Board-Folk/Commodore-PC10-III-Reproduction/images/PC10-BOTH.png

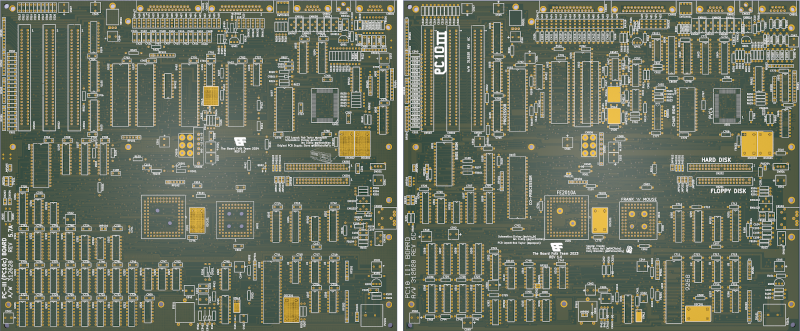
images/PC10-BOTH.png
