Board-Folk/Commodore-PC10-III-Reproduction/images/PC10-REV5-7a-small.png

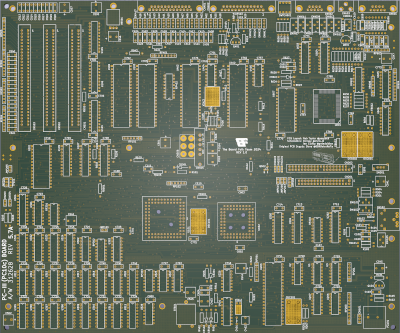
images/PC10-REV5-7a-small.png
