Board-Folk/Commodore-PC10-III-Reproduction/images/PC10-REV6a-small.png

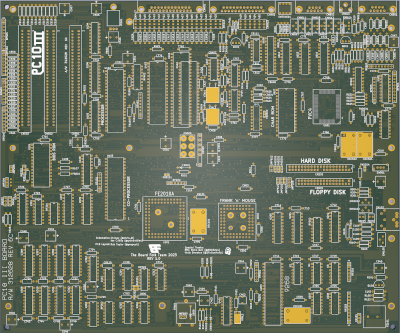
images/PC10-REV6a-small.png
