Board-Folk/Commodore-PC10-III-Reproduction/312628-REV-6C/Schematics/Commodore PC10 III Schematics 312628-Rev6c.pdf

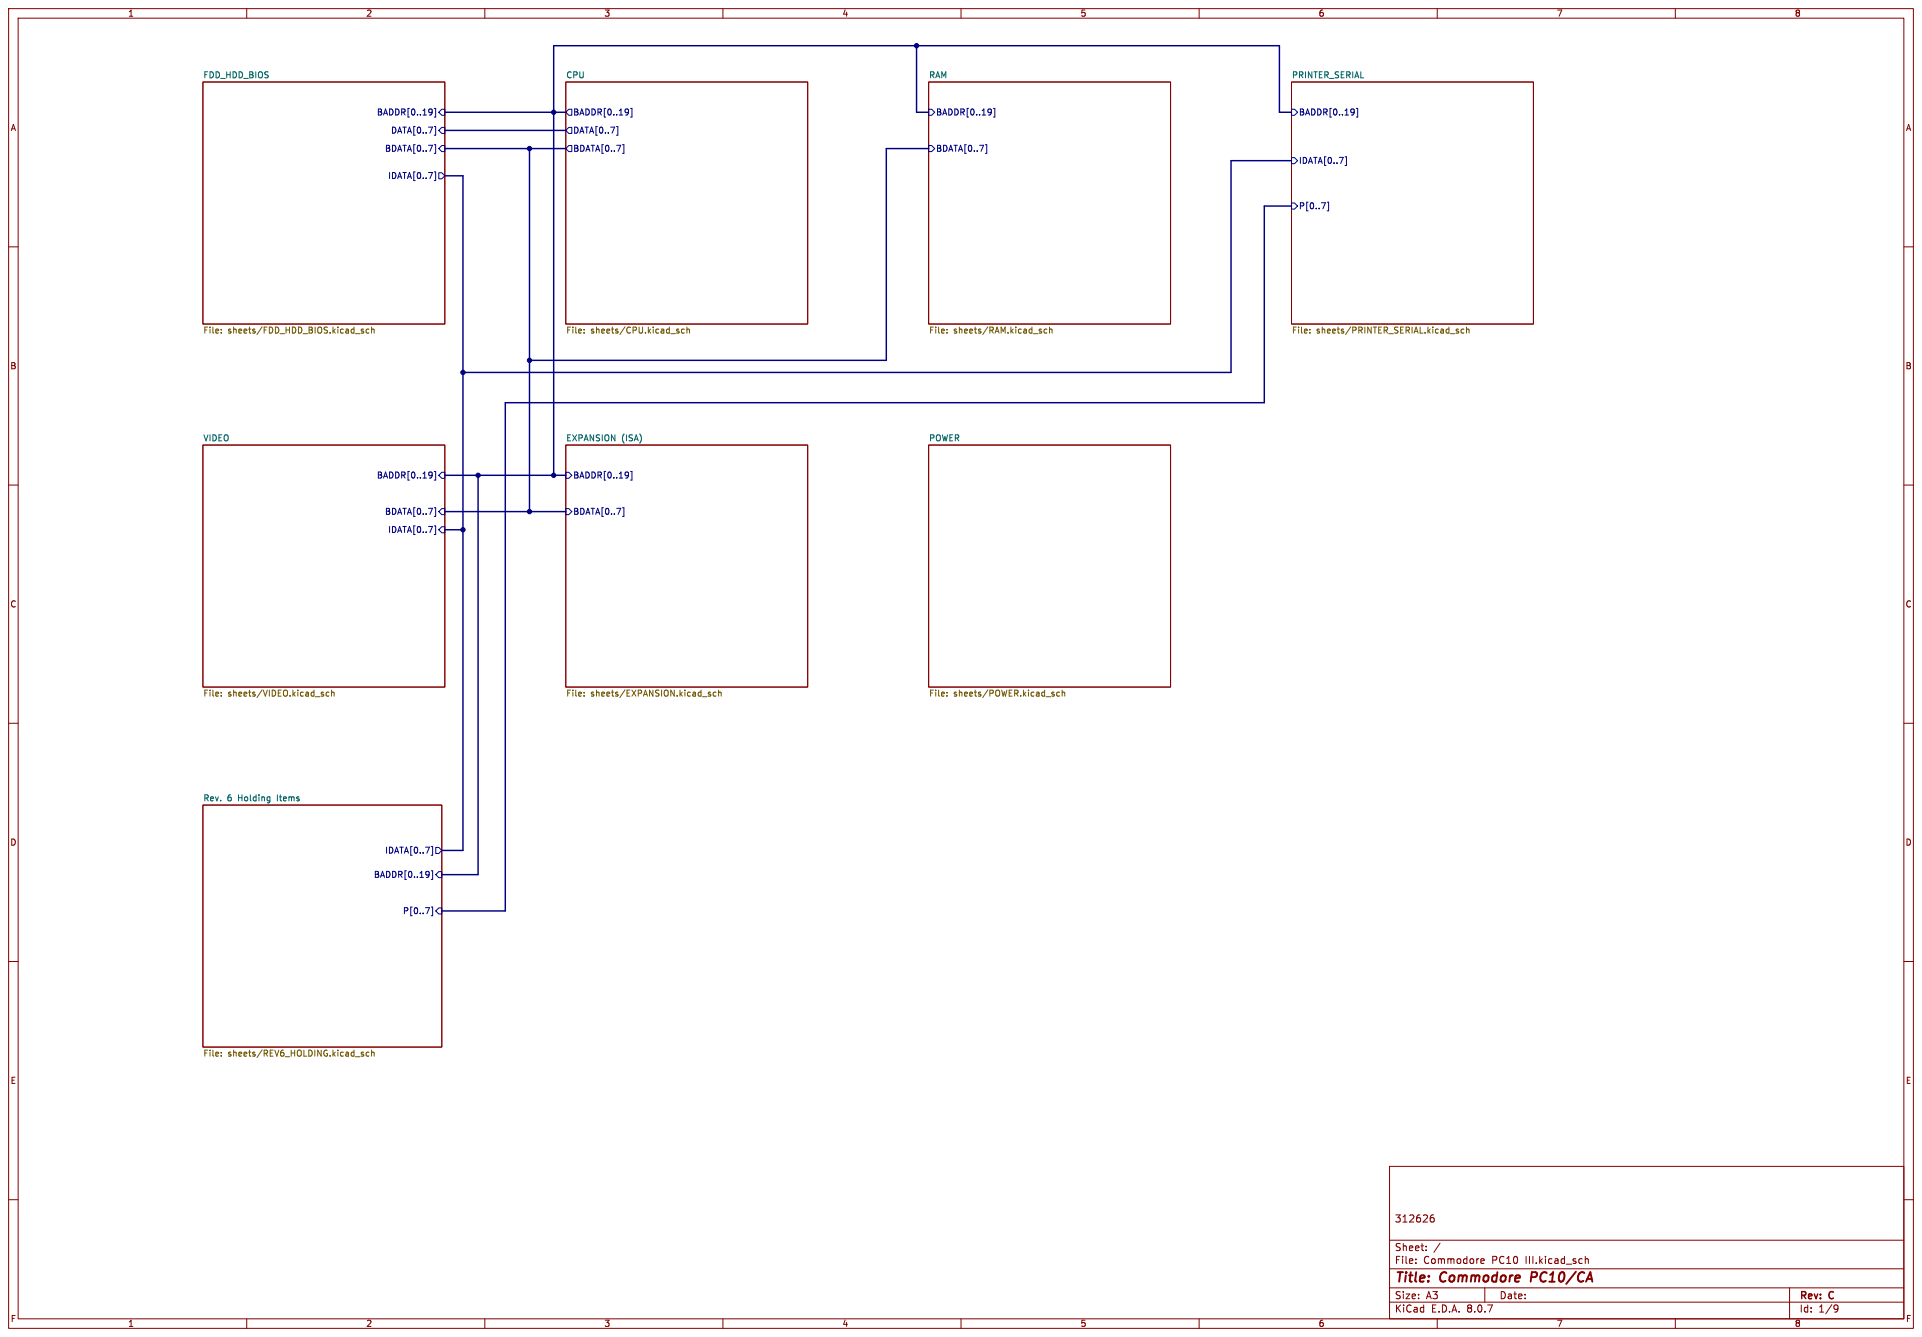
[picture p15: page 1]

File: sheets/RAM.kicad_sch DATA[0..7]
BDATA[0..7]

BADDR[0..19] EXPANSION (ISA) File: sheets/EXPANSION.kicad_sch BADDR[0..19]

P[0..7] Rev. 6 Holding Items File: sheets/REV6_HOLDING.kicad_sch

Id: 1/9 Title: Commodore PC10/CA

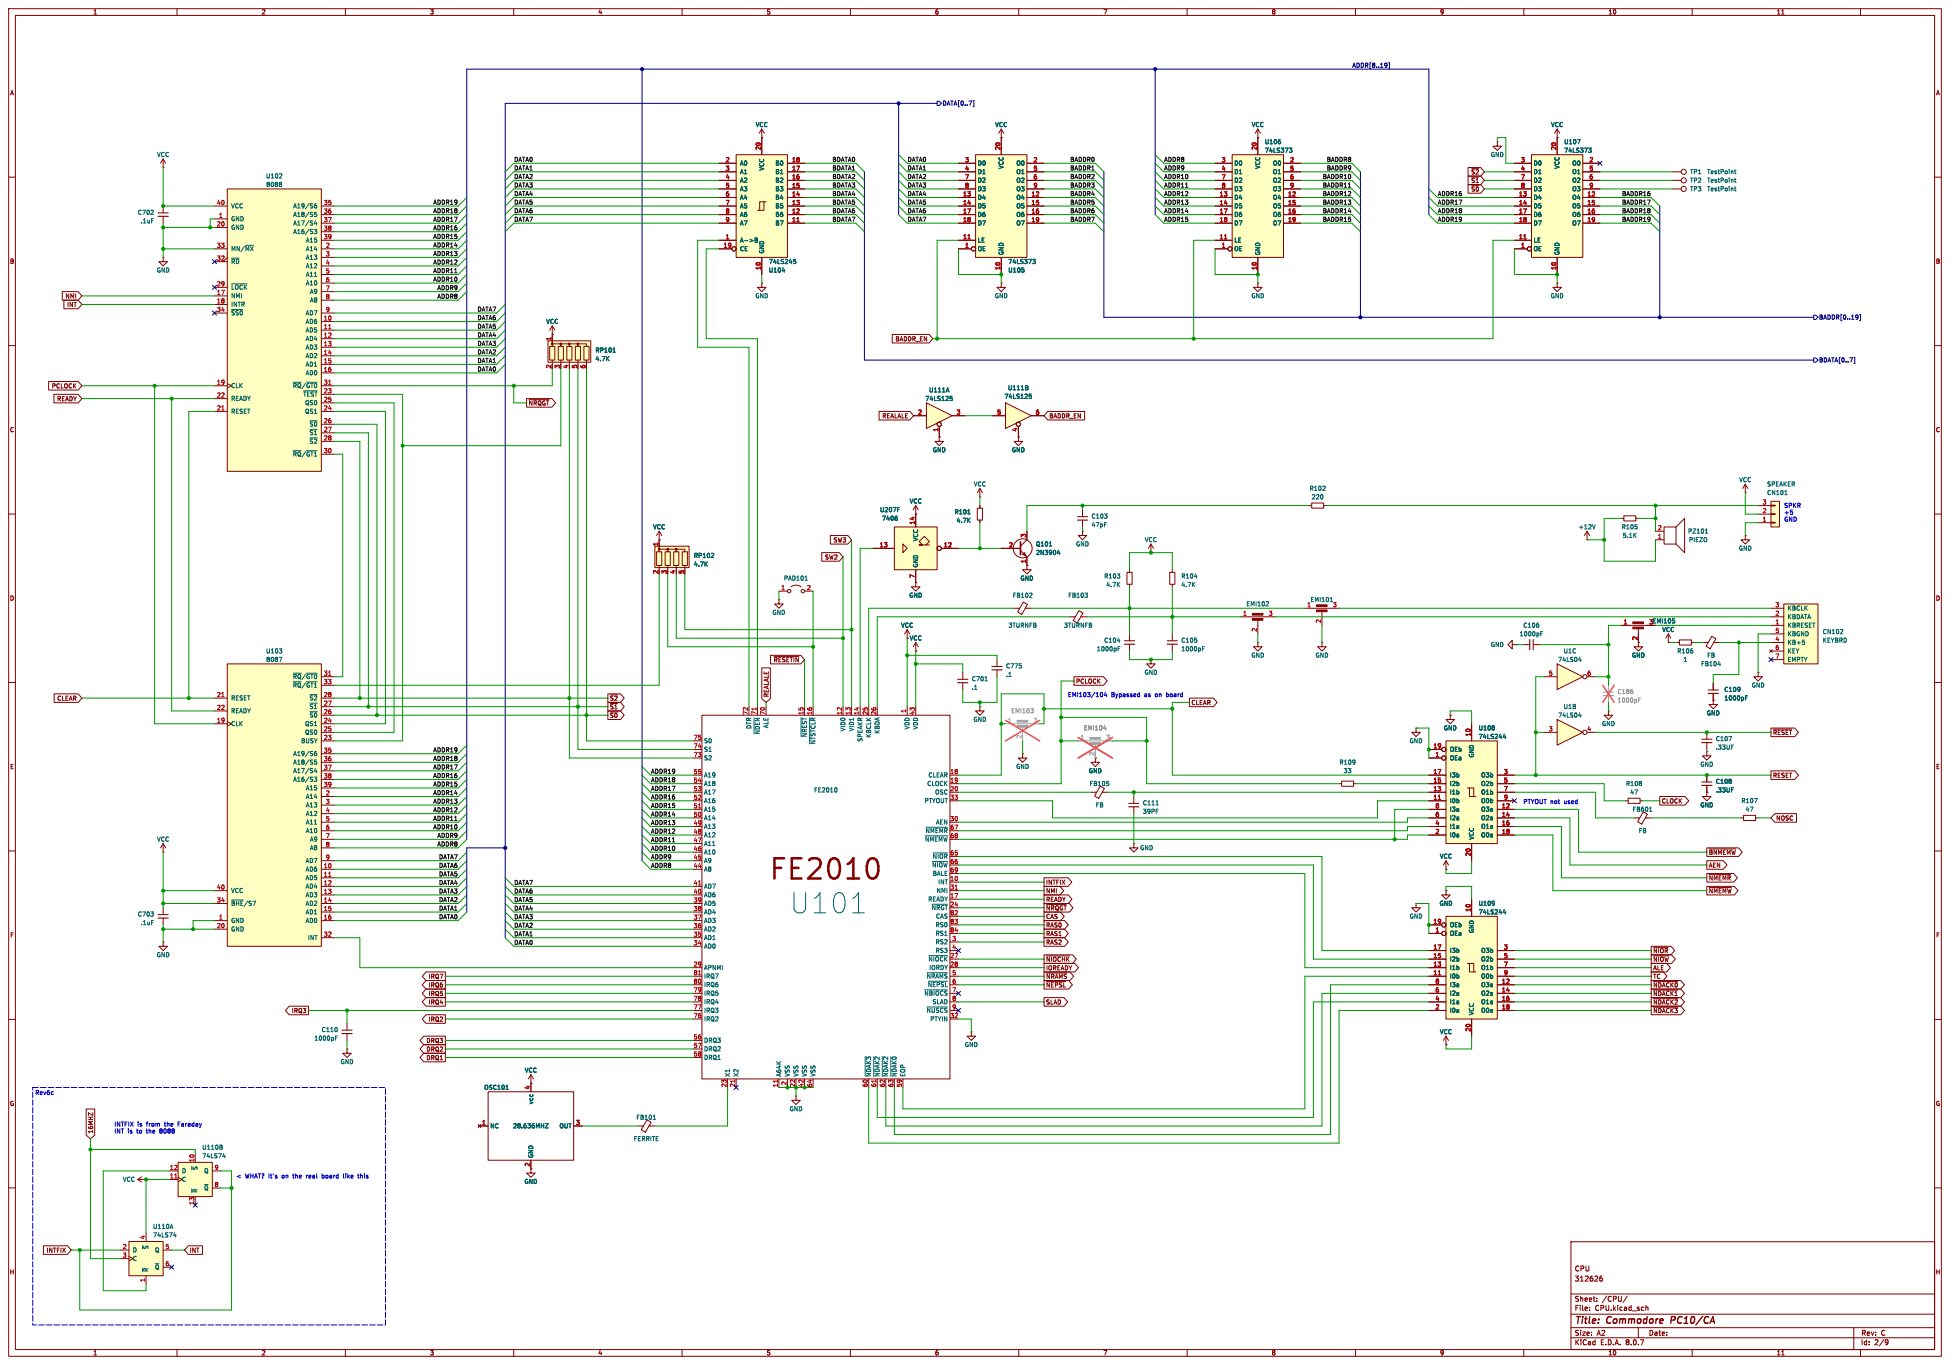
[picture p16: page 2]

~{NIOR} 65 ~{NIOW} 66 ~{NMEMR} 67 ~{NMEMW} 68 BALE 69 ~{NBIOCS}7 ALE 70 ~{NDEN} 71 DTR 72 S2 73 S1 74 S0 75

2 OUT 3 vcc 4 VCC GND

< WHAT? It's on the real board like this Rev6c

INTFIX is from the Faraday
INT is to the 8088
VCC ~{R} 1 D

File: CPU.kicad_sch Sheet: /CPU/ 312626 CPU

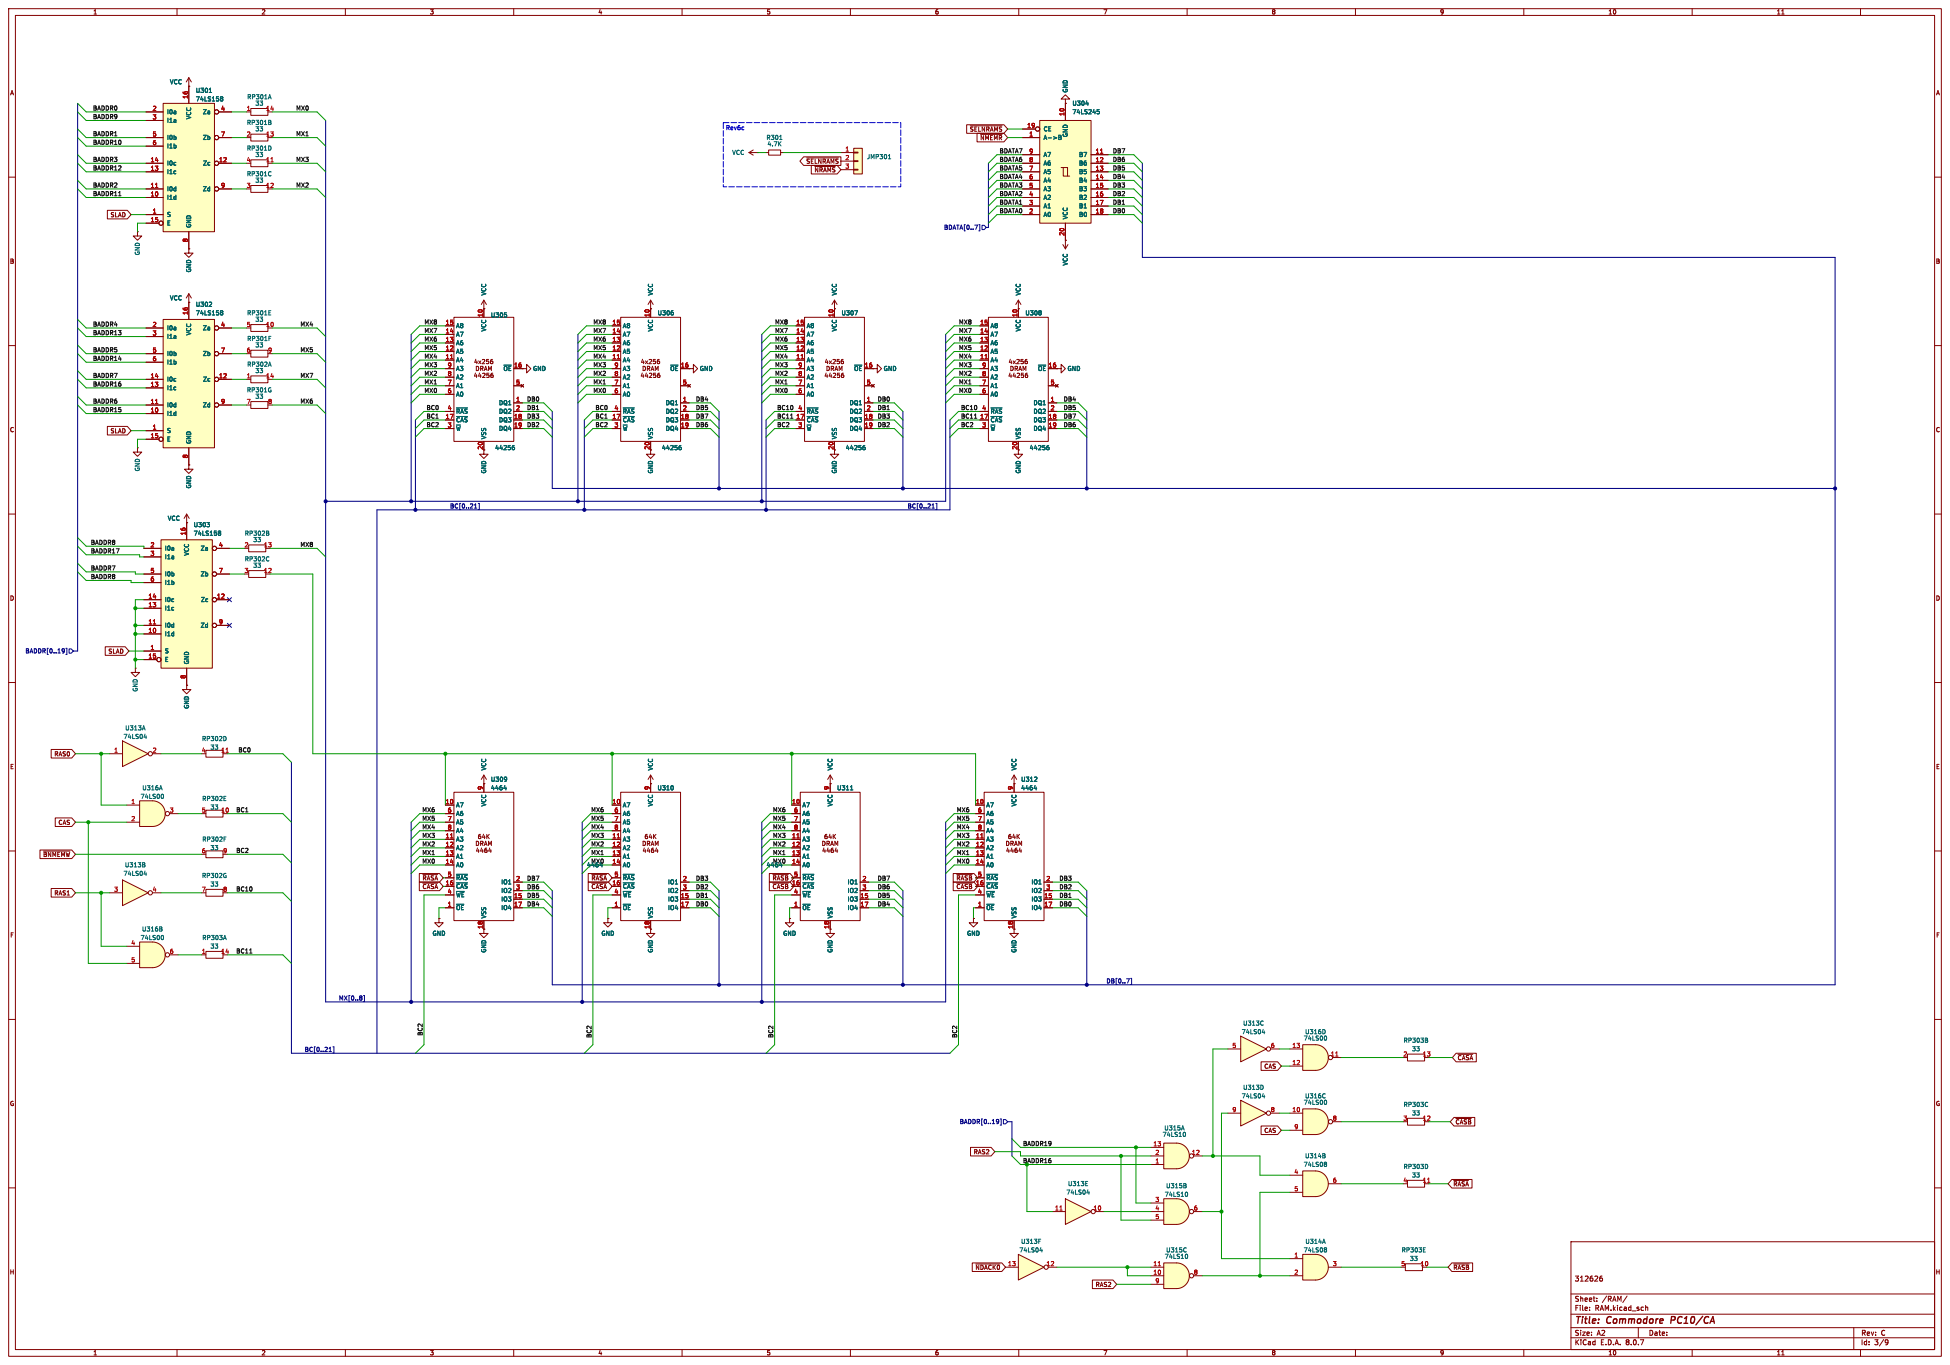
[picture p17: page 3]

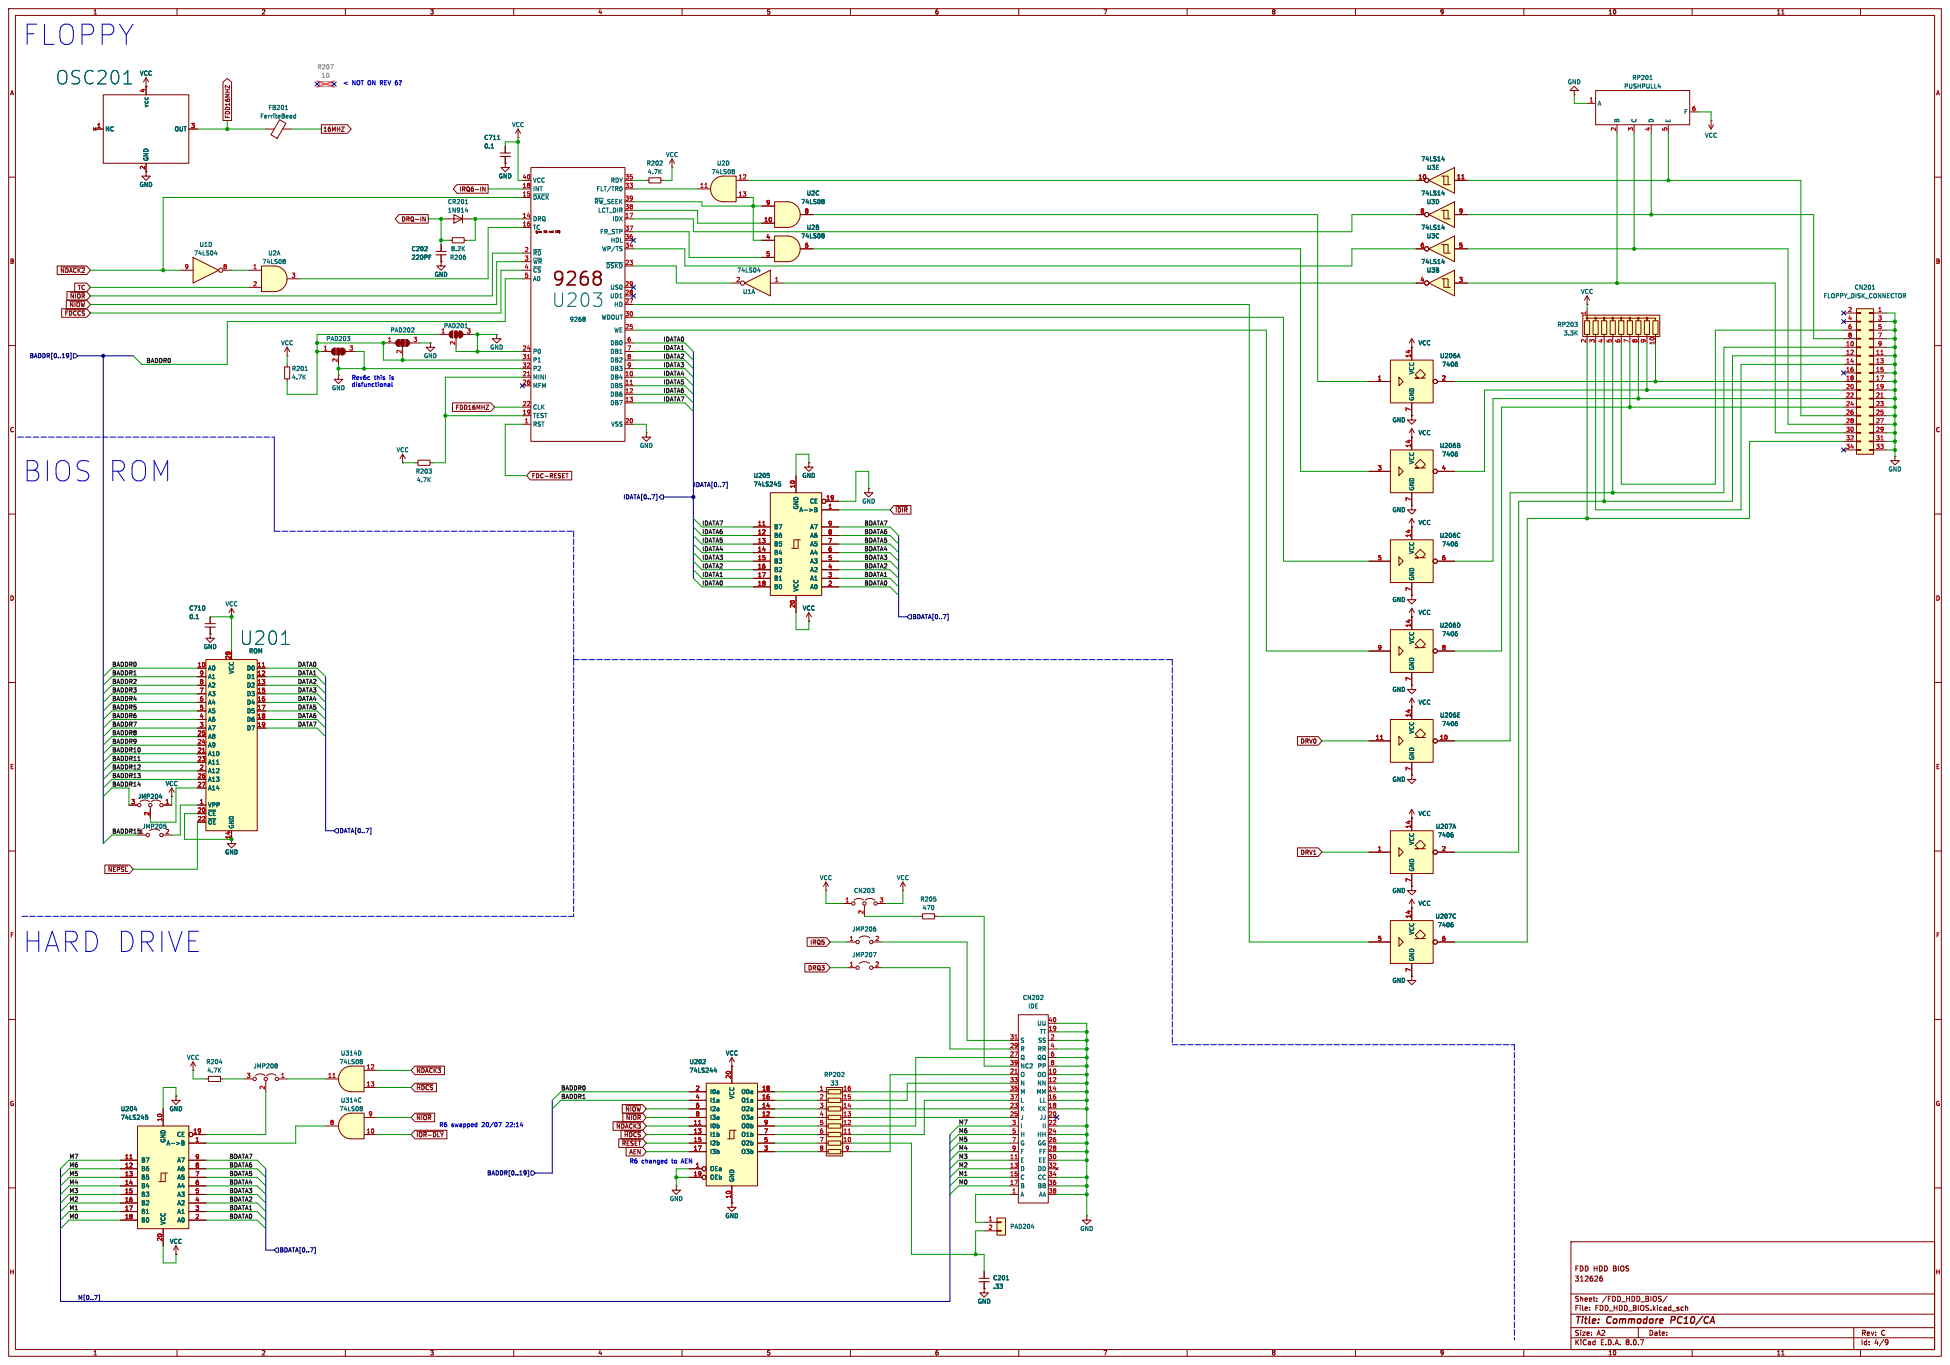
[picture p18: page 4]

R6 changed to AEN < NOT ON REV 6? HARD DRIVE

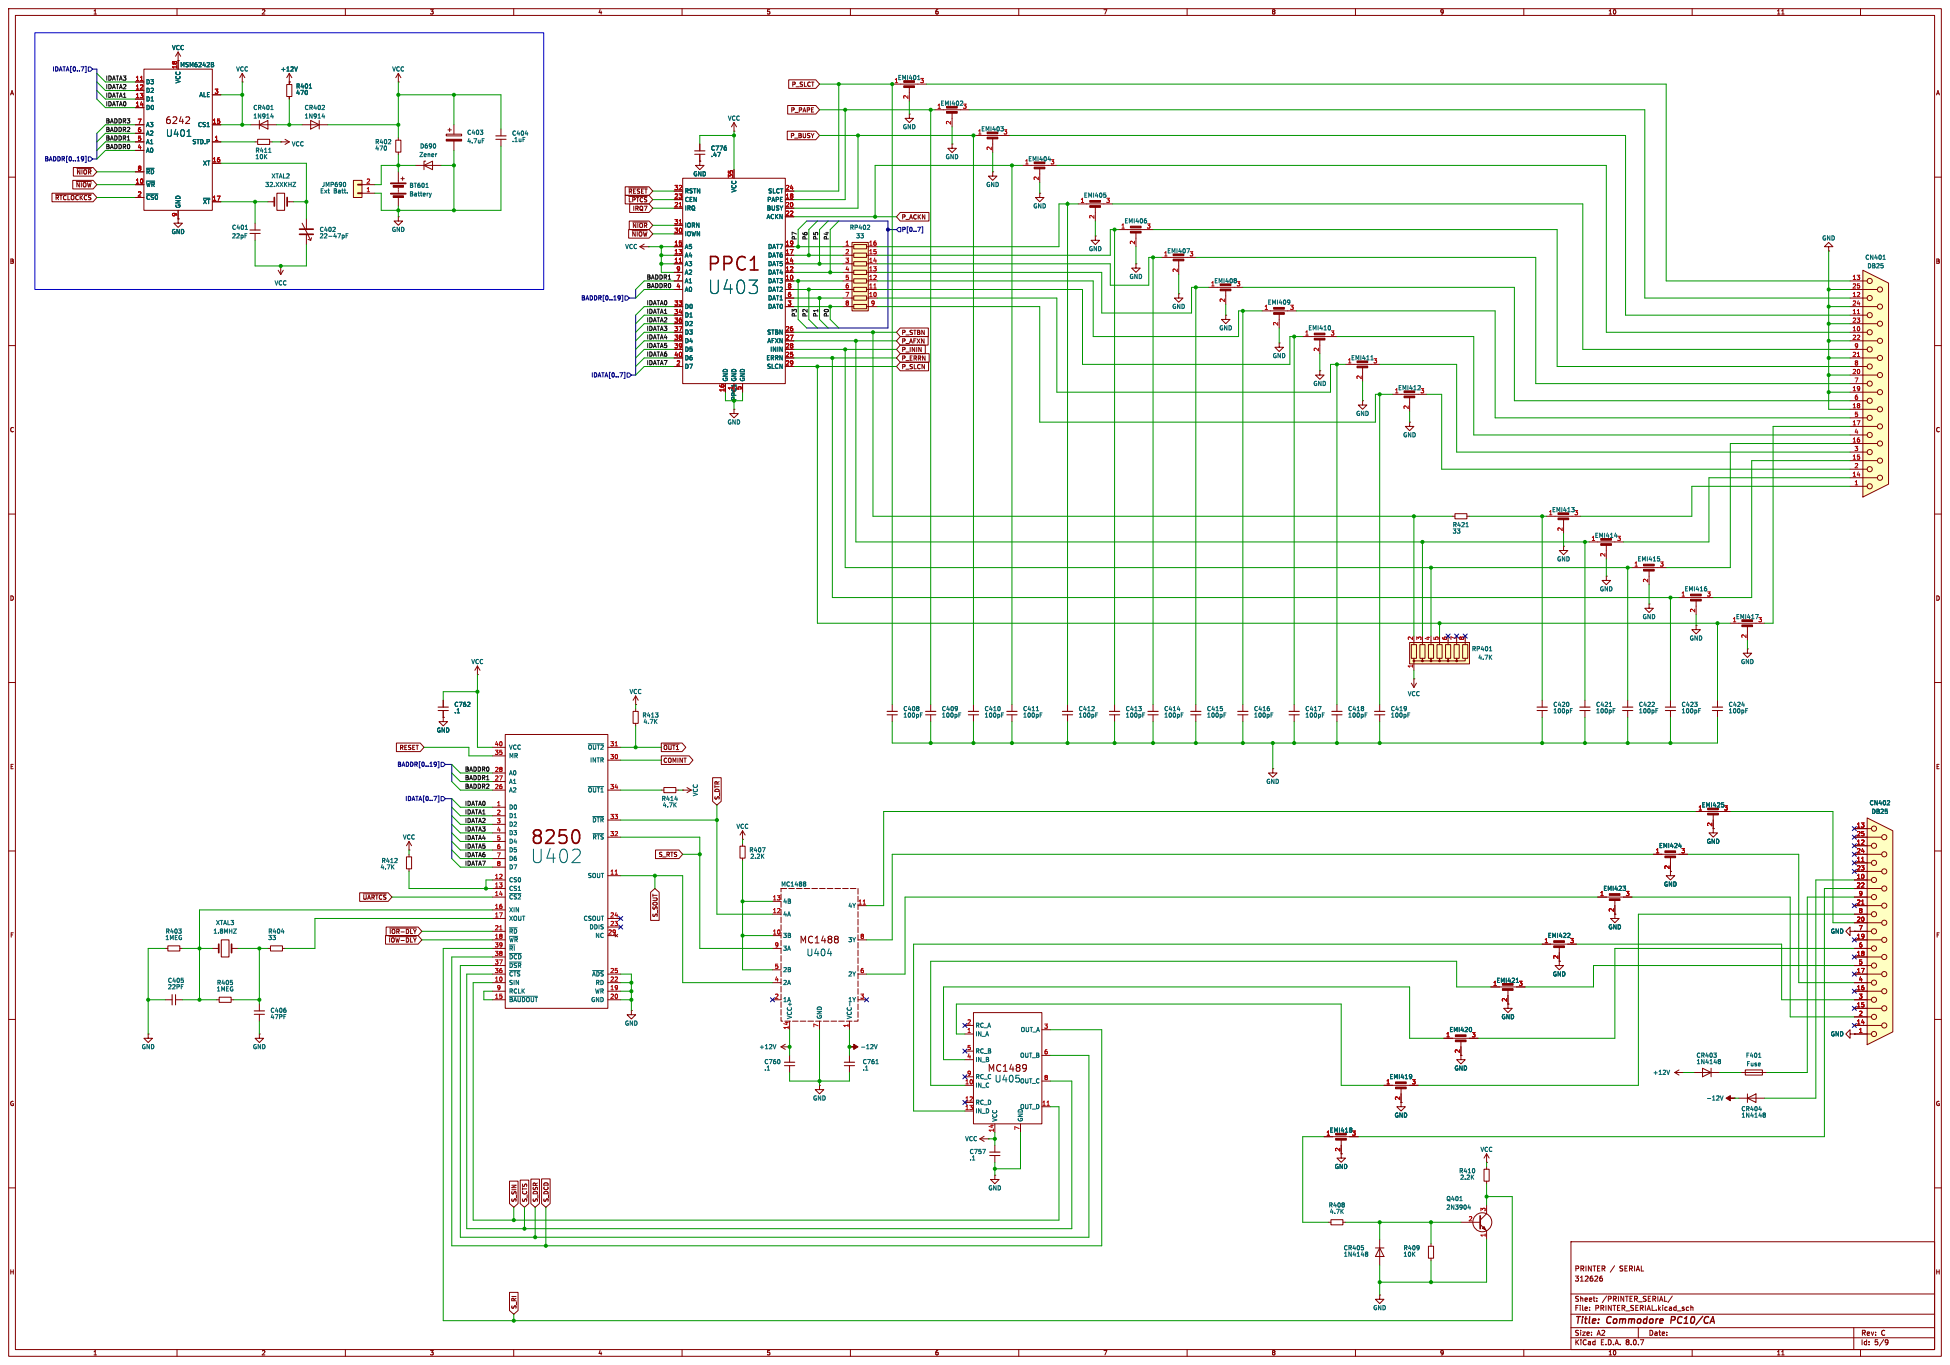
[picture p19: page 5]

1 DAT3 10 A3 11 DAT4 12 A4 13 DAT5 14 A5 15 GND 16 DAT6 17 PAPE 18 DAT7 19 D7 2 BUSY 20 IRQ 21 ACKN 22 CEN 23 SLCT 24 ERRN 25 STBN 26 AFXN 27

File: PRINTER_SERIAL.kicad_sch Sheet: /PRINTER_SERIAL/ 312626 PRINTER / SERIAL

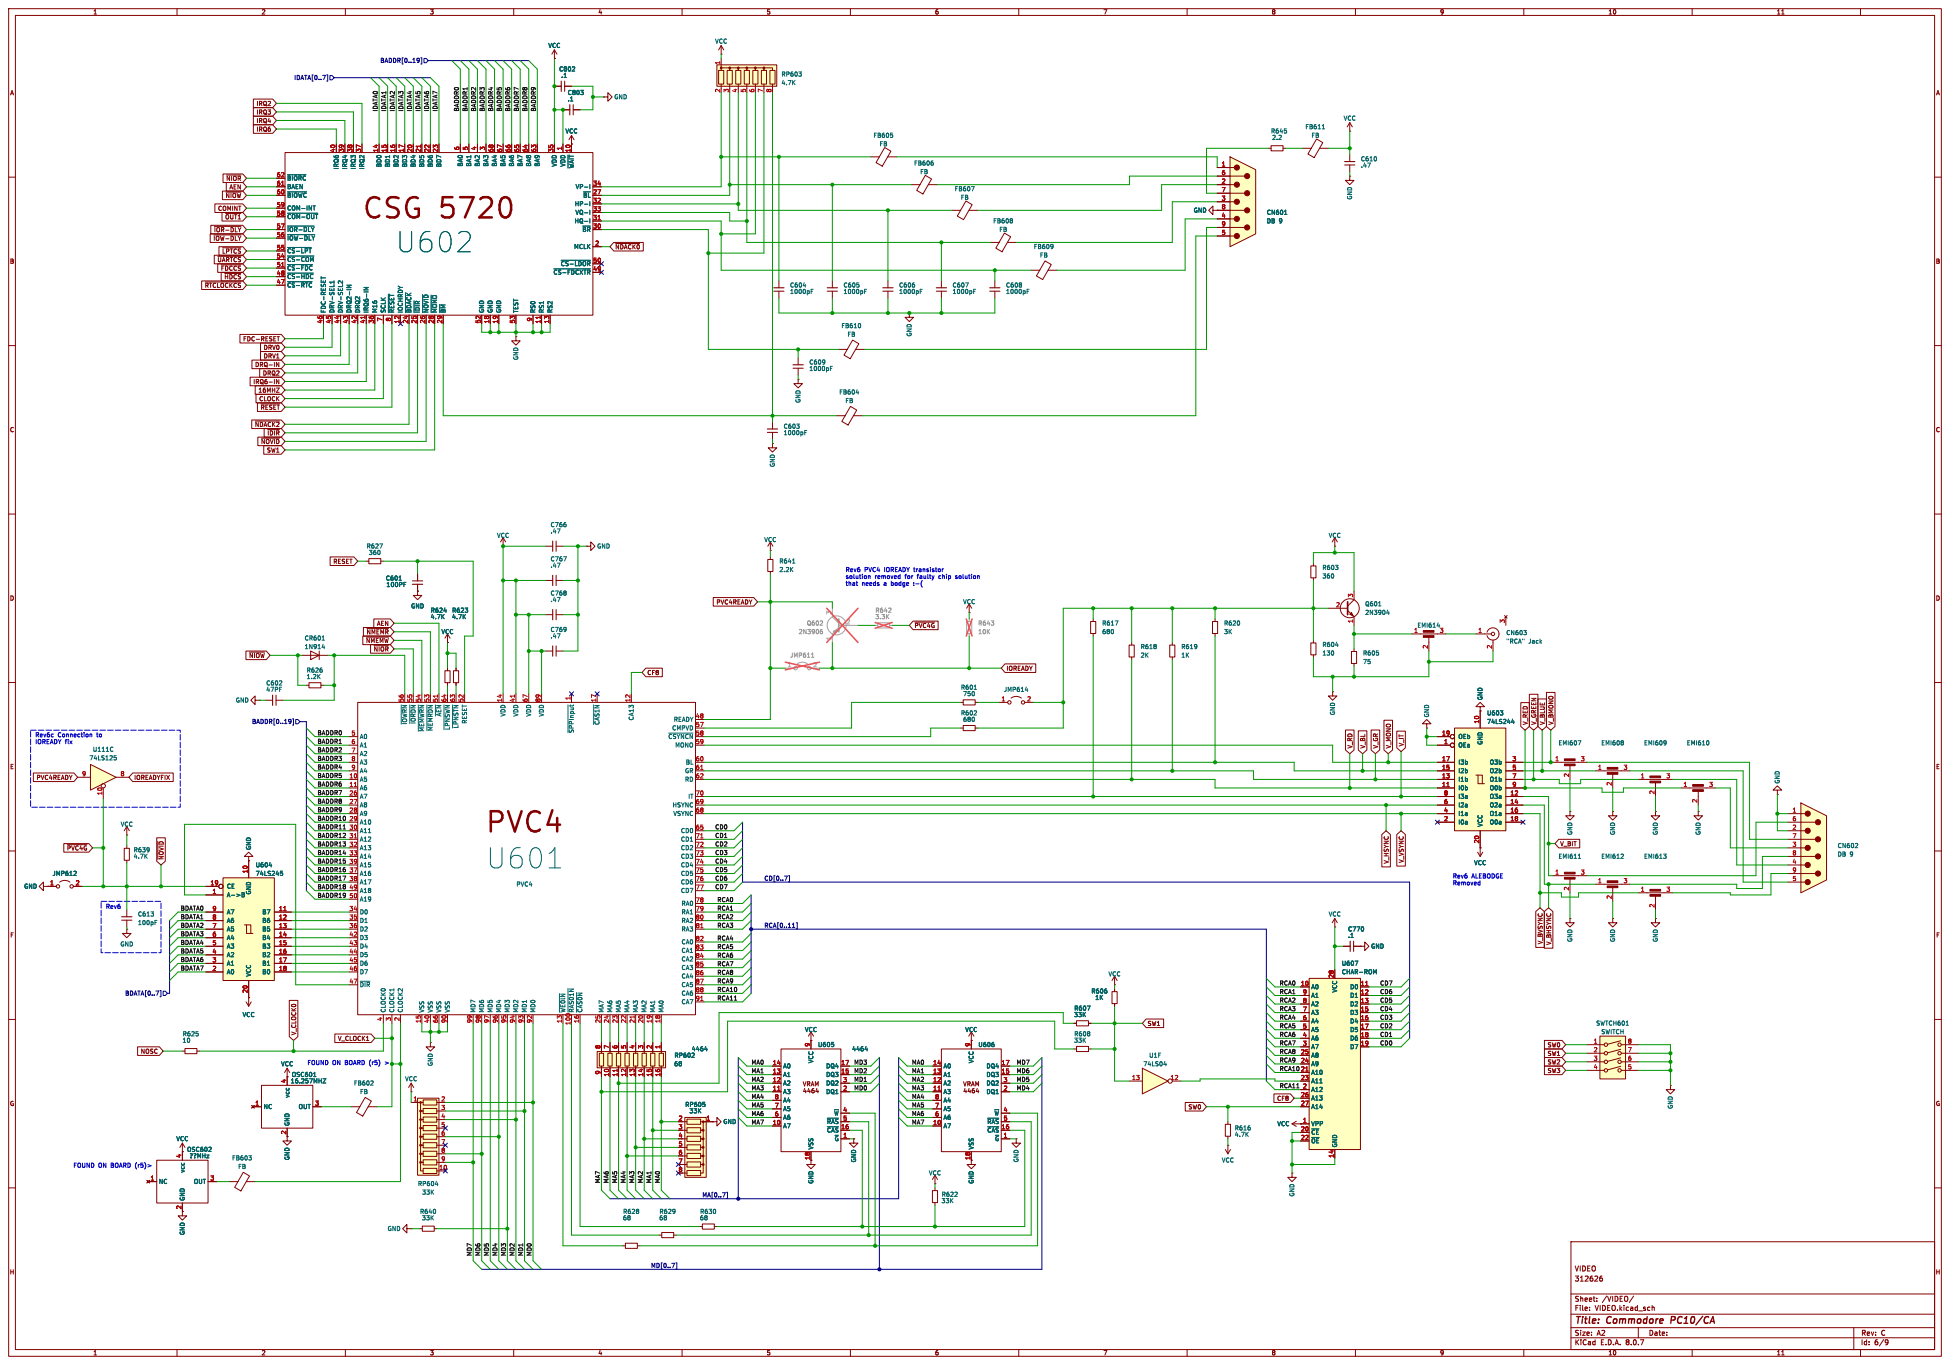
[picture p20: page 6]

6 ~{BIOWC} 60 BAEN 61 ~{BIORC} 62 BA9 63 BA8 64 BA7 65 BA6 66 BA5 67 BA4 68 SCLK

5 ~{CS-LDOR}50 ~{CS-FDC} 51 GND 52 TEST 53

4 IRQ6 40 IRQ6-IN 41 DRQ2 42 DRQ2-IN 43 DRV-SEL2 44 DRV-SEL1 45 FDC-RESET 46

3 ~{BR} 30 HQ-I 31 HP-I 32 VQ-I 33 VP-I 34 VDD 35 M16 36 IRQ2 37 IRQ3 38 IRQ4 39 BA2

1 ~{WAIT} 10 RS1 11 IOCHRDY 12 RS2 13 BD0 14 BD1 15 BD2 16 BD3 17 GND 18 GND 19 BD4 20 BD5 21 BD6 22 BD7 23 ~{BDACK} 24 ~{IDIR} 25 ~{NOVID} 26

4 VSS 40 VDD 41 D3 42 D4 43 D5 44 D6 45 D7 46 ~{DIR} 47 READY 48 A18 49 A0 5 A19 50 ~{AEN} 51 RESET 52 ~{MEMRDN} 53 ~{MEMWRN} 54 ~{IORDN} 55 ~{IOWRN} 56 CMPVD 57 ~{CSYNCN} 58 MONO 59 A1 6 BL 60 GR 61 RD 62 ~{LPNSTN}63 ~{LPNSWN} 64 CD0 65 VSS 66 VDD 67 VSYNC 68 HSYNC 69 A2 7

File: VIDEO.kicad_sch Sheet: /VIDEO/ 312626 VIDEO

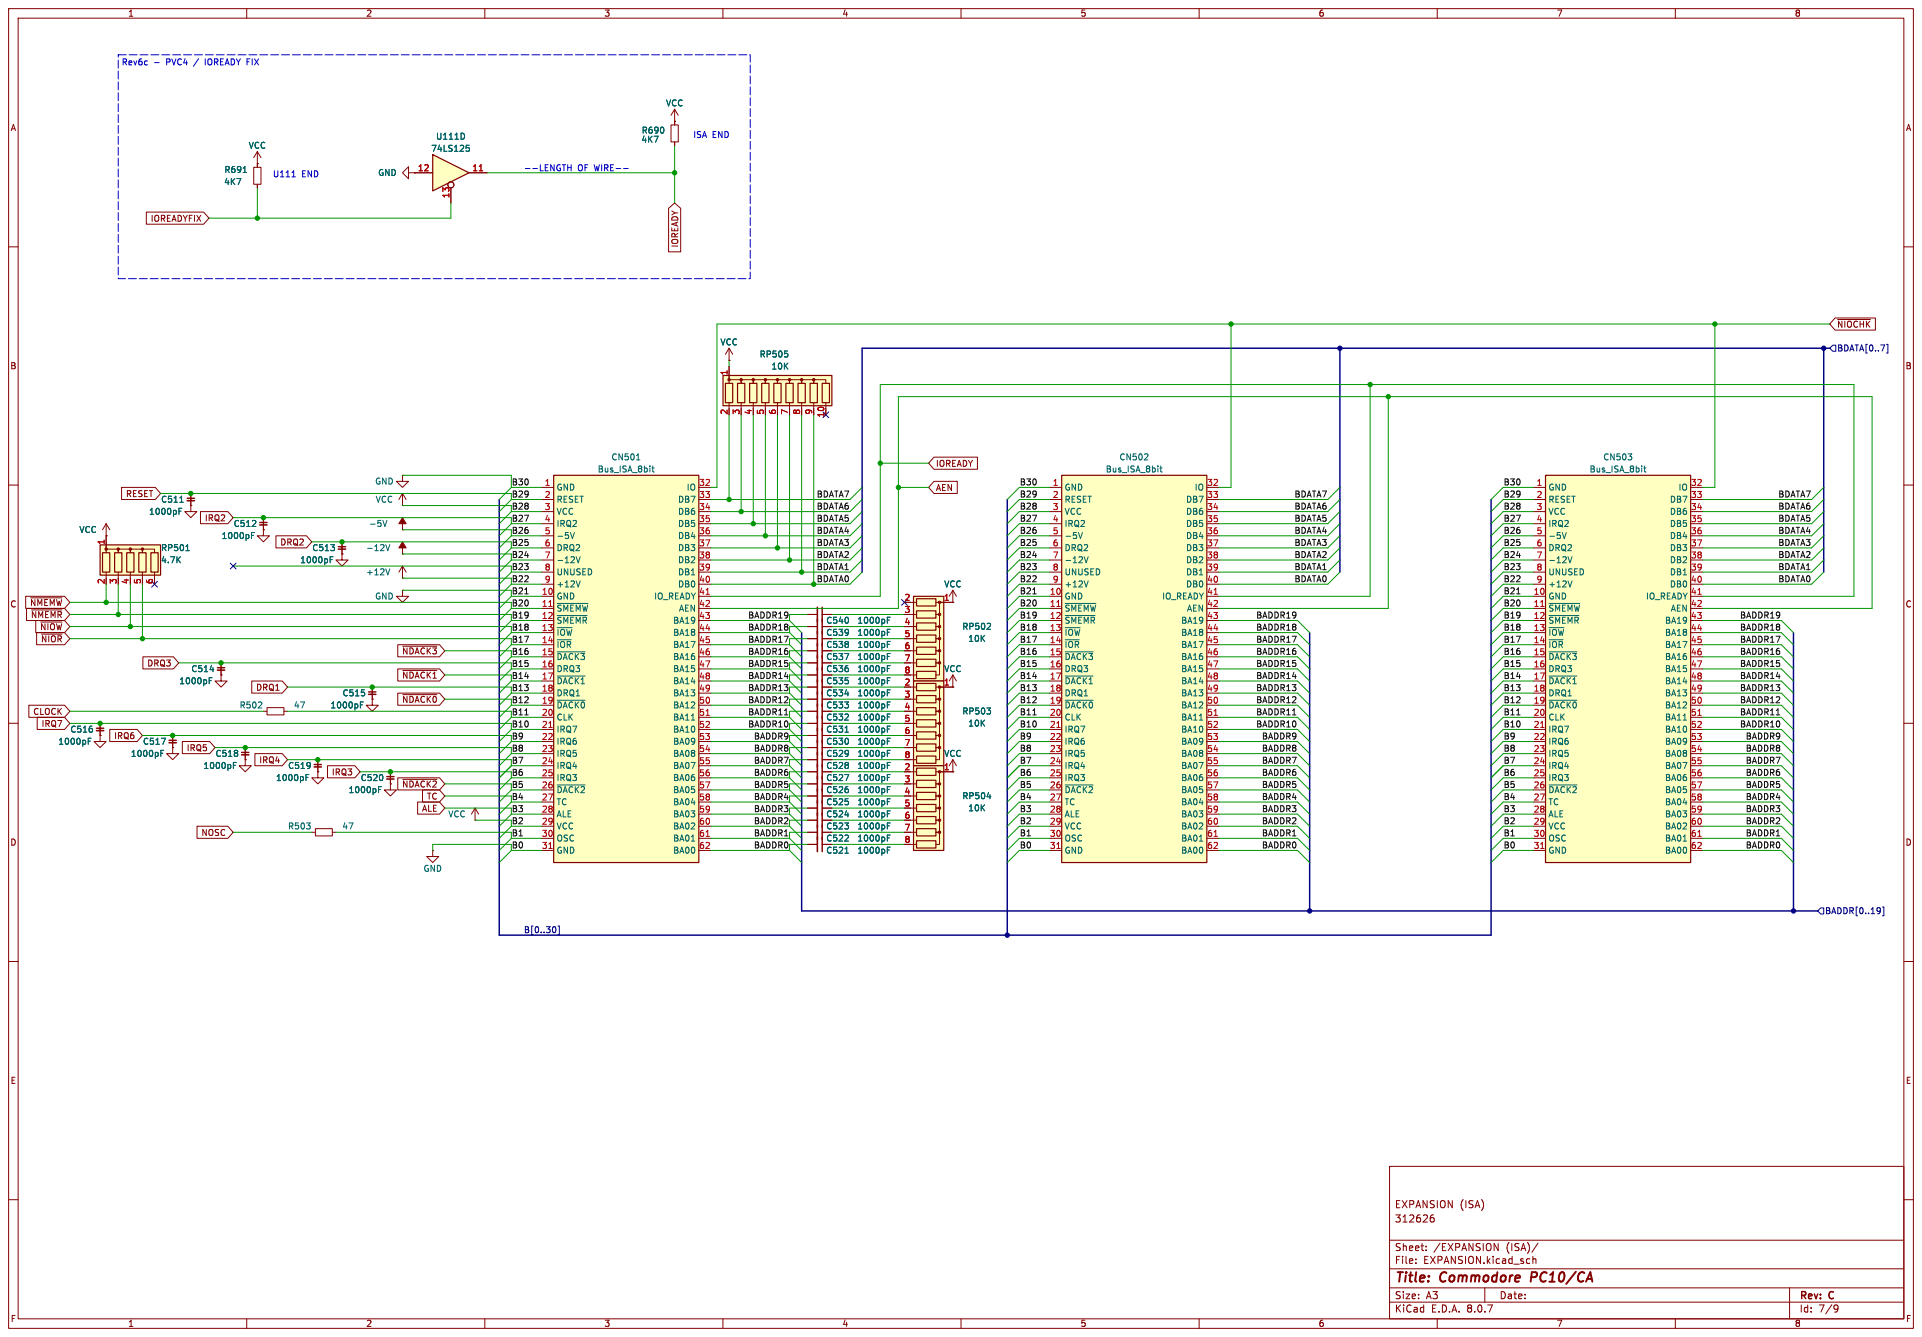
[picture p21: page 7]

10K C522 1000pF GND 1 GND 10 ~{SMEMW} 11 ~{SMEMR} 12 ~{IOW} 13 ~{IOR} 14 ~{DACK3} 15 DRQ3 16 ~{DACK1} 17 DRQ1 18 ~{DACK0} 19 RESET 2 CLK 20
IRQ3 25 ~{DACK2} 26 TC 27 ALE 28 VCC 29 VCC 3 OSC 30 GND 31
IO_READY 41 AEN 42 BA19 43 BA18 44 BA17 45 BA16 46 BA15 47 BA14 48 BA13 49

Id: 7/9 Title: Commodore PC10/CA

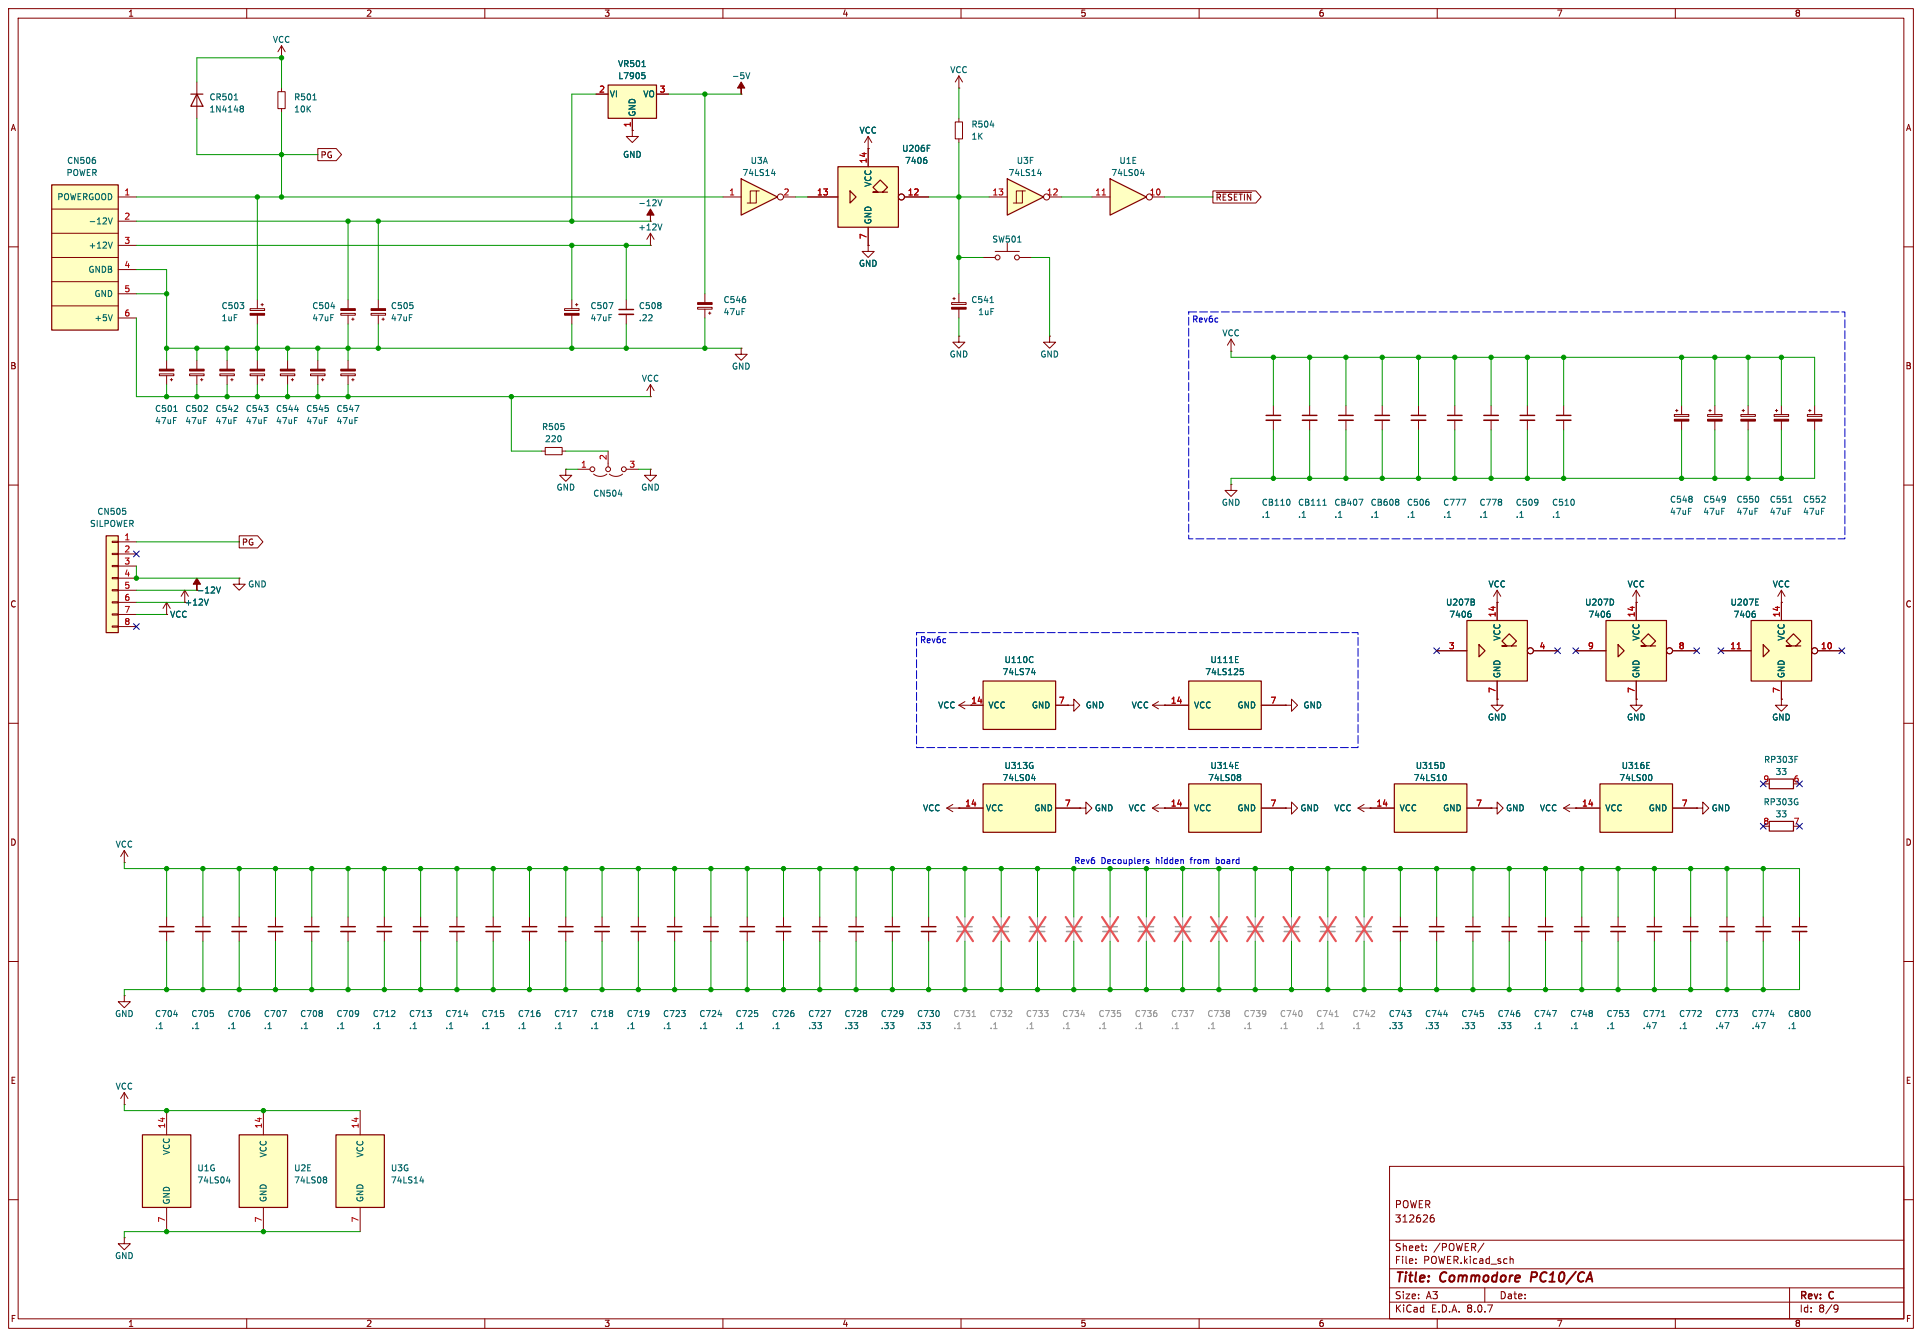
[picture p22: page 8]

Id: 8/9 Title: Commodore PC10/CA

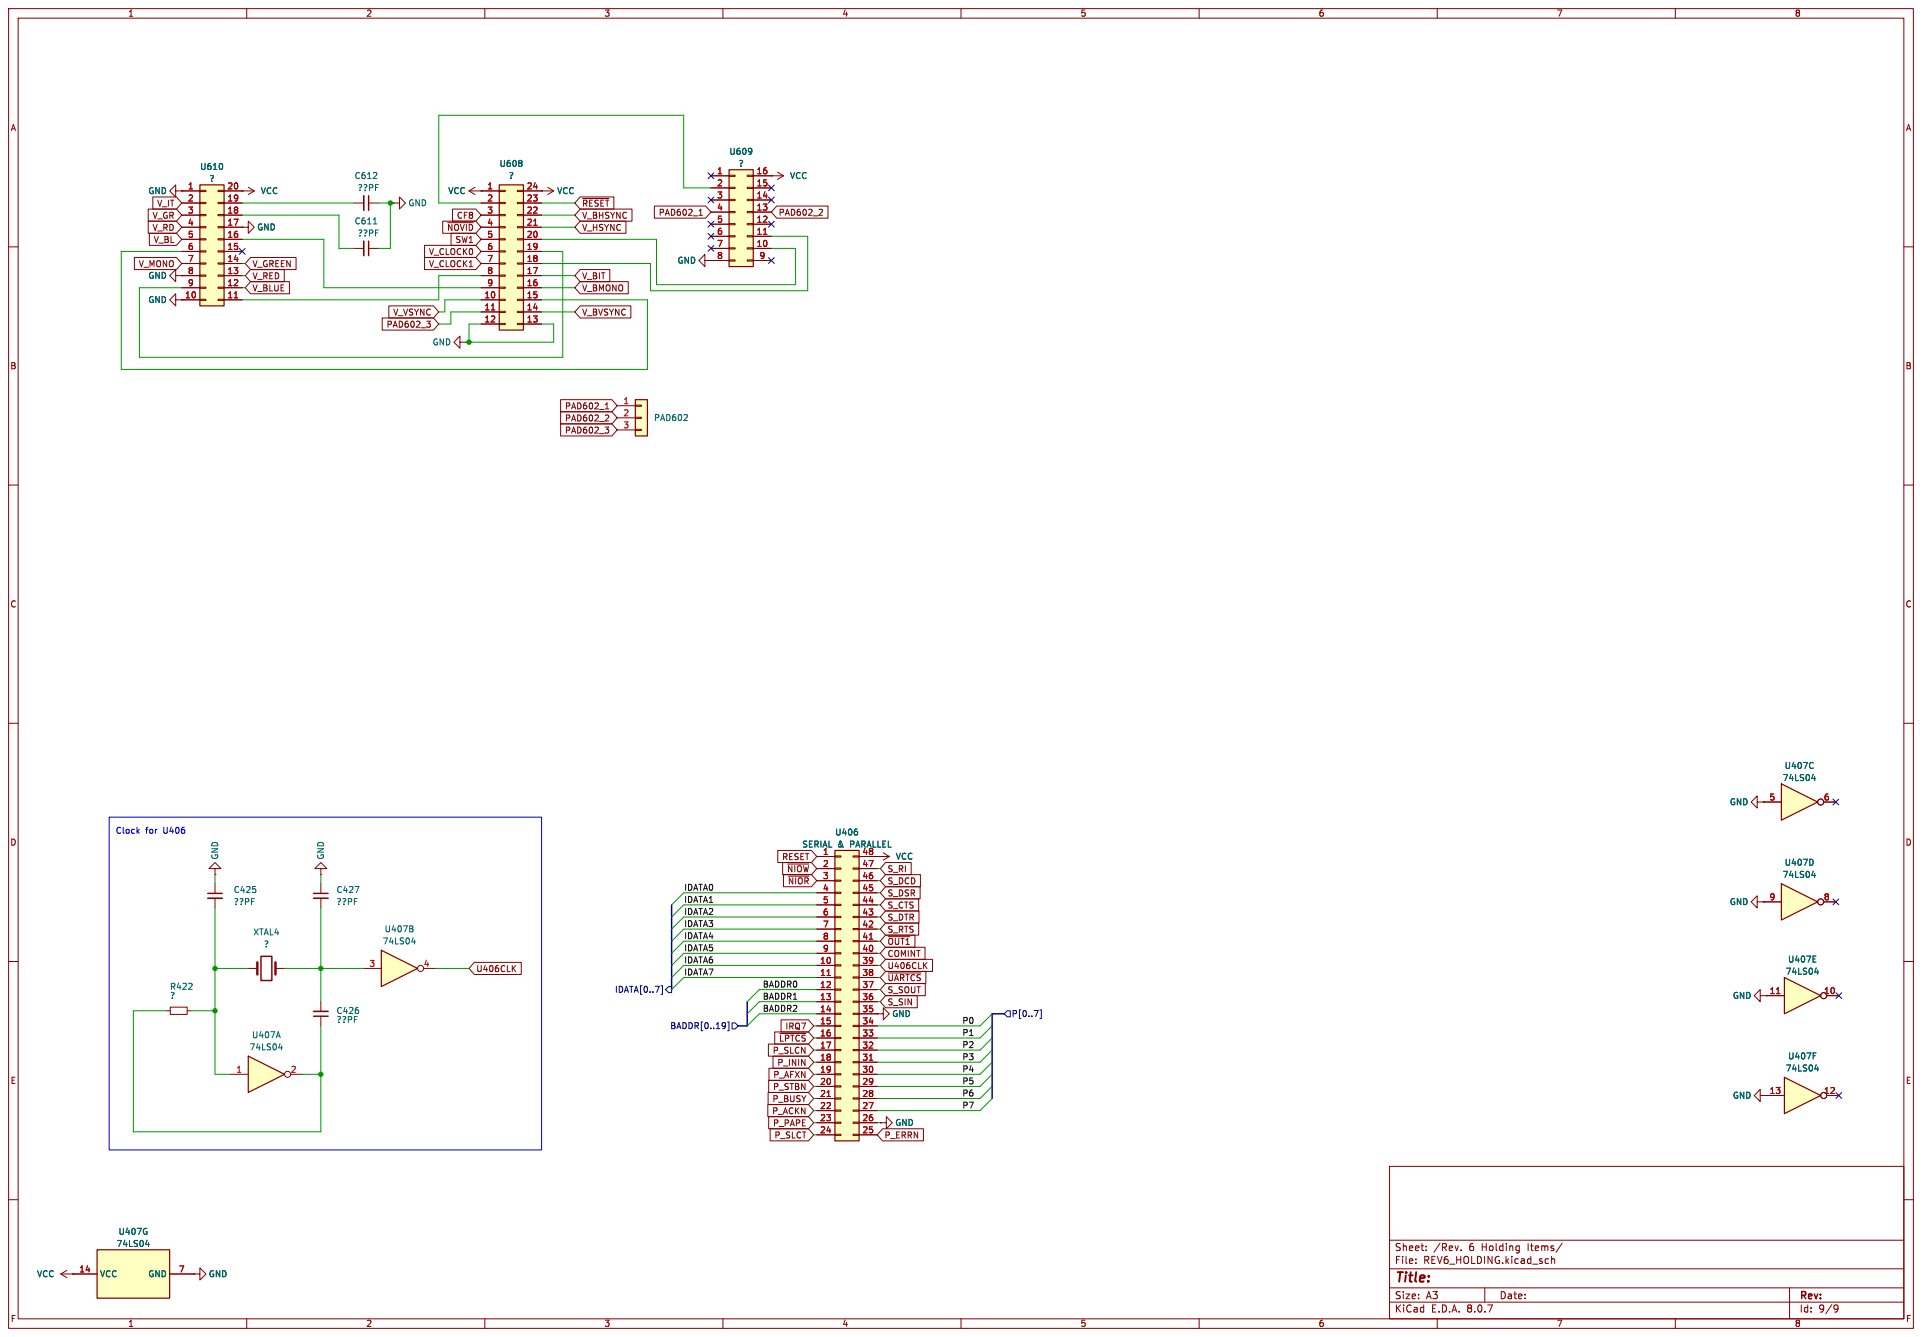
[picture p23: page 9]
