Board-Folk/Commodore-PC10-III-Reproduction/312628-REV-5.7A/bom/Layout.pdf

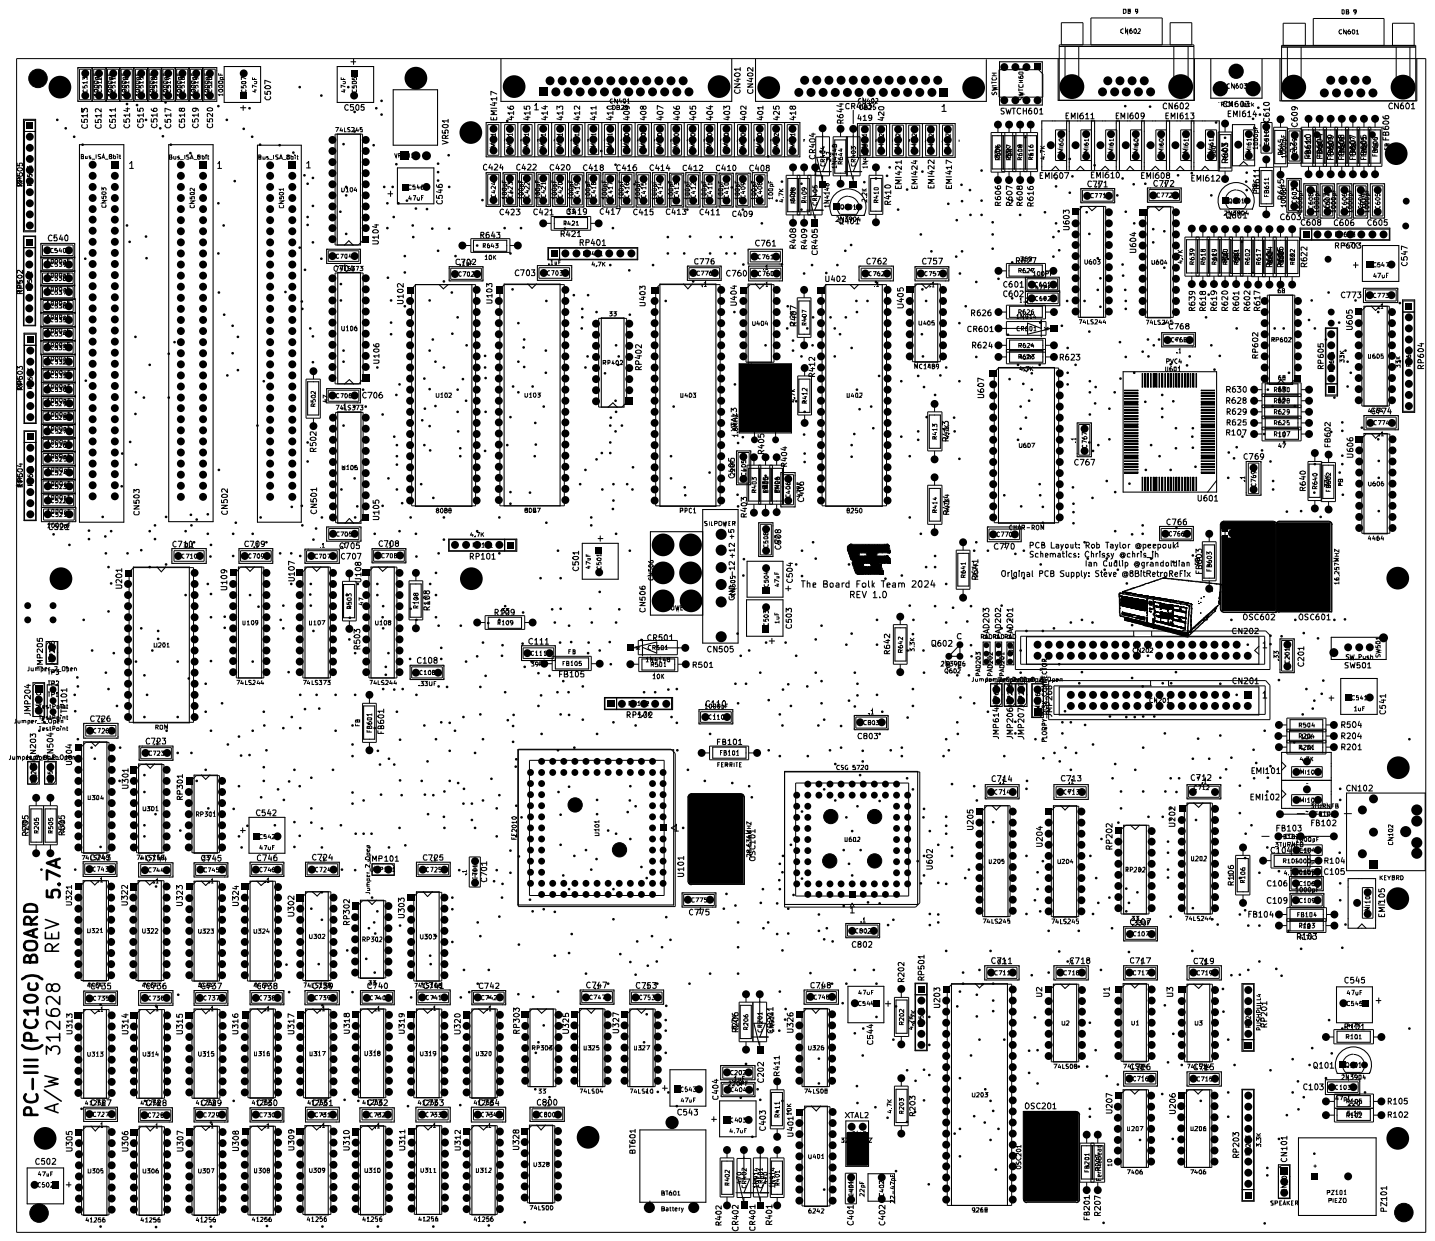
[picture p24: page 1]
