Board-Folk/Commodore-PC10-III-Reproduction/312628-REV-5.7A/sheets/CPU.kicad_sch

## KiCad design 312628-REV-5.7A/sheets/CPU.kicad_sch (2024-12-30)

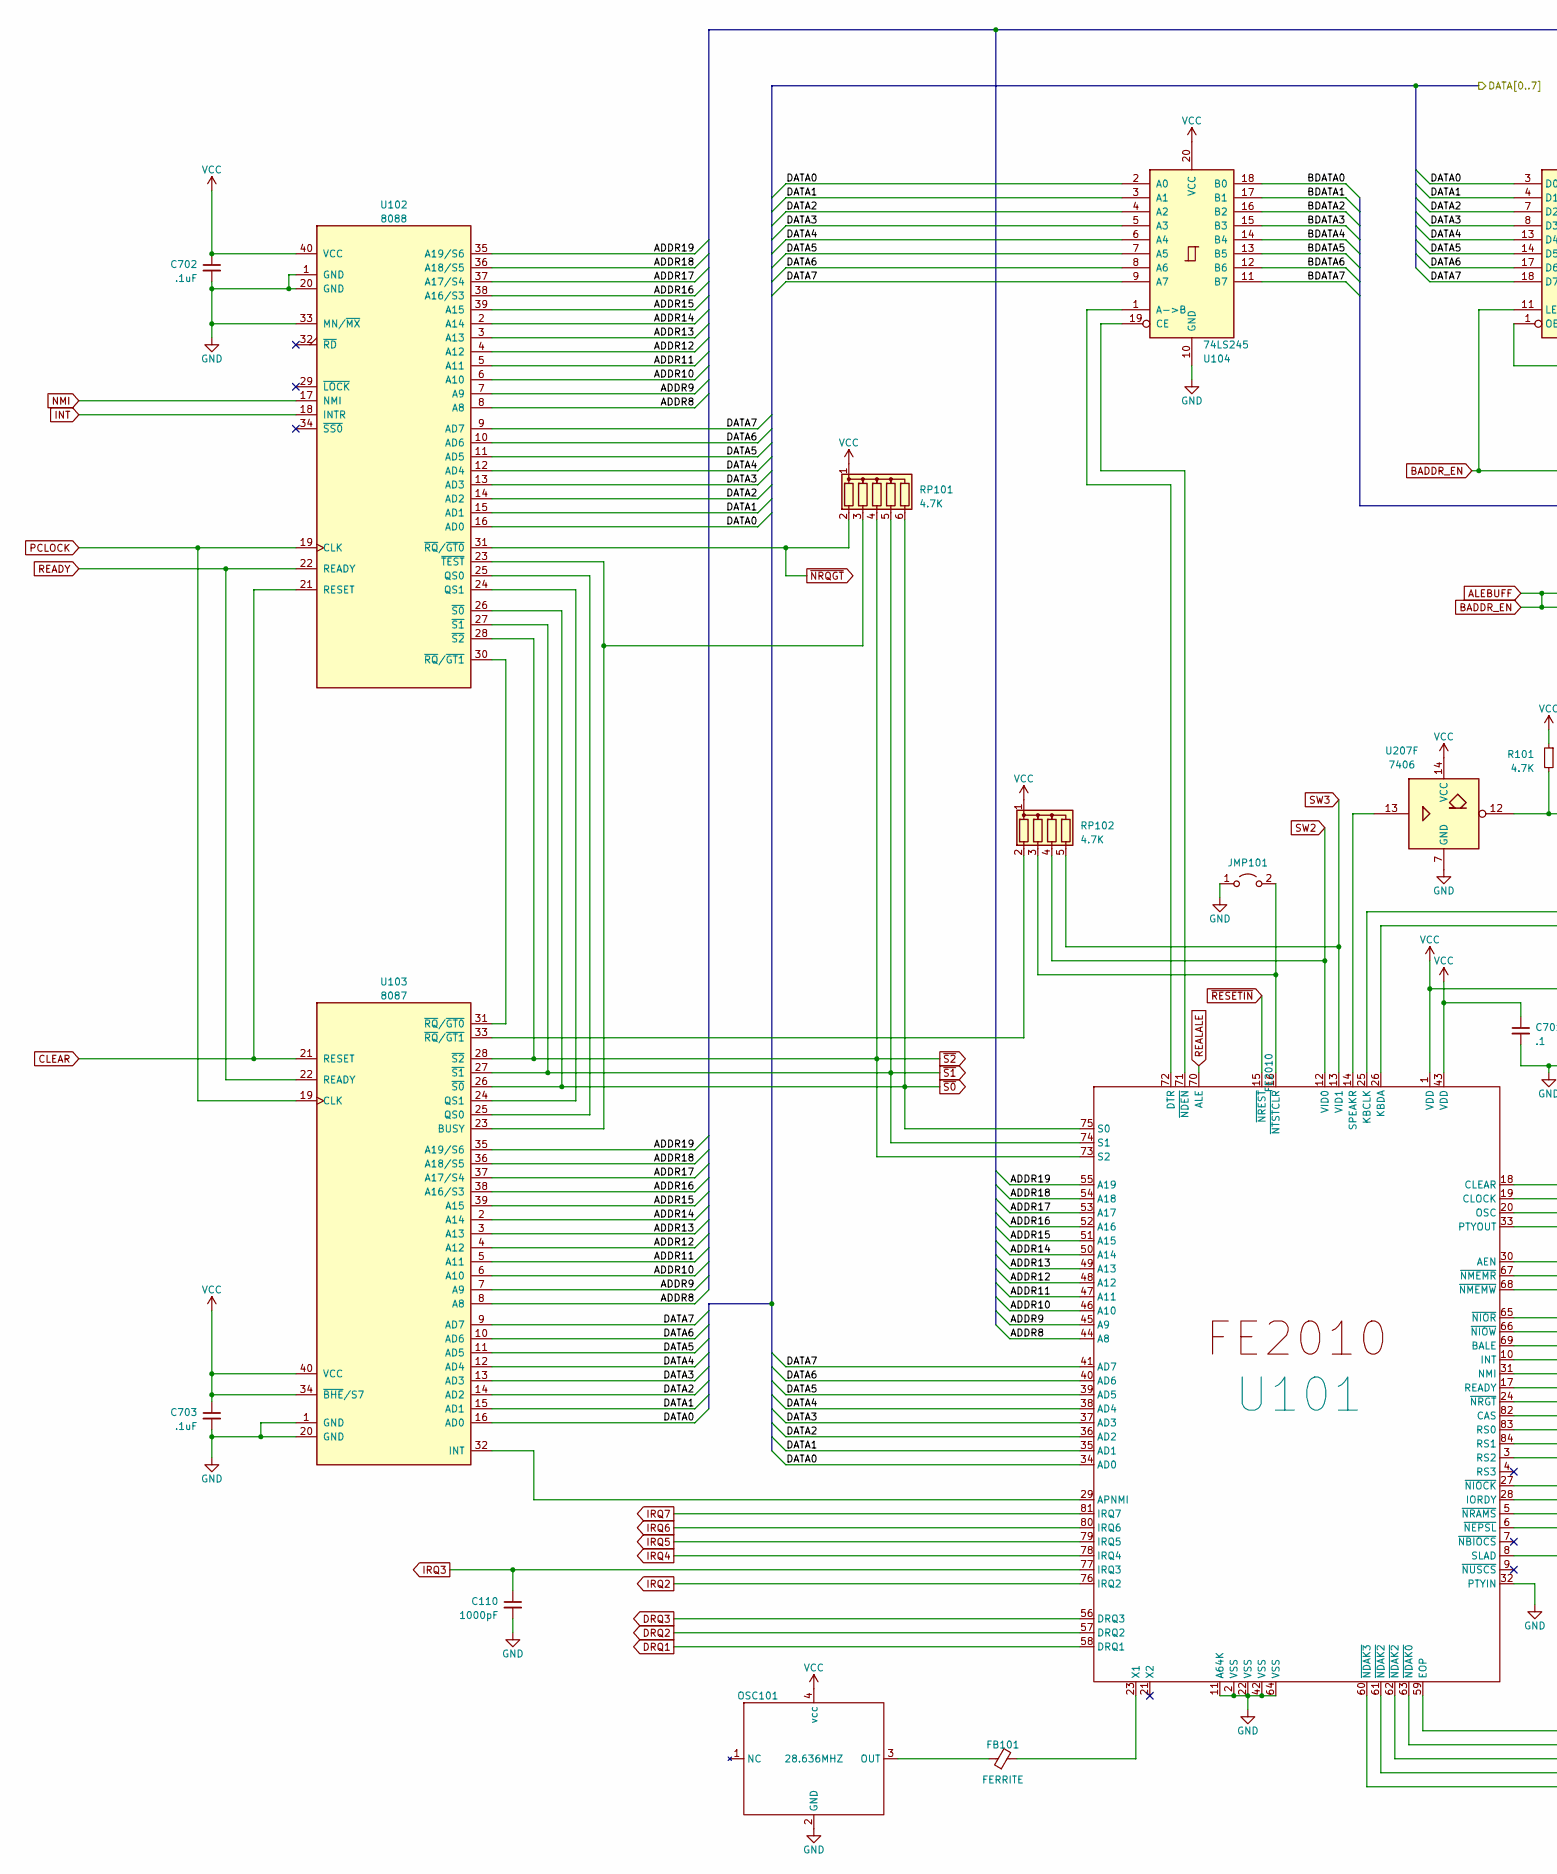
[picture p25: schematic CPU.kicad_sch, part in row 1, column 1]

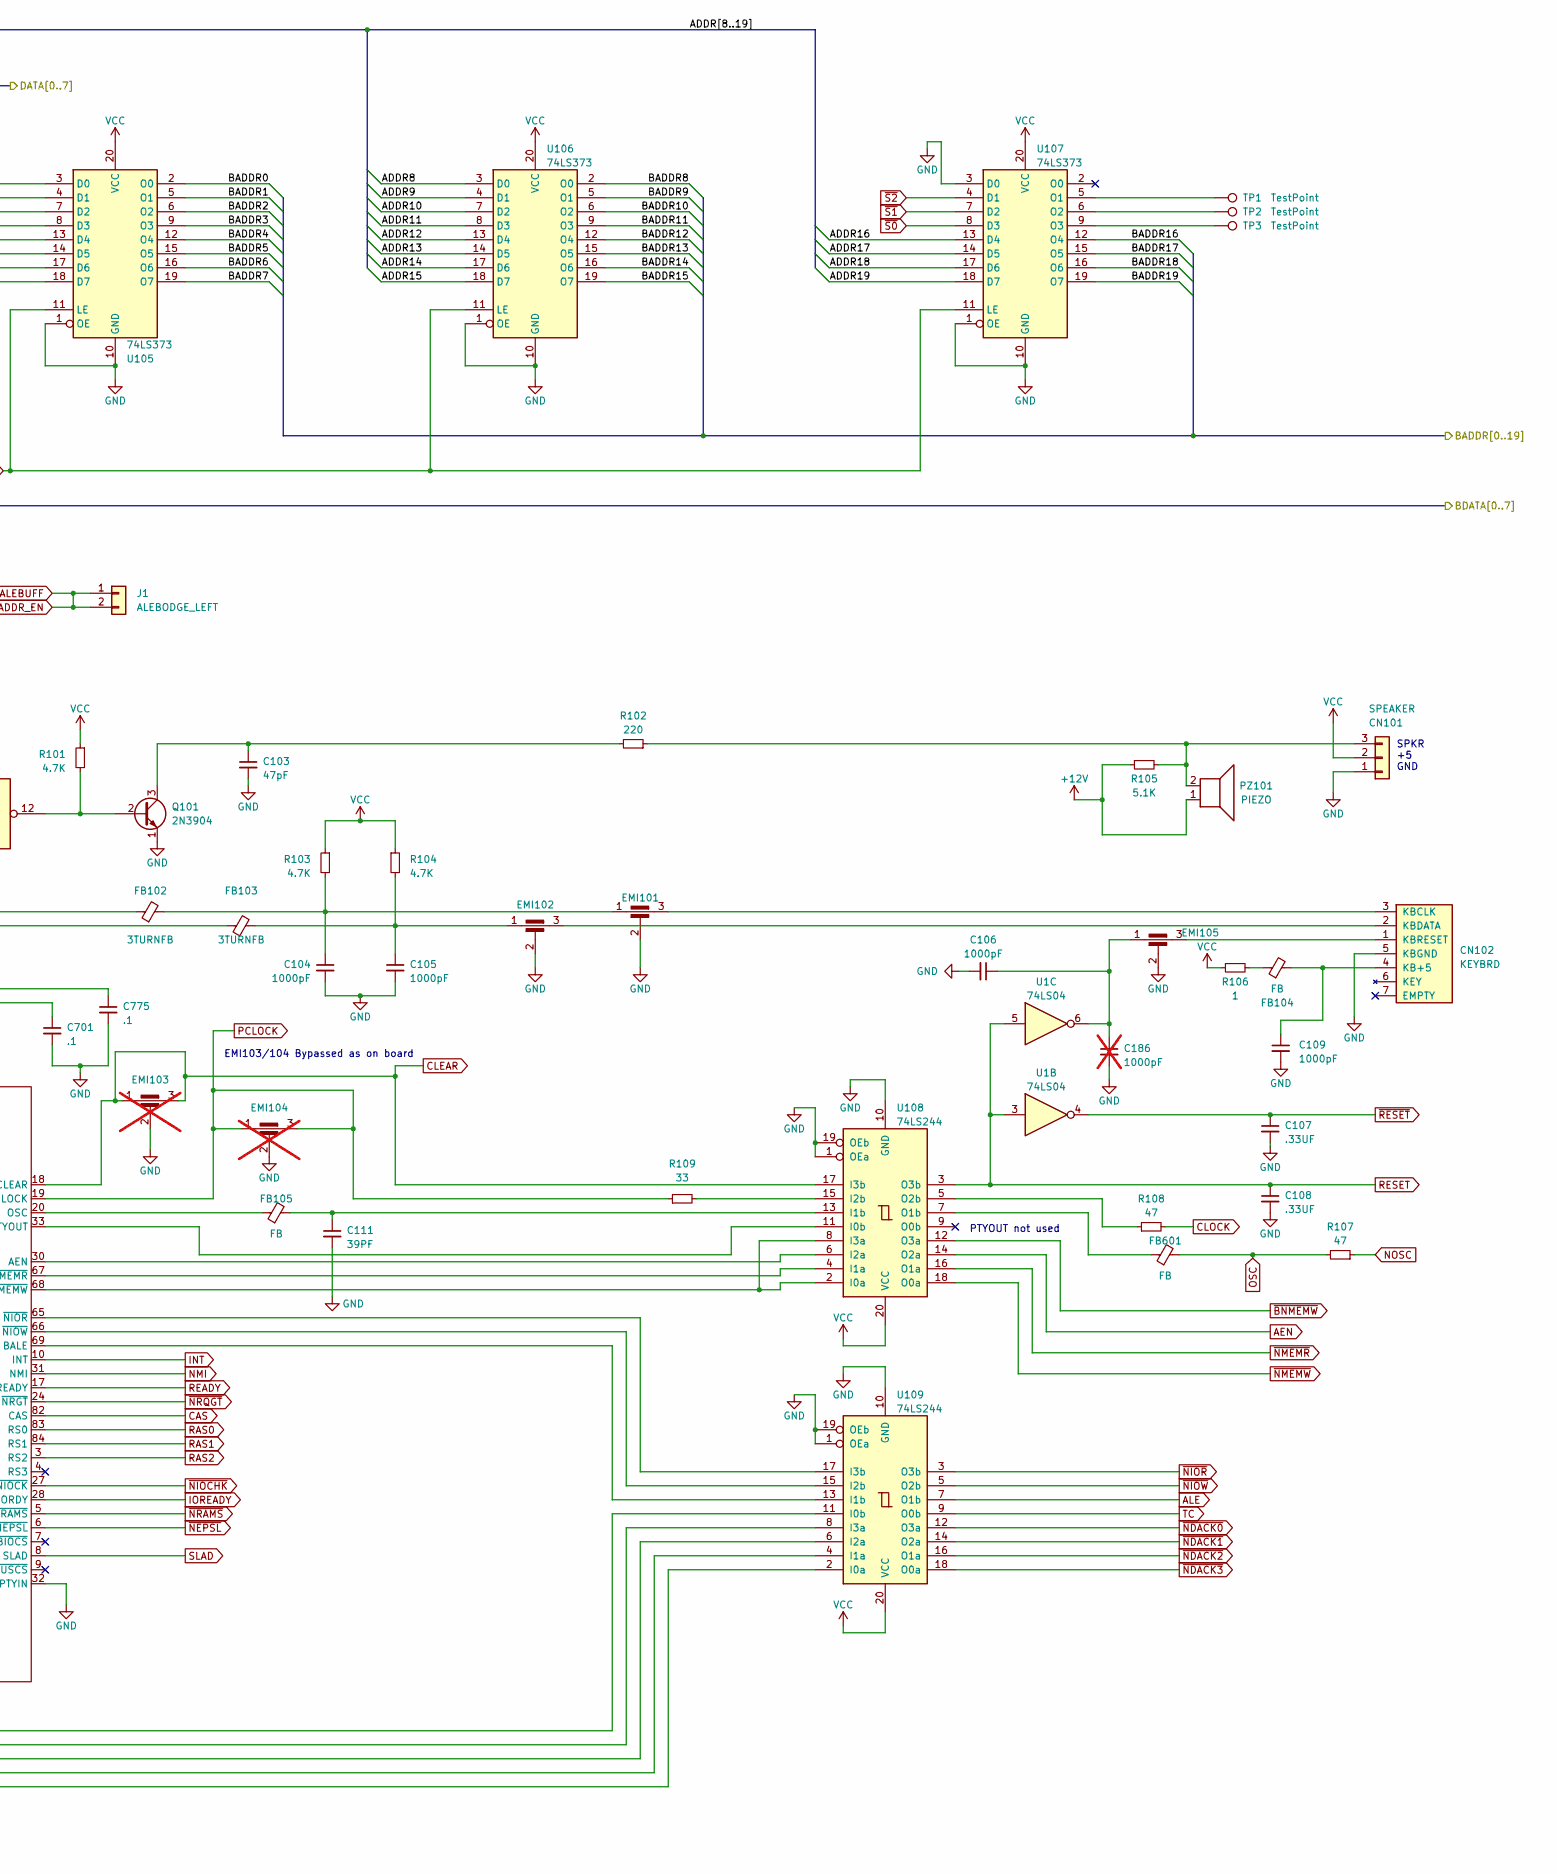
[picture p26: schematic CPU.kicad_sch, part in row 1, column 2]

Parts:
C103: 47pF; C_Disc_P5.00mm
C104, C105: 1000pF; C_Disc 2_P5.00mm
C106, C109, C110: 1000pF; C_Disc_P5.00mm
C107, C108: .33UF; C_Disc_P5.00mm
C111: 39PF; C_Disc_P5.00mm
C186: 1000pF; C_Disc_P5.00mm; not fitted
C701: .1; C_Disc 2_P5.00mm
C702, C703: .1uF; C_Disc_P5.00mm
C775: .1; C_Disc_P5.00mm
CN101: SPEAKER; PinHeader_1x03_P2.54mm - AltPads
CN102: KEYBRD; CN102
EMI101, EMI102, EMI105: EMI2
EMI103, EMI104: EMI; not fitted
FB101: FERRITE; R_Axial_P12.70mm
FB102, FB103: 3TURNFB; Ferrite 2
FB104, FB105, FB601: FB; R_Axial_P12.70mm
J1: ALEBODGE_LEFT; ALEBODGE
JMP101: Jumper_2_Open; PinHeader_1x02_P2.54mm
OSC101: 28.636MHZ; Oscillator_DIP-14 - OSC101
PZ101: PIEZO; Buzzer_PZ101
Q101: 2N3904; TO-92_Transistor
R101, R103, R104: 4.7K; R_Axial_P12.70mm
R102: 220; R_Axial_P12.70mm
R105: 5.1K; R_Axial_P12.70mm
R106: 1; R_Axial_P12.70mm
R107, R108: 47; R_Axial_P12.70mm
R109: 33; R_Axial_P12.70mm
RP101, RP102: 4.7K; R_Array_SIP6
TP1, TP2, TP3: TestPoint; Test Point
U1: 74LS04; DIP-14_W7.62mm
U101: FE2010; PLCC-84_U101
U102: 8088; DIP-40_W15.24mm
U103: 8087; DIP-40_W15.24mm
U104: 74LS245; DIP-20_W7.62mm
U105, U106, U107: 74LS373; DIP-20_W7.62mm
U108, U109: 74LS244; DIP-20_W7.62mm
U207: 7406; DIP-14_W7.62mm

Connections:
+12V: PZ101.1, R105.1
ADDR8: U101.44 (A8), U102.8 (A8), U103.8 (A8), U106.3 (D0)
ADDR9: U101.45 (A9), U102.7 (A9), U103.7 (A9), U106.4 (D1)
ADDR10: U101.46 (A10), U102.6 (A10), U103.6 (A10), U106.7 (D2)
ADDR11: U101.47 (A11), U102.5 (A11), U103.5 (A11), U106.8 (D3)
ADDR12: U101.48 (A12), U102.4 (A12), U103.4 (A12), U106.13 (D4)
ADDR13: U101.49 (A13), U102.3 (A13), U103.3 (A13), U106.14 (D5)
ADDR14: U101.50 (A14), U102.2 (A14), U103.2 (A14), U106.17 (D6)
ADDR15: U101.51 (A15), U102.39 (A15), U103.39 (A15), U106.18 (D7)
ADDR16: U101.52 (A16), U102.38 (A16/S3), U103.38 (A16/S3), U107.13 (D4)
ADDR17: U101.53 (A17), U102.37 (A17/S4), U103.37 (A17/S4), U107.14 (D5)
ADDR18: U101.54 (A18), U102.36 (A18/S5), U103.36 (A18/S5), U107.17 (D6)
ADDR19: U101.55 (A19), U102.35 (A19/S6), U103.35 (A19/S6), U107.18 (D7)
AEN: U108.14 (O2a)
ALE: U109.7 (O1b)
ALEBUFF: J1.1, J1.2, U105.11 (LE), U106.11 (LE), U107.11 (LE)
BADDR0: U105.2 (O0)
BADDR1: U105.5 (O1)
BADDR2: U105.6 (O2)
BADDR3: U105.9 (O3)
BADDR4: U105.12 (O4)
BADDR5: U105.15 (O5)
BADDR6: U105.16 (O6)
BADDR7: U105.19 (O7)
BADDR8: U106.2 (O0)
BADDR9: U106.5 (O1)
BADDR10: U106.6 (O2)
BADDR11: U106.9 (O3)
BADDR12: U106.12 (O4)
BADDR13: U106.15 (O5)
BADDR14: U106.16 (O6)
BADDR15: U106.19 (O7)
BADDR16: U107.12 (O4)
BADDR17: U107.15 (O5)
BADDR18: U107.16 (O6)
BADDR19: U107.19 (O7)
BDATA0: U104.18 (B0)
BDATA1: U104.17 (B1)
BDATA2: U104.16 (B2)
BDATA3: U104.15 (B3)
BDATA4: U104.14 (B4)
BDATA5: U104.13 (B5)
BDATA6: U104.12 (B6)
BDATA7: U104.11 (B7)
CAS: U101.82 (CAS)
CLEAR: EMI103.1, EMI103.3, U101.18 (CLEAR), U102.21 (RESET), U103.21 (RESET), U108.17 (I3b)
CLOCK: R108.2
DATA0: U101.34 (AD0), U102.16 (AD0), U103.16 (AD0), U104.2 (A0), U105.3 (D0)
DATA1: U101.35 (AD1), U102.15 (AD1), U103.15 (AD1), U104.3 (A1), U105.4 (D1)
DATA2: U101.36 (AD2), U102.14 (AD2), U103.14 (AD2), U104.4 (A2), U105.7 (D2)
DATA3: U101.37 (AD3), U102.13 (AD3), U103.13 (AD3), U104.5 (A3), U105.8 (D3)
DATA4: U101.38 (AD4), U102.12 (AD4), U103.12 (AD4), U104.6 (A4), U105.13 (D4)
DATA5: U101.39 (AD5), U102.11 (AD5), U103.11 (AD5), U104.7 (A5), U105.14 (D5)
DATA6: U101.40 (AD6), U102.10 (AD6), U103.10 (AD6), U104.8 (A6), U105.17 (D6)
DATA7: U101.41 (AD7), U102.9 (AD7), U103.9 (AD7), U104.9 (A7), U105.18 (D7)
DRQ1: U101.58 (DRQ1)
DRQ2: U101.57 (DRQ2)
DRQ3: U101.56 (DRQ3)
GND: C103.2, C104.2, C105.2, C106.2, C107.2, C108.2, C109.2, C110.2, C111.2, C186.2, C701.2, C702.2, C703.2, C775.2, CN101.1, CN102.5 (KBGND), EMI101.2, EMI102.2, EMI103.2, EMI104.2, EMI105.2, JMP101.1 (A), OSC101.2 (GND), Q101.1 (E), U101.2 (VSS), U101.11 (A64K), U101.22 (VSS), U101.32 (PTYIN), U101.42 (VSS), U101.64 (VSS), U102.1 (GND), U102.20 (GND), U102.33 (MN/~MX), U103.1 (GND), U103.20 (GND), U104.10 (GND), U105.1 (OE), U105.10 (GND), U106.1 (OE), U106.10 (GND), U107.1 (OE), U107.3 (D0), U107.10 (GND), U108.1 (OEa), U108.10 (GND), U108.19 (OEb), U109.1 (OEa), U109.10 (GND), U109.19 (OEb), U207.7 (GND)
INT: U101.10 (INT), U102.18 (INTR)
IOREADY: U101.28 (IORDY)
IRQ2: U101.76 (IRQ2)
IRQ3: C110.1, U101.77 (IRQ3)
IRQ4: U101.78 (IRQ4)
IRQ5: U101.79 (IRQ5)
IRQ6: U101.80 (IRQ6)
IRQ7: U101.81 (IRQ7)
NMI: U101.31 (NMI), U102.17 (NMI)
NOSC: R107.1
unnamed: C103.1, Q101.3 (C), R102.2
unnamed: C104.1, EMI101.1, FB102.2, R103.2
unnamed: C105.1, EMI102.1, FB103.2, R104.2
unnamed: C106.1, C186.1, EMI105.1, U1.6
unnamed: C109.1, CN102.4 (KB+5), FB104.2
unnamed: C111.1, FB105.2, U108.13 (I1b)
unnamed: CN101.3, PZ101.2, R102.1, R105.2
unnamed: CN102.1 (KBRESET), EMI105.3
unnamed: CN102.2 (KBDATA), EMI102.3
unnamed: CN102.3 (KBCLK), EMI101.3
unnamed: FB101.1, OSC101.3 (OUT)
unnamed: FB101.2, U101.23 (X1)
unnamed: FB102.1, U101.25 (KBCLK)
unnamed: FB103.1, U101.26 (KBDA)
unnamed: FB104.1, R106.2
unnamed: FB105.1, U101.20 (OSC)
unnamed: FB601.1, U108.7 (O1b)
unnamed: JMP101.2 (B), RP102.3 (R2), U101.16 (~NTSTCLR)
unnamed: Q101.2 (B), R101.2, U207.12
unnamed: R108.1, U108.5 (O2b)
unnamed: R109.2, U108.15 (I2b)
unnamed: RP101.3 (R2), U102.23 (~TEST), U103.23 (BUSY)
unnamed: RP102.2 (R1), U103.33 (~RQ/~GT1)
unnamed: TP1.1, U107.5 (O1)
unnamed: TP2.1, U107.6 (O2)
unnamed: TP3.1, U107.9 (O3)
unnamed: U101.14 (SPEAKR), U207.13
unnamed: U101.29 (APNMI), U103.32 (INT)
unnamed: U101.30 (AEN), U108.6 (I2a)
unnamed: U101.33 (PTYOUT), U108.11 (I0b)
unnamed: U101.59 (EOP), U109.11 (I0b)
unnamed: U101.60 (~NDAK3), U109.2 (I0a)
unnamed: U101.61 (~NDAK2), U109.4 (I1a)
unnamed: U101.62 (~NDAK2), U109.6 (I2a)
unnamed: U101.63 (~NDAK0), U109.8 (I3a)
unnamed: U101.65 (~NIOR), U109.17 (I3b)
unnamed: U101.66 (~NIOW), U109.15 (I2b)
unnamed: U101.67 (~NMEMR), U108.4 (I1a)
unnamed: U101.68 (~NMEMW), U108.2 (I0a), U108.8 (I3a)
unnamed: U101.69 (BALE), U109.13 (I1b)
unnamed: U101.71 (~NDEN), U104.19 (CE)
unnamed: U101.72 (DTR), U104.1 (A->B)
unnamed: U102.24 (QS1), U103.24 (QS1)
unnamed: U102.25 (QS0), U103.25 (QS0)
unnamed: U102.30 (~RQ/~GT1), U103.31 (~RQ/~GT0)
OSC: FB601.2, R107.2
PCLOCK: EMI104.1, EMI104.3, R109.1, U101.19 (CLOCK), U102.19 (CLK), U103.19 (CLK)
RAS0: U101.83 (RS0)
RAS1: U101.84 (RS1)
RAS2: U101.3 (RS2)
READY: U101.17 (READY), U102.22 (READY), U103.22 (READY)
REALALE: U101.70 (ALE)
RESET: C108.1, U1.3, U1.5, U108.3 (O3b)
SLAD: U101.8 (SLAD)
SW2: RP102.4 (R3), U101.12 (VID0)
SW3: RP102.5 (R4), U101.13 (VID1)
TC: U109.9 (O0b)
VCC: C701.1, C702.1, C703.1, C775.1, CN101.2, OSC101.4 (vcc), R101.1, R103.1, R104.1, R106.1, RP101.1 (common), RP102.1 (common), U101.1 (VDD), U101.43 (VDD), U102.40 (VCC), U103.34 (~BHE/S7), U103.40 (VCC), U104.20 (VCC), U105.20 (VCC), U106.20 (VCC), U107.20 (VCC), U108.20 (VCC), U109.20 (VCC), U207.14 (VCC)
~BNMEMW: U108.12 (O3a)
~NDACK0: U109.12 (O3a)
~NDACK1: U109.14 (O2a)
~NDACK2: U109.16 (O1a)
~NDACK3: U109.18 (O0a)
~NEPSL: U101.6 (~NEPSL)
~NIOCHK: U101.27 (~NIOCK)
~NIOR: U109.3 (O3b)
~NIOW: U109.5 (O2b)
~NMEMR: U108.16 (O1a)
~NMEMW: U108.18 (O0a)
~NRAMS: U101.5 (~NRAMS)
~NRQGT: RP101.2 (R1), U101.24 (~NRGT), U102.31 (~RQ/~GT0)
~RESETIN: U101.15 (~NREST)
~RESET: C107.1, U1.4
~S0: RP101.6 (R5), U101.75 (S0), U102.26 (~S0), U103.26 (~S0), U107.8 (D3)
~S1: RP101.5 (R4), U101.74 (S1), U102.27 (~S1), U103.27 (~S1), U107.7 (D2)
~S2: RP101.4 (R3), U101.73 (S2), U102.28 (~S2), U103.28 (~S2), U107.4 (D1)

Notes on the sheet:
EMI103/104 Bypassed as on board
SPKR +5 GND
PTYOUT not used
