Board-Folk/Commodore-PC10-III-Reproduction/312628-REV-5.7A/sheets/EXPANSION.kicad_sch

## KiCad design 312628-REV-5.7A/sheets/EXPANSION.kicad_sch (2024-12-30)

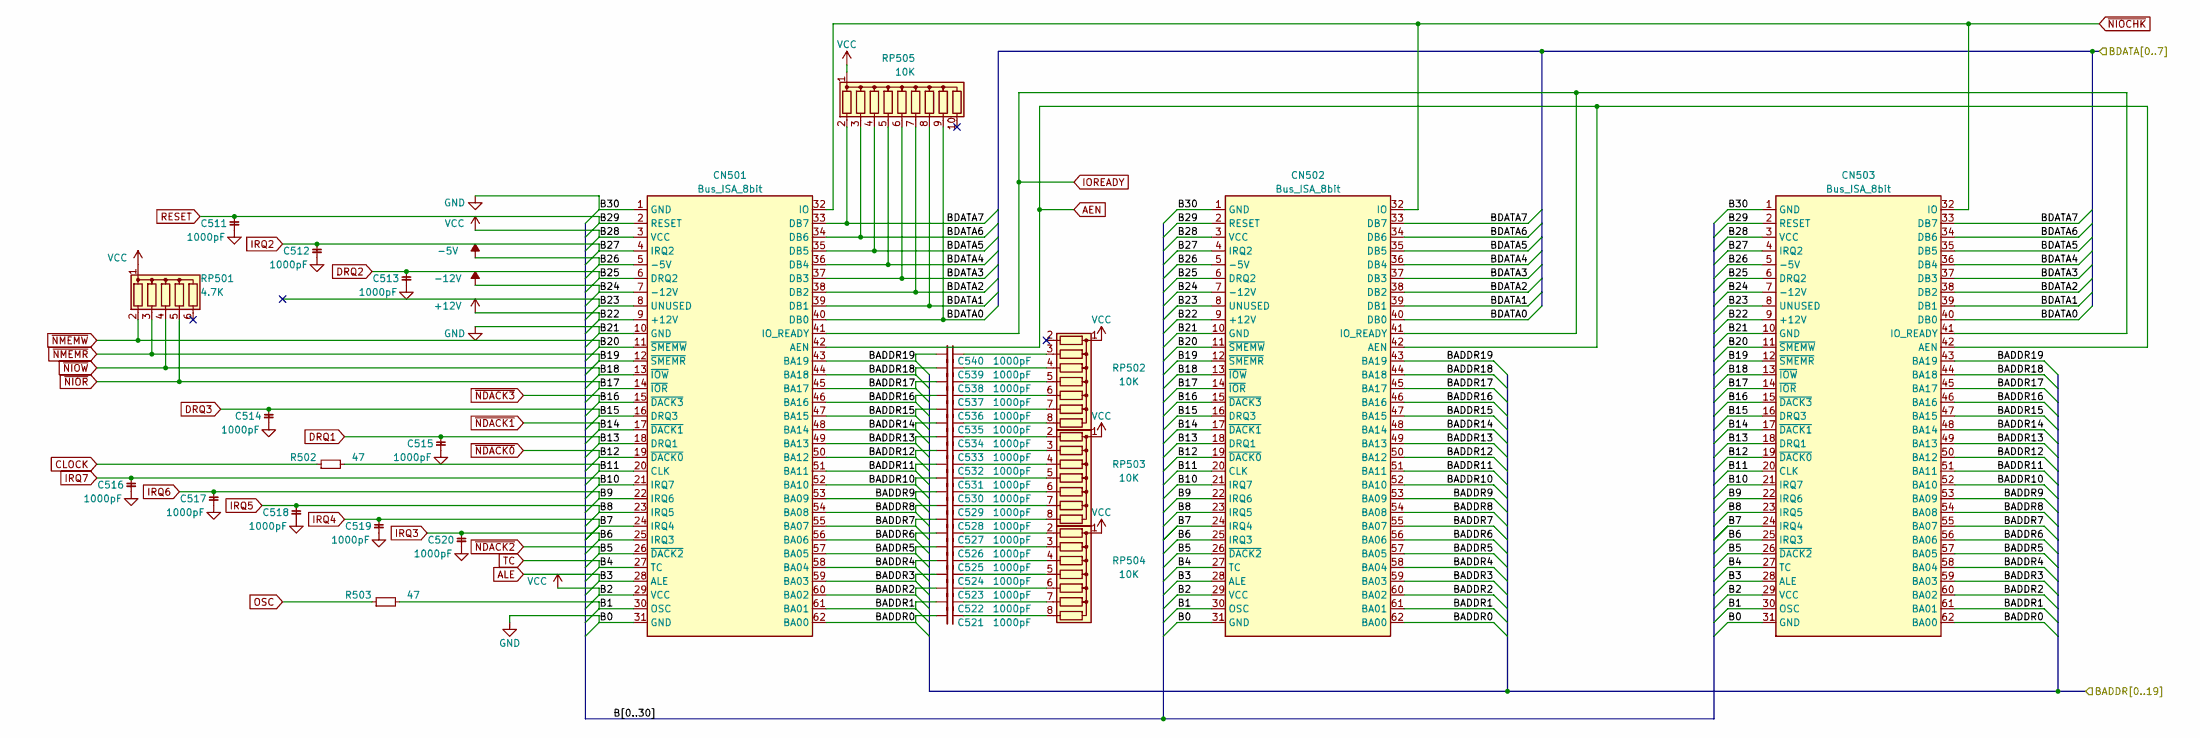
[picture p27: schematic EXPANSION.kicad_sch]

Parts:
C511, C512, C513, C514, C515, C516, C517, C518, C519, C520, C521, C522, C523, C524, C525, C526, C527, C528, C529, C530, C531, C532, C533, C534, C535, C536, C537, C538, C539, C540: 1000pF; C_Disc_P5.00mm
CN501, CN502, CN503: Bus_ISA_8bit; ISA Slot
R502, R503: 47; R_Axial_P12.70mm
RP501: 4.7K; R_Array_SIP6
RP502, RP503, RP504: 10K; R_Array_SIP8
RP505: 10K; R_Array_SIP10

Connections:
+12V: CN501.9 (+12V), CN502.9 (+12V), CN503.9 (+12V)
-5V: CN501.5 (-5V), CN502.5 (-5V), CN503.5 (-5V)
-12V: CN501.7 (-12V), CN502.7 (-12V), CN503.7 (-12V)
AEN: CN501.42 (AEN), CN502.42 (AEN), CN503.42 (AEN)
ALE: CN501.28 (ALE), CN502.28 (ALE), CN503.28 (ALE)
B1: CN501.30 (OSC), CN502.30 (OSC), CN503.30 (OSC), R503.2
B11: CN501.20 (CLK), CN502.20 (CLK), CN503.20 (CLK), R502.2
B23: CN501.8 (UNUSED), CN502.8 (UNUSED), CN503.8 (UNUSED)
BADDR0: C521.2, CN501.62 (BA00), CN502.62 (BA00), CN503.62 (BA00)
BADDR1: C522.2, CN501.61 (BA01), CN502.61 (BA01), CN503.61 (BA01)
BADDR2: C523.2, CN501.60 (BA02), CN502.60 (BA02), CN503.60 (BA02)
BADDR3: C524.2, CN501.59 (BA03), CN502.59 (BA03), CN503.59 (BA03)
BADDR4: C525.2, CN501.58 (BA04), CN502.58 (BA04), CN503.58 (BA04)
BADDR5: C526.2, CN501.57 (BA05), CN502.57 (BA05), CN503.57 (BA05)
BADDR6: C527.2, CN501.56 (BA06), CN502.56 (BA06), CN503.56 (BA06)
BADDR7: C528.2, CN501.55 (BA07), CN502.55 (BA07), CN503.55 (BA07)
BADDR8: C529.2, CN501.54 (BA08), CN502.54 (BA08), CN503.54 (BA08)
BADDR9: C530.2, CN501.53 (BA09), CN502.53 (BA09), CN503.53 (BA09)
BADDR10: C531.2, CN501.52 (BA10), CN502.52 (BA10), CN503.52 (BA10)
BADDR11: C532.2, CN501.51 (BA11), CN502.51 (BA11), CN503.51 (BA11)
BADDR12: C533.2, CN501.50 (BA12), CN502.50 (BA12), CN503.50 (BA12)
BADDR13: C534.2, CN501.49 (BA13), CN502.49 (BA13), CN503.49 (BA13)
BADDR14: C535.2, CN501.48 (BA14), CN502.48 (BA14), CN503.48 (BA14)
BADDR15: C536.2, CN501.47 (BA15), CN502.47 (BA15), CN503.47 (BA15)
BADDR16: C537.2, CN501.46 (BA16), CN502.46 (BA16), CN503.46 (BA16)
BADDR17: C538.2, CN501.45 (BA17), CN502.45 (BA17), CN503.45 (BA17)
BADDR18: C539.2, CN501.44 (BA18), CN502.44 (BA18), CN503.44 (BA18)
BADDR19: C540.2, CN501.43 (BA19), CN502.43 (BA19), CN503.43 (BA19)
BDATA0: CN501.40 (DB0), CN502.40 (DB0), CN503.40 (DB0), RP505.9 (R8)
BDATA1: CN501.39 (DB1), CN502.39 (DB1), CN503.39 (DB1), RP505.8 (R7)
BDATA2: CN501.38 (DB2), CN502.38 (DB2), CN503.38 (DB2), RP505.7 (R6)
BDATA3: CN501.37 (DB3), CN502.37 (DB3), CN503.37 (DB3), RP505.6 (R5)
BDATA4: CN501.36 (DB4), CN502.36 (DB4), CN503.36 (DB4), RP505.5 (R4)
BDATA5: CN501.35 (DB5), CN502.35 (DB5), CN503.35 (DB5), RP505.4 (R3)
BDATA6: CN501.34 (DB6), CN502.34 (DB6), CN503.34 (DB6), RP505.3 (R2)
BDATA7: CN501.33 (DB7), CN502.33 (DB7), CN503.33 (DB7), RP505.2 (R1)
CLOCK: R502.1
DRQ1: C515.1, CN501.18 (DRQ1), CN502.18 (DRQ1), CN503.18 (DRQ1)
DRQ2: C513.1, CN501.6 (DRQ2), CN502.6 (DRQ2), CN503.6 (DRQ2)
DRQ3: C514.1, CN501.16 (DRQ3), CN502.16 (DRQ3), CN503.16 (DRQ3)
GND: C511.2, C512.2, C513.2, C514.2, C515.2, C516.2, C517.2, C518.2, C519.2, C520.2, CN501.1 (GND), CN501.10 (GND), CN501.31 (GND), CN502.1 (GND), CN502.10 (GND), CN502.31 (GND), CN503.1 (GND), CN503.10 (GND), CN503.31 (GND)
IOREADY: CN501.41 (IO_READY), CN502.41 (IO_READY), CN503.41 (IO_READY)
IRQ2: C512.1, CN501.4 (IRQ2), CN502.4 (IRQ2), CN503.4 (IRQ2)
IRQ3: C520.1, CN501.25 (IRQ3), CN502.25 (IRQ3), CN503.25 (IRQ3)
IRQ4: C519.1, CN501.24 (IRQ4), CN502.24 (IRQ4), CN503.24 (IRQ4)
IRQ5: C518.1, CN501.23 (IRQ5), CN502.23 (IRQ5), CN503.23 (IRQ5)
IRQ6: C517.1, CN501.22 (IRQ6), CN502.22 (IRQ6), CN503.22 (IRQ6)
IRQ7: C516.1, CN501.21 (IRQ7), CN502.21 (IRQ7), CN503.21 (IRQ7)
unnamed: C521.1, RP504.8 (R7)
unnamed: C522.1, RP504.7 (R6)
unnamed: C523.1, RP504.6 (R5)
unnamed: C524.1, RP504.5 (R4)
unnamed: C525.1, RP504.4 (R3)
unnamed: C526.1, RP504.3 (R2)
unnamed: C527.1, RP504.2 (R1)
unnamed: C528.1, RP503.8 (R7)
unnamed: C529.1, RP503.7 (R6)
unnamed: C530.1, RP503.6 (R5)
unnamed: C531.1, RP503.5 (R4)
unnamed: C532.1, RP503.4 (R3)
unnamed: C533.1, RP503.3 (R2)
unnamed: C534.1, RP503.2 (R1)
unnamed: C535.1, RP502.8 (R7)
unnamed: C536.1, RP502.7 (R6)
unnamed: C537.1, RP502.6 (R5)
unnamed: C538.1, RP502.5 (R4)
unnamed: C539.1, RP502.4 (R3)
unnamed: C540.1, RP502.3 (R2)
OSC: R503.1
RESET: C511.1, CN501.2 (RESET), CN502.2 (RESET), CN503.2 (RESET)
TC: CN501.27 (TC), CN502.27 (TC), CN503.27 (TC)
VCC: CN501.3 (VCC), CN501.29 (VCC), CN502.3 (VCC), CN502.29 (VCC), CN503.3 (VCC), CN503.29 (VCC), RP501.1 (common), RP502.1 (common), RP503.1 (common), RP504.1 (common), RP505.1 (common)
~NDACK0: CN501.19 (~DACK0), CN502.19 (~DACK0), CN503.19 (~DACK0)
~NDACK1: CN501.17 (~DACK1), CN502.17 (~DACK1), CN503.17 (~DACK1)
~NDACK2: CN501.26 (~DACK2), CN502.26 (~DACK2), CN503.26 (~DACK2)
~NDACK3: CN501.15 (~DACK3), CN502.15 (~DACK3), CN503.15 (~DACK3)
~NIOCHK: CN501.32 (IO), CN502.32 (IO), CN503.32 (IO)
~NIOR: CN501.14 (~IOR), CN502.14 (~IOR), CN503.14 (~IOR), RP501.5 (R4)
~NIOW: CN501.13 (~IOW), CN502.13 (~IOW), CN503.13 (~IOW), RP501.4 (R3)
~NMEMR: CN501.12 (~SMEMR), CN502.12 (~SMEMR), CN503.12 (~SMEMR), RP501.3 (R2)
~NMEMW: CN501.11 (~SMEMW), CN502.11 (~SMEMW), CN503.11 (~SMEMW), RP501.2 (R1)
