Board-Folk/Commodore-PC10-III-Reproduction/312628-REV-5.7A/sheets/FDD_HDD_BIOS.kicad_sch

## KiCad design 312628-REV-5.7A/sheets/FDD_HDD_BIOS.kicad_sch (2024-12-30)

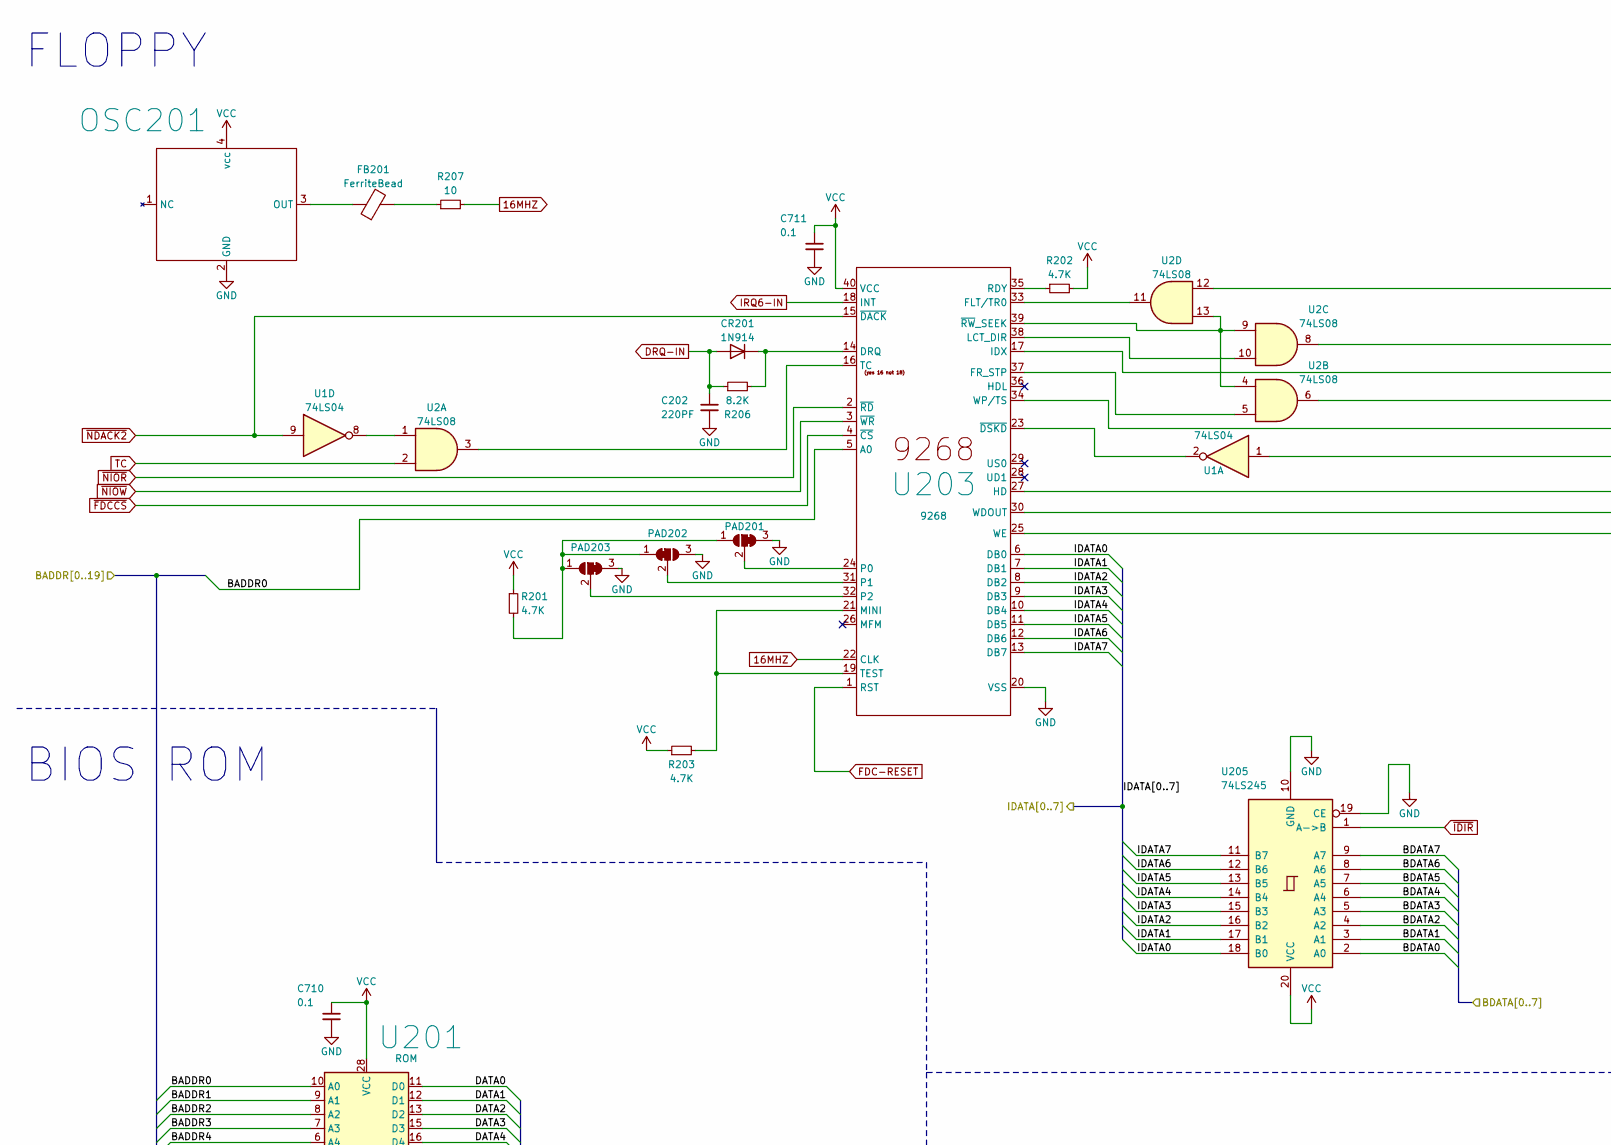
[picture p28: schematic FDD_HDD_BIOS.kicad_sch, part in row 1, column 1]

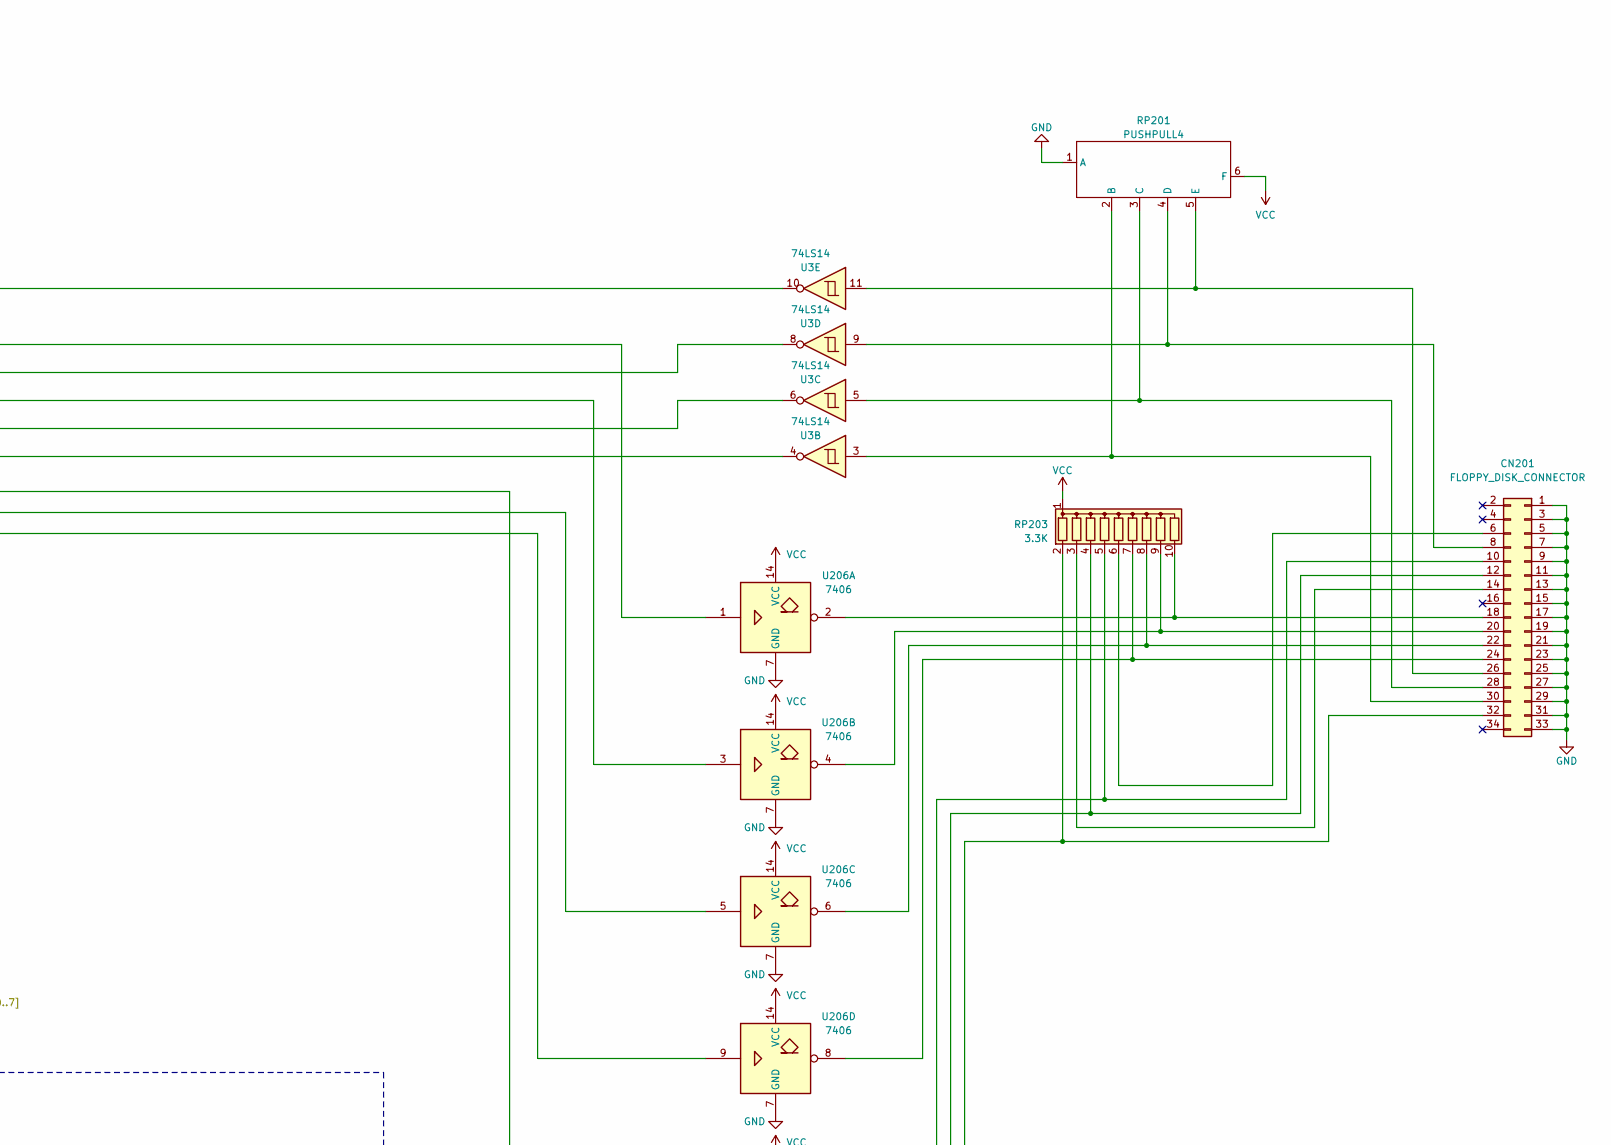
[picture p29: schematic FDD_HDD_BIOS.kicad_sch, part in row 1, column 2]

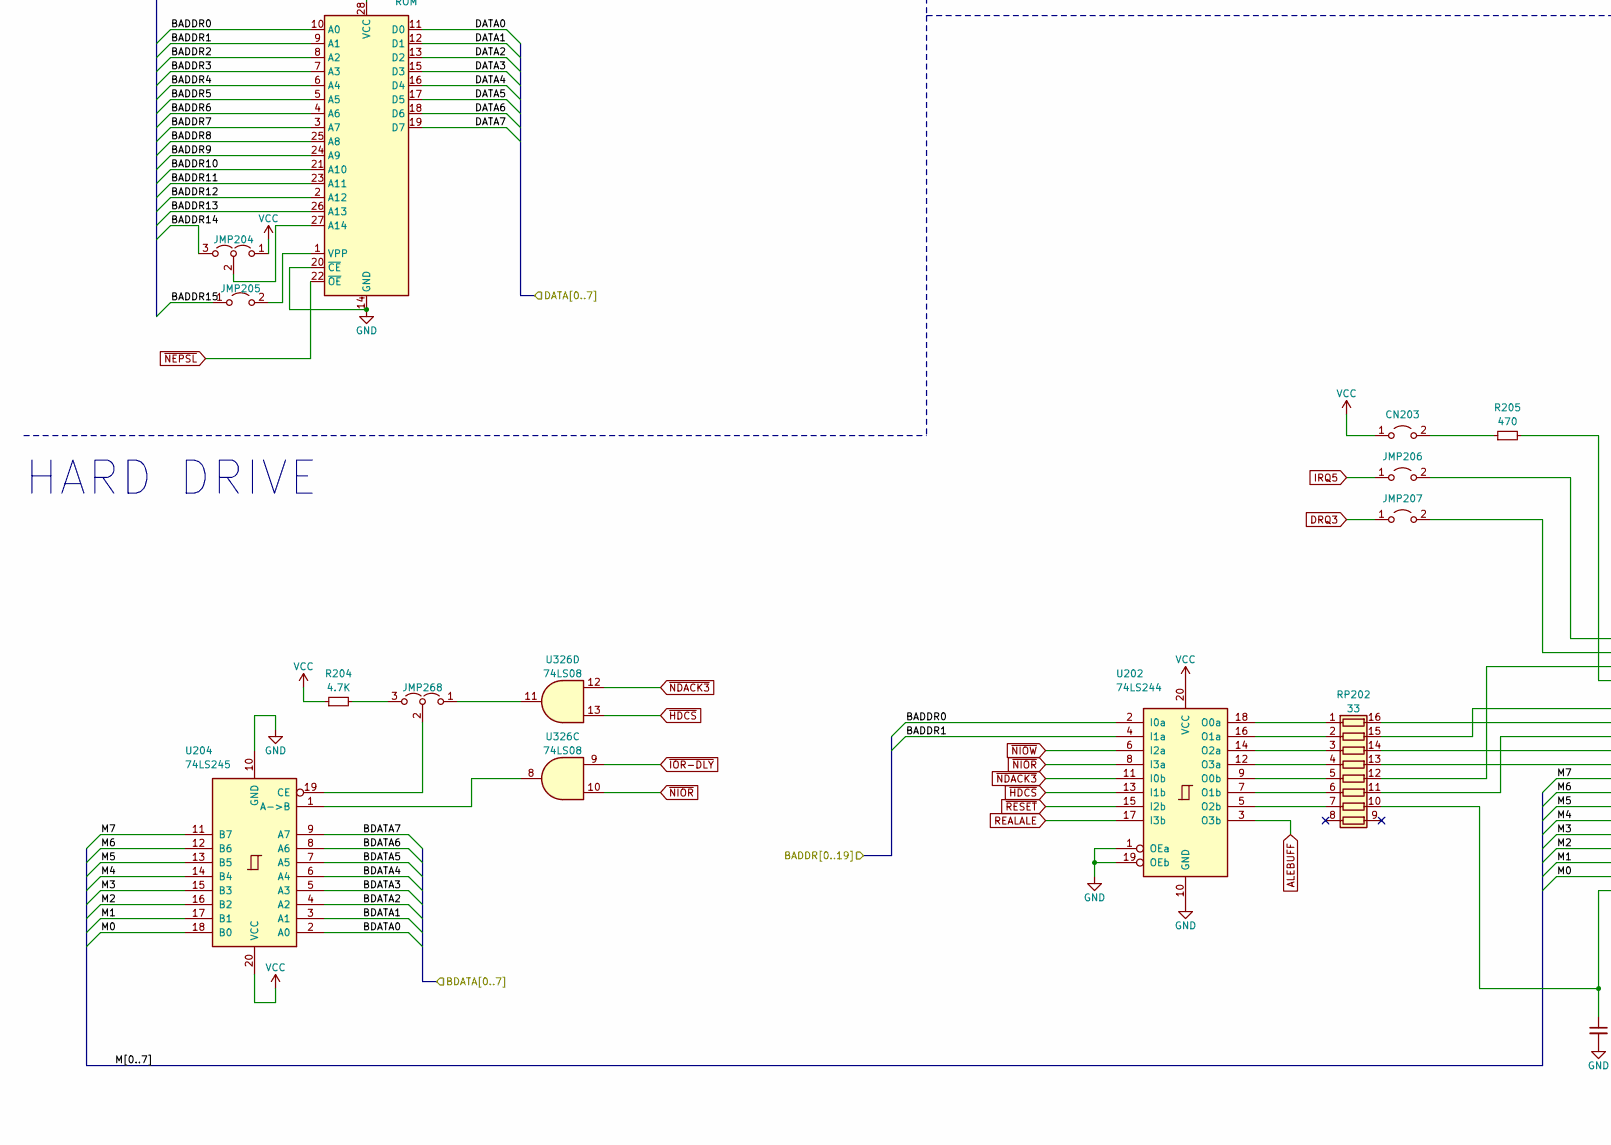
[picture p30: schematic FDD_HDD_BIOS.kicad_sch, part in row 2, column 1]

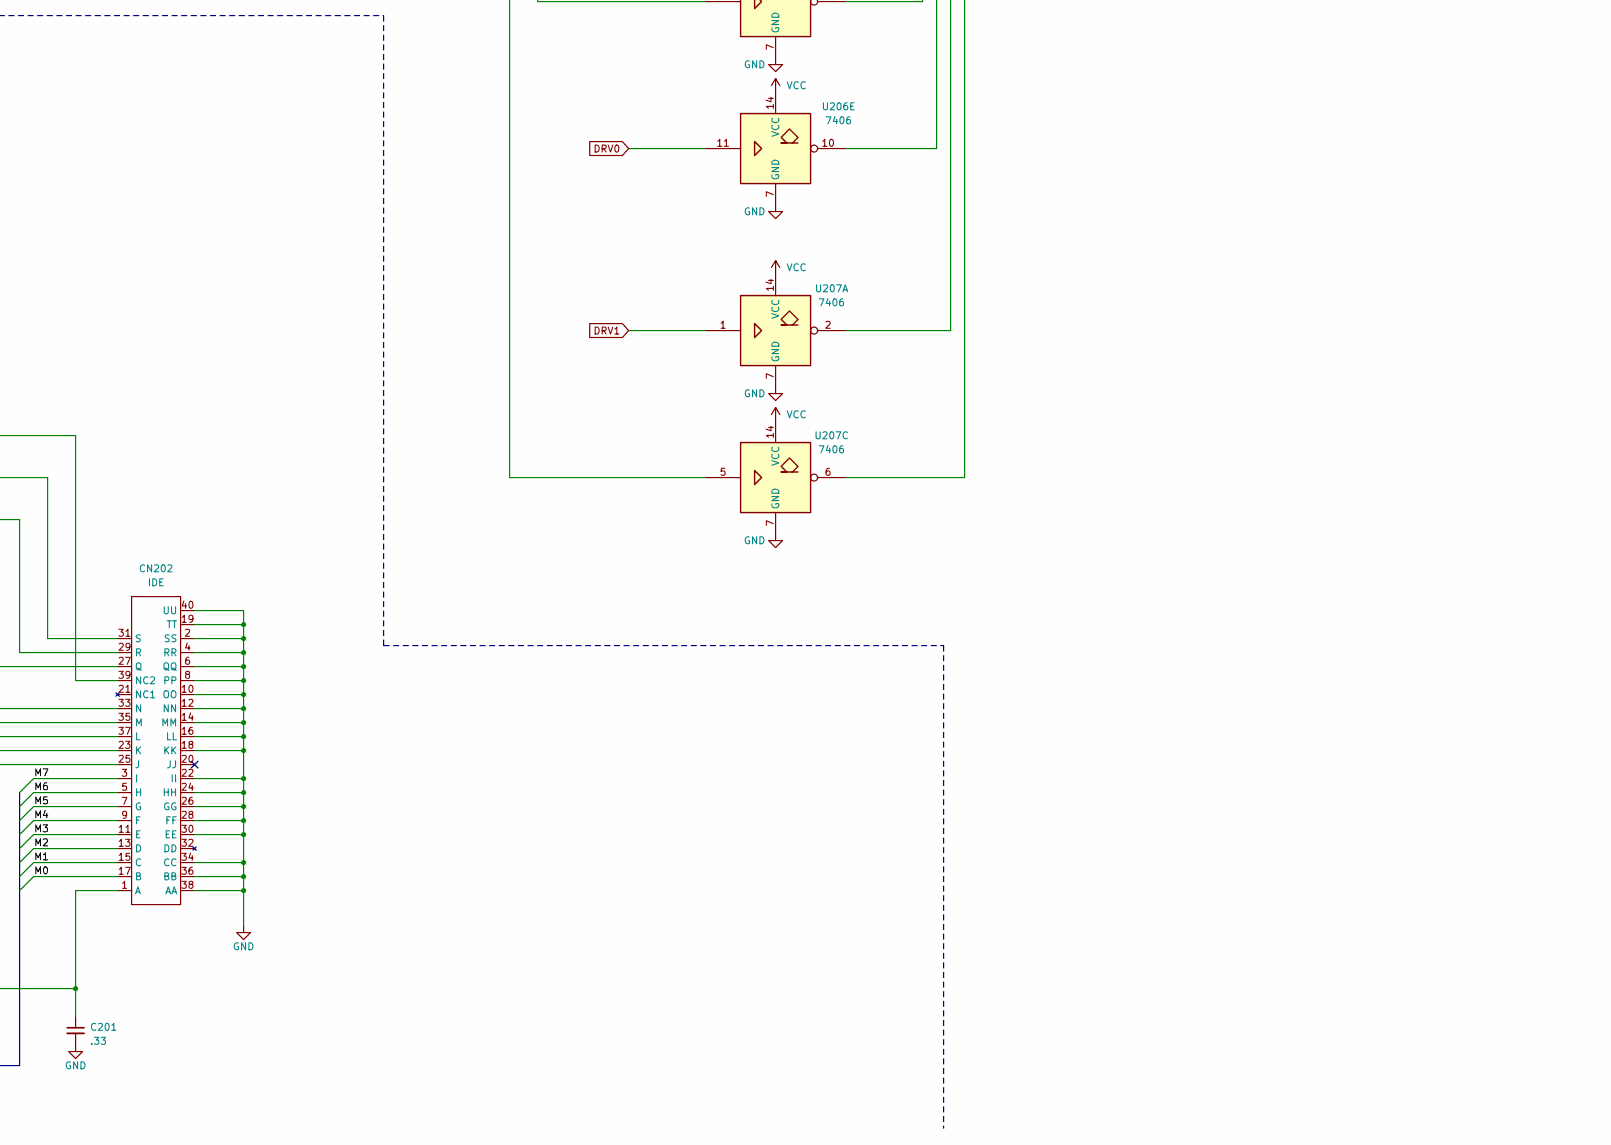
[picture p31: schematic FDD_HDD_BIOS.kicad_sch, part in row 2, column 2]

Parts:
C201: .33; C_Disc_P5.00mm
C202: 220PF; C_Disc_P5.00mm
C710, C711: 0.1; C_Disc_P5.00mm
CN201: FLOPPY_DISK_CONNECTOR; CN201 - Floppy
CN202: IDE; CN202 - IDE
CN203: Jumper_2_Open; PinHeader_1x02_P2.54mm
CR201: 1N914; Diode_Axial_P12.70mm
FB201: FerriteBead; R_Axial_P12.70mm
JMP204: Jumper_3_Open; PinHeader_1x03_P2.54mm - AltPads
JMP205, JMP206, JMP207: Jumper_2_Open; PinHeader_1x02_P2.54mm
JMP268: Jumper_3_Open; PinHeader_1x03_P2.54mm
OSC201: OSC201; Oscillator_OSC601
PAD201, PAD203: PAD; PAD (2-3 Connected)
PAD202: PAD; PAD (1-2 Connected)
R201, R202, R203, R204: 4.7K; R_Axial_P12.70mm
R205: 470; R_Axial_P12.70mm
R206: 8.2K; R_Axial_P12.70mm
R207: 10; R_Axial_P12.70mm
RP201: PUSHPULL4; R_Array_SIP6
RP202: 33; DIP-16_W7.62mm
RP203: 3.3K; R_Array_SIP10
U1: 74LS04; DIP-14_W7.62mm
U2, U326: 74LS08; DIP-14_W7.62mm
U3: 74LS14; DIP-14_W7.62mm
U201: ROM; DIP-28_W15.24mm
U202: 74LS244; DIP-20_W7.62mm
U203: 9268; DIP-40_W15.24mm
U204, U205: 74LS245; DIP-20_W7.62mm
U206, U207: 7406; DIP-14_W7.62mm

Connections:
16MHZ: R207.2, U203.22 (CLK)
ALEBUFF: U202.3 (O3b)
BADDR0: U201.10 (A0), U202.2 (I0a), U203.5 (A0)
BADDR1: U201.9 (A1), U202.4 (I1a)
BADDR2: U201.8 (A2)
BADDR3: U201.7 (A3)
BADDR4: U201.6 (A4)
BADDR5: U201.5 (A5)
BADDR6: U201.4 (A6)
BADDR7: U201.3 (A7)
BADDR8: U201.25 (A8)
BADDR9: U201.24 (A9)
BADDR10: U201.21 (A10)
BADDR11: U201.23 (A11)
BADDR12: U201.2 (A12)
BADDR13: U201.26 (A13)
BADDR14: JMP204.3 (B)
BADDR15: JMP205.1 (A)
BDATA0: U204.2 (A0), U205.2 (A0)
BDATA1: U204.3 (A1), U205.3 (A1)
BDATA2: U204.4 (A2), U205.4 (A2)
BDATA3: U204.5 (A3), U205.5 (A3)
BDATA4: U204.6 (A4), U205.6 (A4)
BDATA5: U204.7 (A5), U205.7 (A5)
BDATA6: U204.8 (A6), U205.8 (A6)
BDATA7: U204.9 (A7), U205.9 (A7)
DATA0: U201.11 (D0)
DATA1: U201.12 (D1)
DATA2: U201.13 (D2)
DATA3: U201.15 (D3)
DATA4: U201.16 (D4)
DATA5: U201.17 (D5)
DATA6: U201.18 (D6)
DATA7: U201.19 (D7)
DRQ3: JMP207.1 (A)
DRQ-IN: C202.1, CR201.2 (A), R206.1
DRV0: U206.11
DRV1: U207.1
FDC-RESET: U203.1 (RST)
GND: C201.2, C202.2, C710.2, C711.2, CN201.1, CN201.3, CN201.5, CN201.7, CN201.9, CN201.11, CN201.13, CN201.15, CN201.17, CN201.19, CN201.21, CN201.23, CN201.25, CN201.27, CN201.29, CN201.31, CN201.33, CN202.2 (SS), CN202.4 (RR), CN202.6 (QQ), CN202.8 (PP), CN202.10 (OO), CN202.12 (NN), CN202.14 (MM), CN202.16 (LL), CN202.18 (KK), CN202.19 (TT), CN202.22 (II), CN202.24 (HH), CN202.26 (GG), CN202.28 (FF), CN202.30 (EE), CN202.34 (CC), CN202.36 (BB), CN202.38 (AA), CN202.40 (UU), OSC201.2 (GND), PAD201.3 (B), PAD202.3 (B), PAD203.3 (B), RP201.1 (A), U201.14 (GND), U201.20 (~CE), U202.1 (OEa), U202.10 (GND), U202.19 (OEb), U203.20 (VSS), U204.10 (GND), U205.10 (GND), U205.19 (CE), U206.7 (GND), U207.7 (GND)
IDATA0: U203.6 (DB0), U205.18 (B0)
IDATA1: U203.7 (DB1), U205.17 (B1)
IDATA2: U203.8 (DB2), U205.16 (B2)
IDATA3: U203.9 (DB3), U205.15 (B3)
IDATA4: U203.10 (DB4), U205.14 (B4)
IDATA5: U203.11 (DB5), U205.13 (B5)
IDATA6: U203.12 (DB6), U205.12 (B6)
IDATA7: U203.13 (DB7), U205.11 (B7)
IRQ5: JMP206.1 (A)
IRQ6-IN: U203.18 (INT)
M0: CN202.17 (B), U204.18 (B0)
M1: CN202.15 (C), U204.17 (B1)
M2: CN202.13 (D), U204.16 (B2)
M3: CN202.11 (E), U204.15 (B3)
M4: CN202.9 (F), U204.14 (B4)
M5: CN202.7 (G), U204.13 (B5)
M6: CN202.5 (H), U204.12 (B6)
M7: CN202.3 (I), U204.11 (B7)
unnamed: C201.1, CN202.1 (A), RP202.10 (R7.2)
unnamed: CN201.6, RP203.6 (R5)
unnamed: CN201.8, RP201.4 (D), U3.9
unnamed: CN201.10, RP203.5 (R4), U206.10
unnamed: CN201.12, RP203.4 (R3), U207.2
unnamed: CN201.14, RP203.3 (R2)
unnamed: CN201.18, RP203.10 (R9), U206.2
unnamed: CN201.20, RP203.9 (R8), U206.4
unnamed: CN201.22, RP203.8 (R7), U206.6
unnamed: CN201.24, RP203.7 (R6), U206.8
unnamed: CN201.26, RP201.5 (E), U3.11
unnamed: CN201.28, RP201.3 (C), U3.5
unnamed: CN201.30, RP201.2 (B), U3.3
unnamed: CN201.32, RP203.2 (R1), U207.6
unnamed: CN202.23 (K), RP202.14 (R3.2)
unnamed: CN202.25 (J), RP202.13 (R4.2)
unnamed: CN202.27 (Q), RP202.12 (R5.2)
unnamed: CN202.29 (R), JMP207.2 (B)
unnamed: CN202.31 (S), JMP206.2 (B)
unnamed: CN202.33 (N), RP202.15 (R2.2)
unnamed: CN202.35 (M), RP202.16 (R1.2)
unnamed: CN202.37 (L), RP202.11 (R6.2)
unnamed: CN202.39 (NC2), R205.2
unnamed: CN203.2 (B), R205.1
unnamed: CR201.1 (K), R206.2, U203.14 (DRQ)
unnamed: FB201.1, OSC201.3 (OUT)
unnamed: FB201.2, R207.1
unnamed: JMP204.2 (C), U201.27 (A14)
unnamed: JMP205.2 (B), U201.1 (VPP)
unnamed: JMP268.1 (A), U326.11
unnamed: JMP268.2 (C), U204.19 (CE)
unnamed: JMP268.3 (B), R204.2
unnamed: PAD201.1 (A), PAD202.1 (A), PAD203.1 (A), R201.2
unnamed: PAD201.2 (C), U203.24 (P0)
unnamed: PAD202.2 (C), U203.31 (P1)
unnamed: PAD203.2 (C), U203.32 (P2)
unnamed: R202.1, U203.35 (RDY)
unnamed: R203.2, U203.19 (TEST), U203.21 (MINI)
unnamed: RP202.1 (R1.1), U202.18 (O0a)
unnamed: RP202.2 (R2.1), U202.16 (O1a)
unnamed: RP202.3 (R3.1), U202.14 (O2a)
unnamed: RP202.4 (R4.1), U202.12 (O3a)
unnamed: RP202.5 (R5.1), U202.9 (O0b)
unnamed: RP202.6 (R6.1), U202.7 (O1b)
unnamed: RP202.7 (R7.1), U202.5 (O2b)
unnamed: U1.1, U3.4
unnamed: U1.2, U203.23 (~DSKD)
unnamed: U1.8, U2.1
unnamed: U2.3, U203.16 (TC)
unnamed: U2.5, U203.37 (FR_STP)
unnamed: U2.6, U206.3
unnamed: U2.8, U206.1
unnamed: U2.10, U203.38 (LCT_DIR)
unnamed: U2.11, U203.33 (FLT/TR0)
unnamed: U2.12, U3.10
unnamed: U2.4, U2.9, U2.13, U203.39 (~RW_SEEK)
unnamed: U3.8, U203.17 (IDX)
unnamed: U203.25 (WE), U206.9
unnamed: U203.27 (HD), U207.5
unnamed: U203.30 (WDOUT), U206.5
unnamed: U3.6, U203.34 (WP/TS)
unnamed: U204.1 (A->B), U326.8
REALALE: U202.17 (I3b)
TC: U2.2
VCC: C710.1, C711.1, CN203.1 (A), JMP204.1 (A), OSC201.4 (vcc), R201.1, R202.2, R203.1, R204.1, RP201.6 (F), RP203.1 (common), U201.28 (VCC), U202.20 (VCC), U203.40 (VCC), U204.20 (VCC), U205.20 (VCC), U206.14 (VCC), U207.14 (VCC)
~FDCCS: U203.4 (~CS)
~HDCS: U202.13 (I1b), U326.13
~IDIR: U205.1 (A->B)
~IOR-DLY: U326.9
~NDACK2: U1.9, U203.15 (~DACK)
~NDACK3: U202.11 (I0b), U326.12
~NEPSL: U201.22 (~OE)
~NIOR: U202.8 (I3a), U203.2 (~RD), U326.10
~NIOW: U202.6 (I2a), U203.3 (~WR)
~RESET: U202.15 (I2b)

Notes on the sheet:
BIOS ROM
HARD DRIVE
FLOPPY
