Board-Folk/Commodore-PC10-III-Reproduction/312628-REV-5.7A/sheets/PRINTER_SERIAL.kicad_sch

## KiCad design 312628-REV-5.7A/sheets/PRINTER_SERIAL.kicad_sch (2024-12-30)

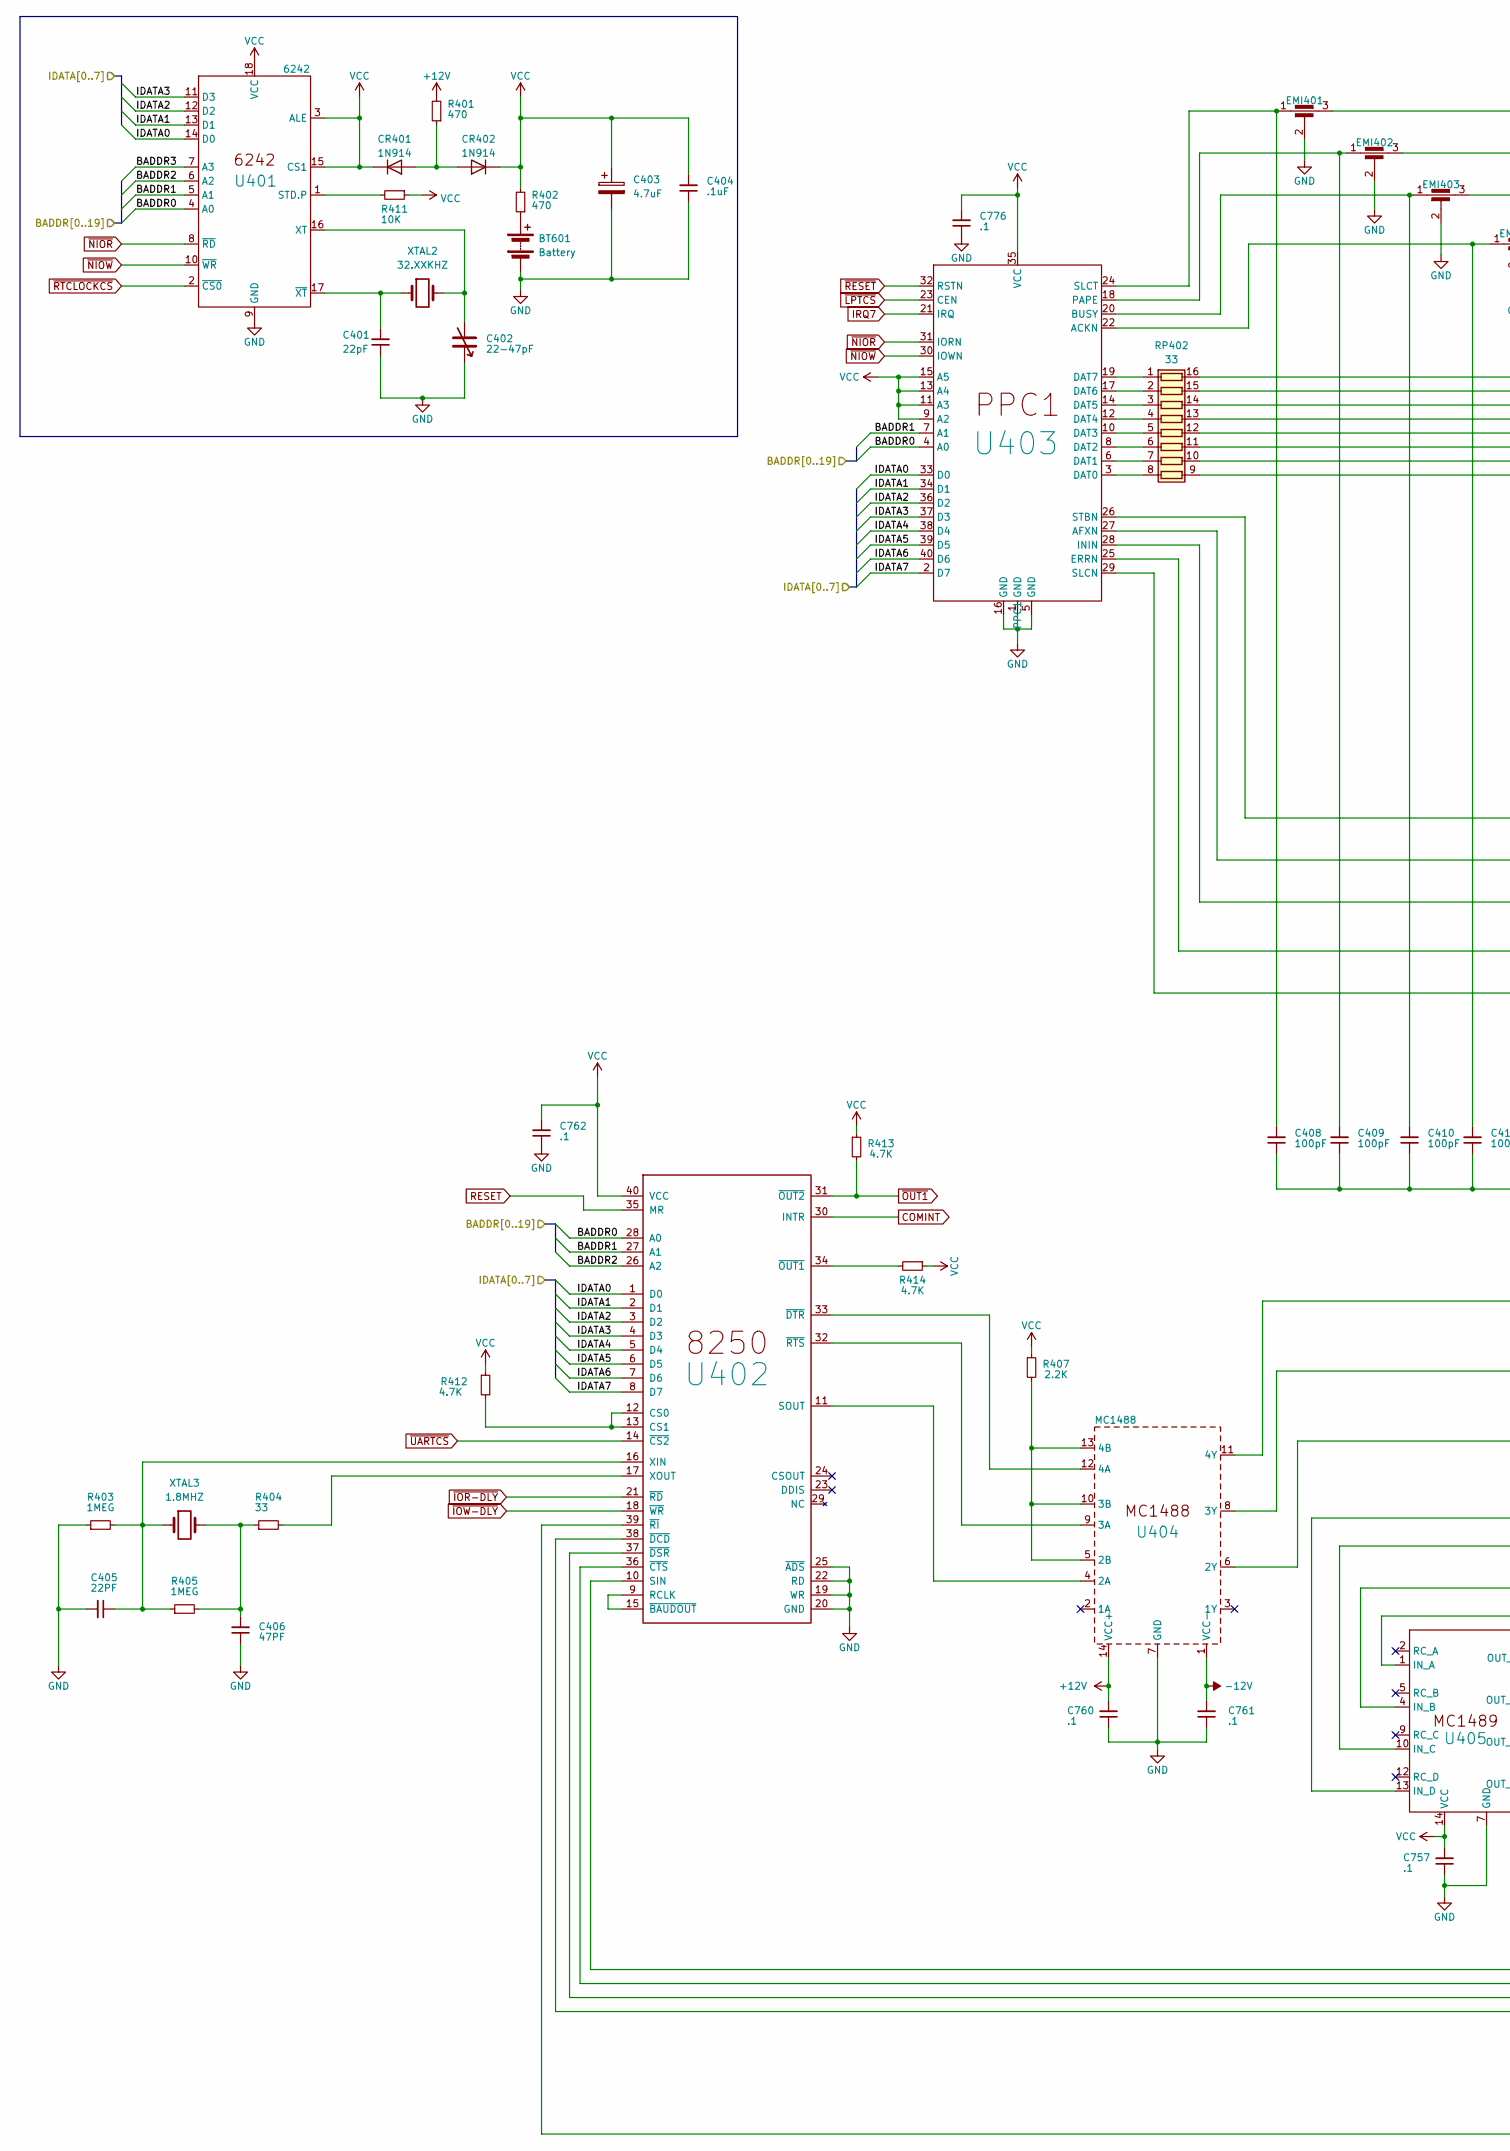
[picture p33: schematic PRINTER_SERIAL.kicad_sch, part in row 1, column 1]

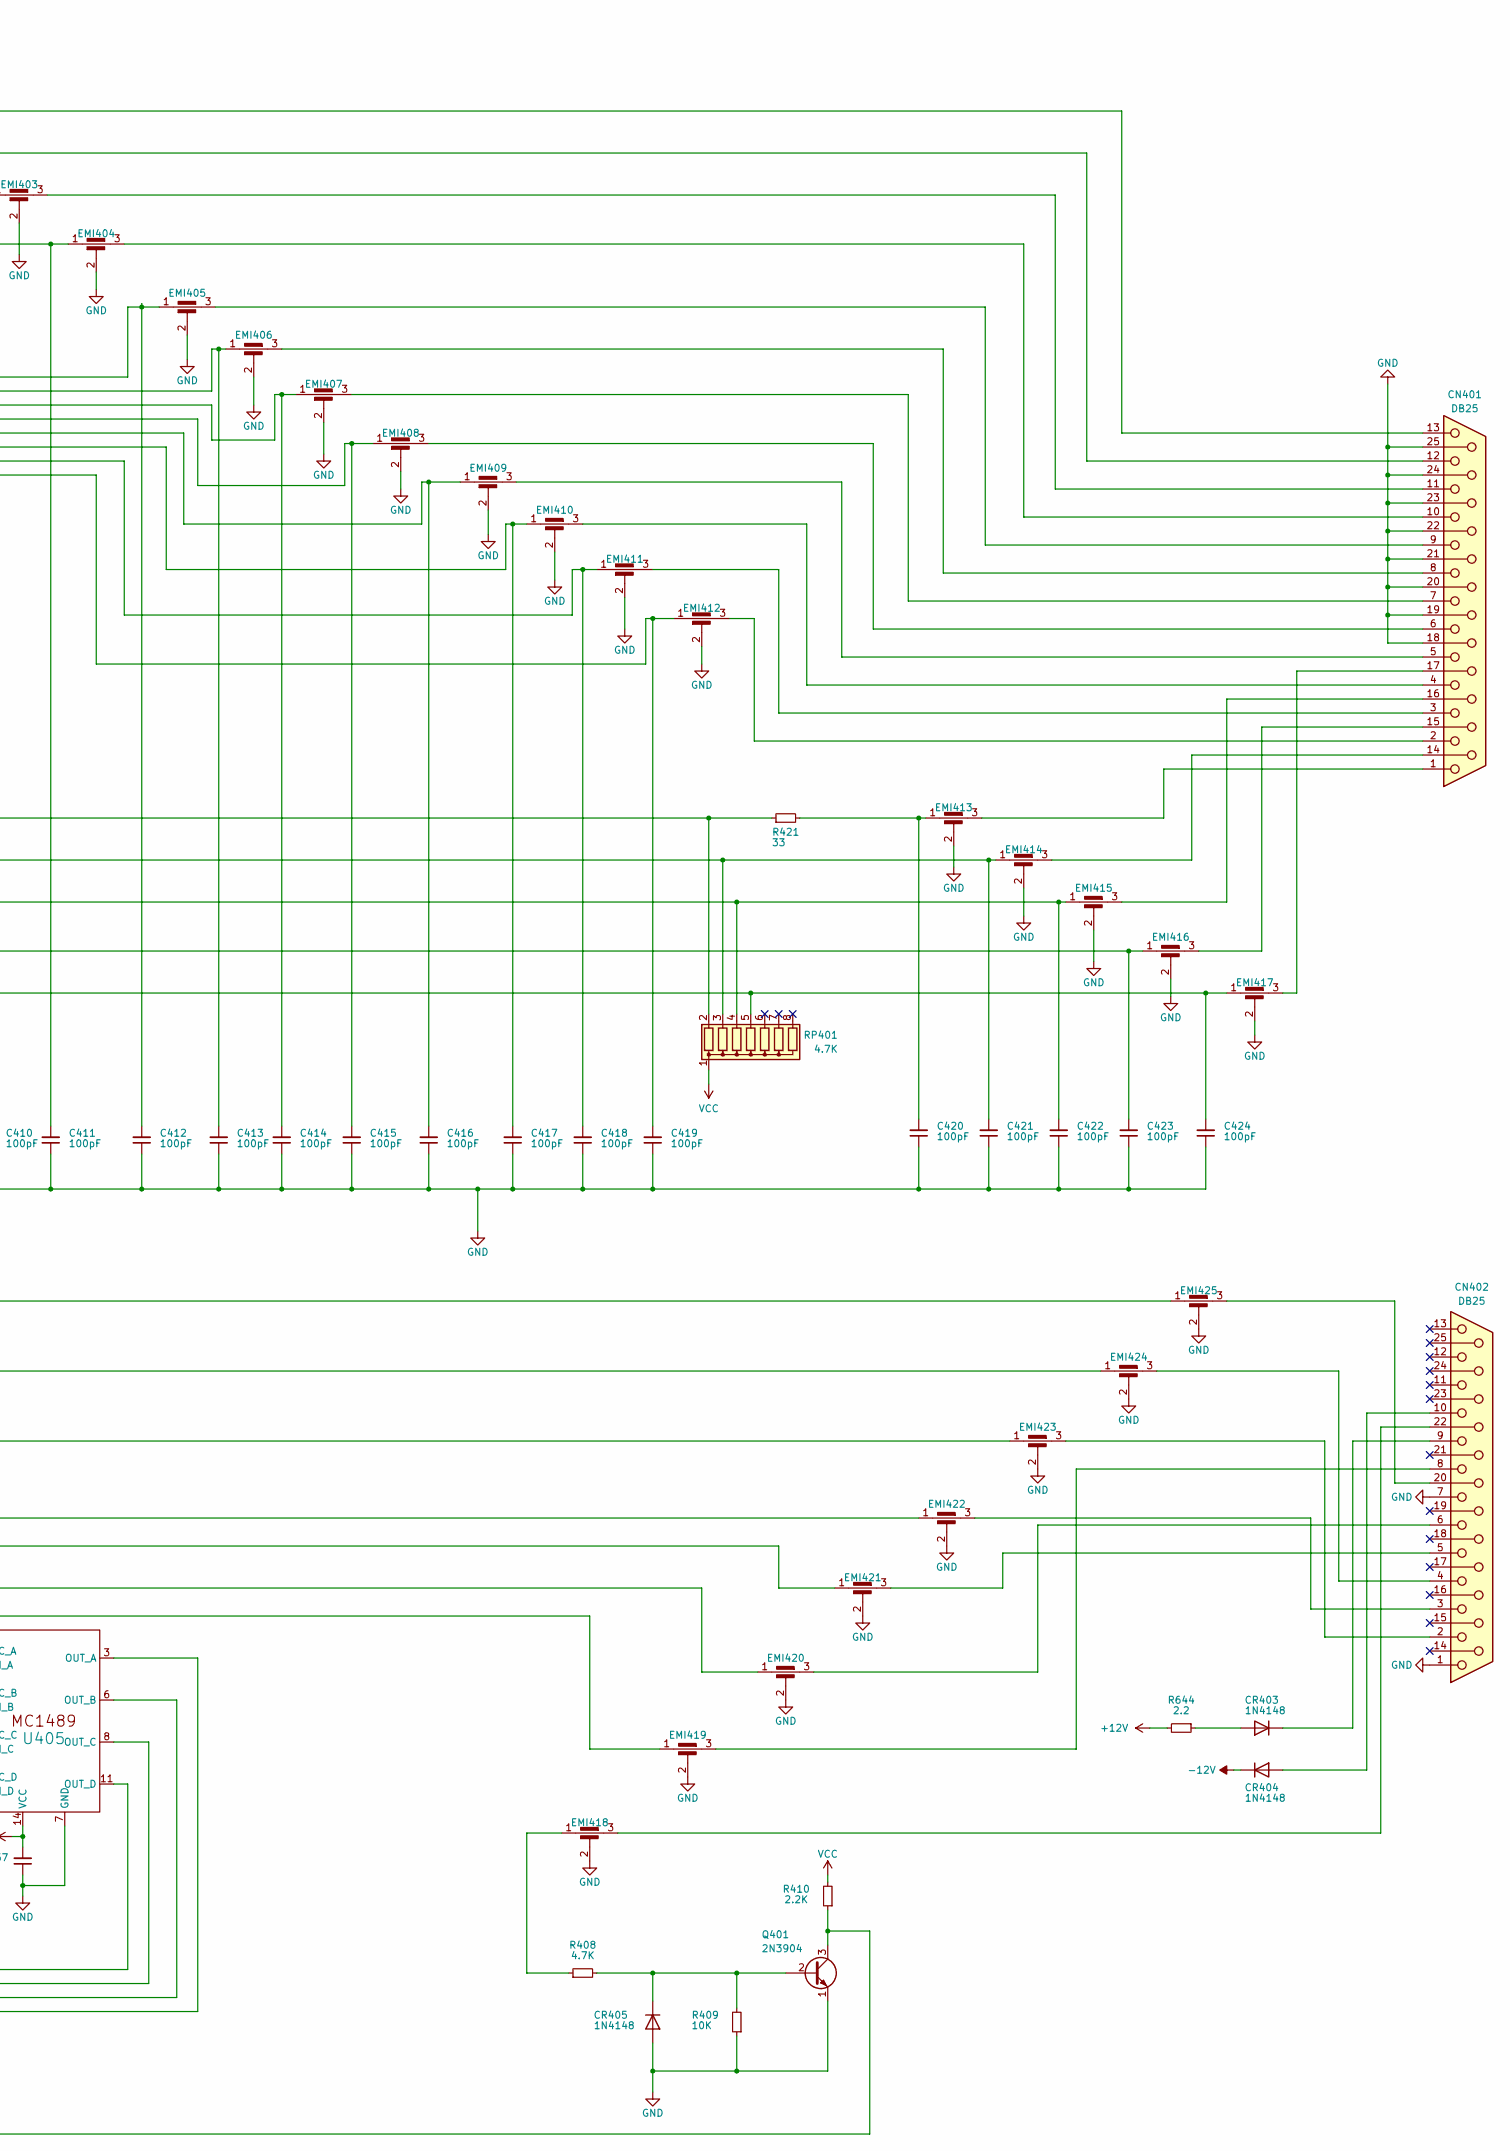
[picture p34: schematic PRINTER_SERIAL.kicad_sch, part in row 1, column 2]

Parts:
BT601: Battery; BT601 - Battery
C401: 22pF; C_Disc 2_P5.00mm
C402: 22-47pF; C402 - Pot
C403: 4.7uF; Electrolytic_P5.00mm
C404: .1uF; C_Disc_P5.00mm
C405: 22PF; C_Disc_P5.00mm
C406: 47PF; C_Disc_P5.00mm
C408, C409, C410, C411, C412, C413, C414, C415, C416, C417, C418, C419, C420, C421, C422, C423, C424: 100pF; C_Disc_P5.00mm
C757, C760, C761, C762, C776: .1; C_Disc_P5.00mm
CN401: DB25; CN401
CN402: DB25; CN402
CR401, CR402: 1N914; Diode_Axial_P12.70mm
CR403, CR404, CR405: 1N4148; Diode_Axial_P12.70mm
EMI401, EMI402, EMI403, EMI404, EMI405, EMI406, EMI407, EMI408, EMI409, EMI410, EMI411, EMI412, EMI413, EMI414, EMI415, EMI416, EMI417, EMI418, EMI419, EMI420, EMI421, EMI422, EMI423, EMI424, EMI425: EMI
Q401: 2N3904; TO-92_Transistor
R401, R402: 470; R_Axial_P12.70mm
R403, R405: 1MEG; R_Axial_P12.70mm
R404, R421: 33; R_Axial_P12.70mm
R407, R410: 2.2K; R_Axial_P12.70mm
R408, R412, R413, R414: 4.7K; R_Axial_P12.70mm
R409, R411: 10K; R_Axial_P12.70mm
R644: 2.2; R_Axial_P12.70mm
RP401: 4.7K; R_Array_SIP8
RP402: 33; DIP-16_W7.62mm
U401: 6242; DIP-18_W7.62mm
U402: 8250; DIP-40_W15.24mm
U403: PPC1; DIP-40_W15.24mm
U404: MC1488; DIP-14_W7.62mm
U405: MC1489; DIP-14_W7.62mm
XTAL2: 32.XXKHZ; XTAL-2
XTAL3: 1.8MHZ; XTAL3

Connections:
+12V: C760.2, R401.2, R644.2, U404.14 (VCC+)
-12V: C761.2, CR404.1 (K), U404.1 (VCC-)
BADDR0: U401.4 (A0), U402.28 (A0), U403.4 (A0)
BADDR1: U401.5 (A1), U402.27 (A1), U403.7 (A1)
BADDR2: U401.6 (A2), U402.26 (A2)
BADDR3: U401.7 (A3)
COMINT: U402.30 (INTR)
GND: BT601.2 (-), C401.1, C402.1, C403.2, C404.1, C405.2, C406.1, C408.1, C409.1, C410.1, C411.1, C412.1, C413.1, C414.1, C415.1, C416.1, C417.1, C418.1, C419.1, C420.1, C421.1, C422.1, C423.1, C424.1, C757.1, C760.1, C761.1, C762.1, C776.1, CN401.18, CN401.19, CN401.20, CN401.21, CN401.22, CN401.23, CN401.24, CN401.25, CN402.1, CN402.7, CR405.2 (A), EMI401.2, EMI402.2, EMI403.2, EMI404.2, EMI405.2, EMI406.2, EMI407.2, EMI408.2, EMI409.2, EMI410.2, EMI411.2, EMI412.2, EMI413.2, EMI414.2, EMI415.2, EMI416.2, EMI417.2, EMI418.2, EMI419.2, EMI420.2, EMI421.2, EMI422.2, EMI423.2, EMI424.2, EMI425.2, Q401.1 (E), R403.1, R409.1, U401.9 (GND), U402.19 (WR), U402.20 (GND), U402.22 (RD), U402.25 (~ADS), U403.1 (GND), U403.5 (GND), U403.16 (GND), U404.7 (GND), U405.7 (GND)
IDATA0: U401.14 (D0), U402.1 (D0), U403.33 (D0)
IDATA1: U401.13 (D1), U402.2 (D1), U403.34 (D1)
IDATA2: U401.12 (D2), U402.3 (D2), U403.36 (D2)
IDATA3: U401.11 (D3), U402.4 (D3), U403.37 (D3)
IDATA4: U402.5 (D4), U403.38 (D4)
IDATA5: U402.6 (D5), U403.39 (D5)
IDATA6: U402.7 (D6), U403.40 (D6)
IDATA7: U402.8 (D7), U403.2 (D7)
IRQ7: U403.21 (IRQ)
unnamed: BT601.1 (+), R402.1
unnamed: C401.2, U401.17 (~XT), XTAL2.1
unnamed: C402.2, U401.16 (XT), XTAL2.2
unnamed: C405.1, R403.2, R405.1, U402.16 (XIN), XTAL3.1
unnamed: C406.2, R404.1, R405.2, XTAL3.2
unnamed: C408.2, EMI401.1, U403.24 (SLCT)
unnamed: C409.2, EMI402.1, U403.18 (PAPE)
unnamed: C410.2, EMI403.1, U403.20 (BUSY)
unnamed: C411.2, EMI404.1, U403.22 (ACKN)
unnamed: C412.2, EMI405.1, RP402.16 (R1.2)
unnamed: C413.2, EMI406.1, RP402.15 (R2.2)
unnamed: C414.2, EMI407.1, RP402.14 (R3.2)
unnamed: C415.2, EMI408.1, RP402.13 (R4.2)
unnamed: C416.2, EMI409.1, RP402.12 (R5.2)
unnamed: C417.2, EMI410.1, RP402.11 (R6.2)
unnamed: C418.2, EMI411.1, RP402.10 (R7.2)
unnamed: C419.2, EMI412.1, RP402.9 (R8.2)
unnamed: C420.2, EMI413.1, R421.2
unnamed: C421.2, EMI414.1, RP401.3 (R2), U403.27 (AFXN)
unnamed: C422.2, EMI415.1, RP401.4 (R3), U403.28 (ININ)
unnamed: C423.2, EMI416.1, U403.25 (ERRN)
unnamed: C424.2, EMI417.1, RP401.5 (R4), U403.29 (SLCN)
unnamed: CN401.1, EMI413.3
unnamed: CN401.2, EMI412.3
unnamed: CN401.3, EMI411.3
unnamed: CN401.4, EMI410.3
unnamed: CN401.5, EMI409.3
unnamed: CN401.6, EMI408.3
unnamed: CN401.7, EMI407.3
unnamed: CN401.8, EMI406.3
unnamed: CN401.9, EMI405.3
unnamed: CN401.10, EMI404.3
unnamed: CN401.11, EMI403.3
unnamed: CN401.12, EMI402.3
unnamed: CN401.13, EMI401.3
unnamed: CN401.14, EMI414.3
unnamed: CN401.15, EMI416.3
unnamed: CN401.16, EMI415.3
unnamed: CN401.17, EMI417.3
unnamed: CN402.2, EMI423.3
unnamed: CN402.3, EMI422.3
unnamed: CN402.4, EMI424.3
unnamed: CN402.5, EMI421.3
unnamed: CN402.6, EMI420.3
unnamed: CN402.8, EMI419.3
unnamed: CN402.9, CR403.1 (K)
unnamed: CN402.10, CR404.2 (A)
unnamed: CN402.20, EMI425.3
unnamed: CN402.22, EMI418.3
unnamed: CR401.2 (A), CR402.2 (A), R401.1
unnamed: CR403.2 (A), R644.1
unnamed: CR405.1 (K), Q401.2 (B), R408.2, R409.2
unnamed: EMI418.1, R408.1
unnamed: EMI419.1, U405.1 (IN_A)
unnamed: EMI420.1, U405.4 (IN_B)
unnamed: EMI421.1, U405.10 (IN_C)
unnamed: EMI422.1, U405.13 (IN_D)
unnamed: EMI423.1, U404.6 (2Y)
unnamed: EMI424.1, U404.8 (3Y)
unnamed: EMI425.1, U404.11 (4Y)
unnamed: Q401.3 (C), R410.1, U402.39 (~RI)
unnamed: R404.2, U402.17 (XOUT)
unnamed: R407.2, U404.5 (2B), U404.10 (3B), U404.13 (4B)
unnamed: R411.2, U401.1 (STD.P)
unnamed: R412.2, U402.12 (CS0), U402.13 (CS1)
unnamed: R414.2, U402.34 (~OUT1)
unnamed: R421.1, RP401.2 (R1), U403.26 (STBN)
unnamed: RP402.1 (R1.1), U403.19 (DAT7)
unnamed: RP402.2 (R2.1), U403.17 (DAT6)
unnamed: RP402.3 (R3.1), U403.14 (DAT5)
unnamed: RP402.4 (R4.1), U403.12 (DAT4)
unnamed: RP402.5 (R5.1), U403.10 (DAT3)
unnamed: RP402.6 (R6.1), U403.8 (DAT2)
unnamed: RP402.7 (R7.1), U403.6 (DAT1)
unnamed: RP402.8 (R8.1), U403.3 (DAT0)
unnamed: U402.10 (SIN), U405.11 (OUT_D)
unnamed: U402.11 (SOUT), U404.4 (2A)
unnamed: U402.9 (RCLK), U402.15 (~BAUDOUT)
unnamed: U402.32 (~RTS), U404.9 (3A)
unnamed: U402.33 (~DTR), U404.12 (4A)
unnamed: U402.36 (~CTS), U405.8 (OUT_C)
unnamed: U402.37 (~DSR), U405.6 (OUT_B)
unnamed: U402.38 (~DCD), U405.3 (OUT_A)
RESET: U402.35 (MR)
VCC: C403.1, C404.2, C757.2, C762.2, C776.2, CR401.1 (K), CR402.1 (K), R402.2, R407.1, R410.2, R411.1, R412.1, R413.1, R414.1, RP401.1 (common), U401.3 (ALE), U401.15 (CS1), U401.18 (VCC), U402.40 (VCC), U403.9 (A2), U403.11 (A3), U403.13 (A4), U403.15 (A5), U403.35 (VCC), U405.14 (VCC)
~IOR-DLY: U402.21 (~RD)
~IOW-DLY: U402.18 (~WR)
~LPTCS: U403.23 (CEN)
~NIOR: U401.8 (~RD), U403.31 (IORN)
~NIOW: U401.10 (~WR), U403.30 (IOWN)
~OUT1: R413.2, U402.31 (~OUT2)
~RESET: U403.32 (RSTN)
~RTCLOCKCS: U401.2 (~CS0)
~UARTCS: U402.14 (~CS2)
