Board-Folk/Commodore-PC10-III-Reproduction/312628-REV-5.7A/sheets/RAM.kicad_sch

## KiCad design 312628-REV-5.7A/sheets/RAM.kicad_sch (2024-12-30)

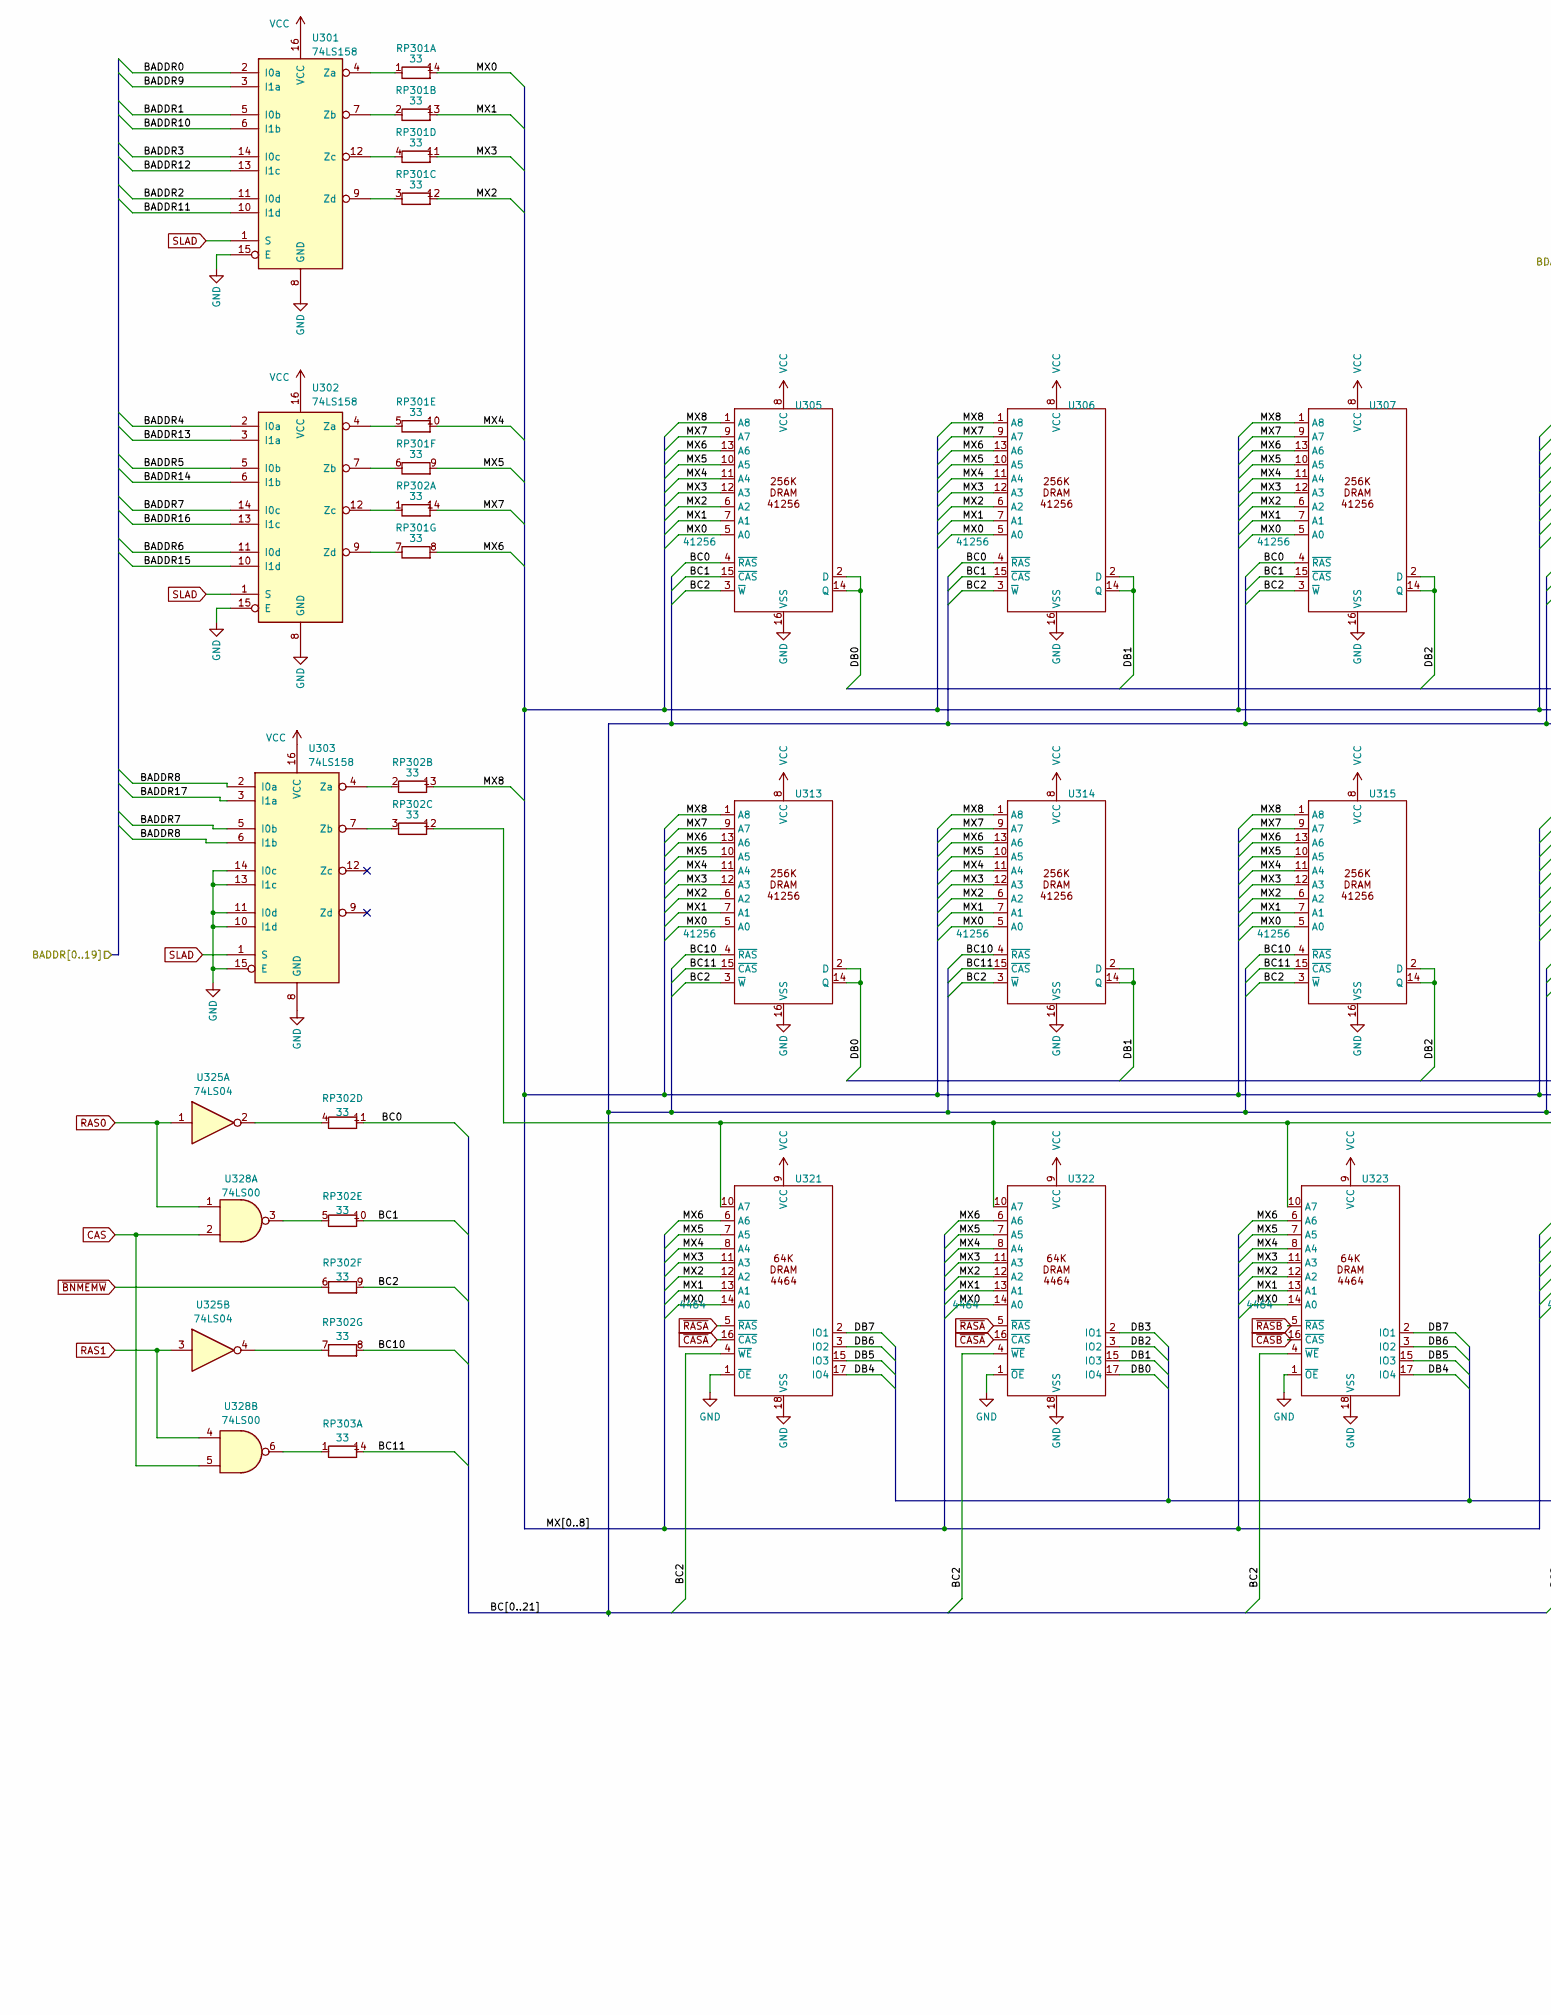
[picture p35: schematic RAM.kicad_sch, part in row 1, column 1]

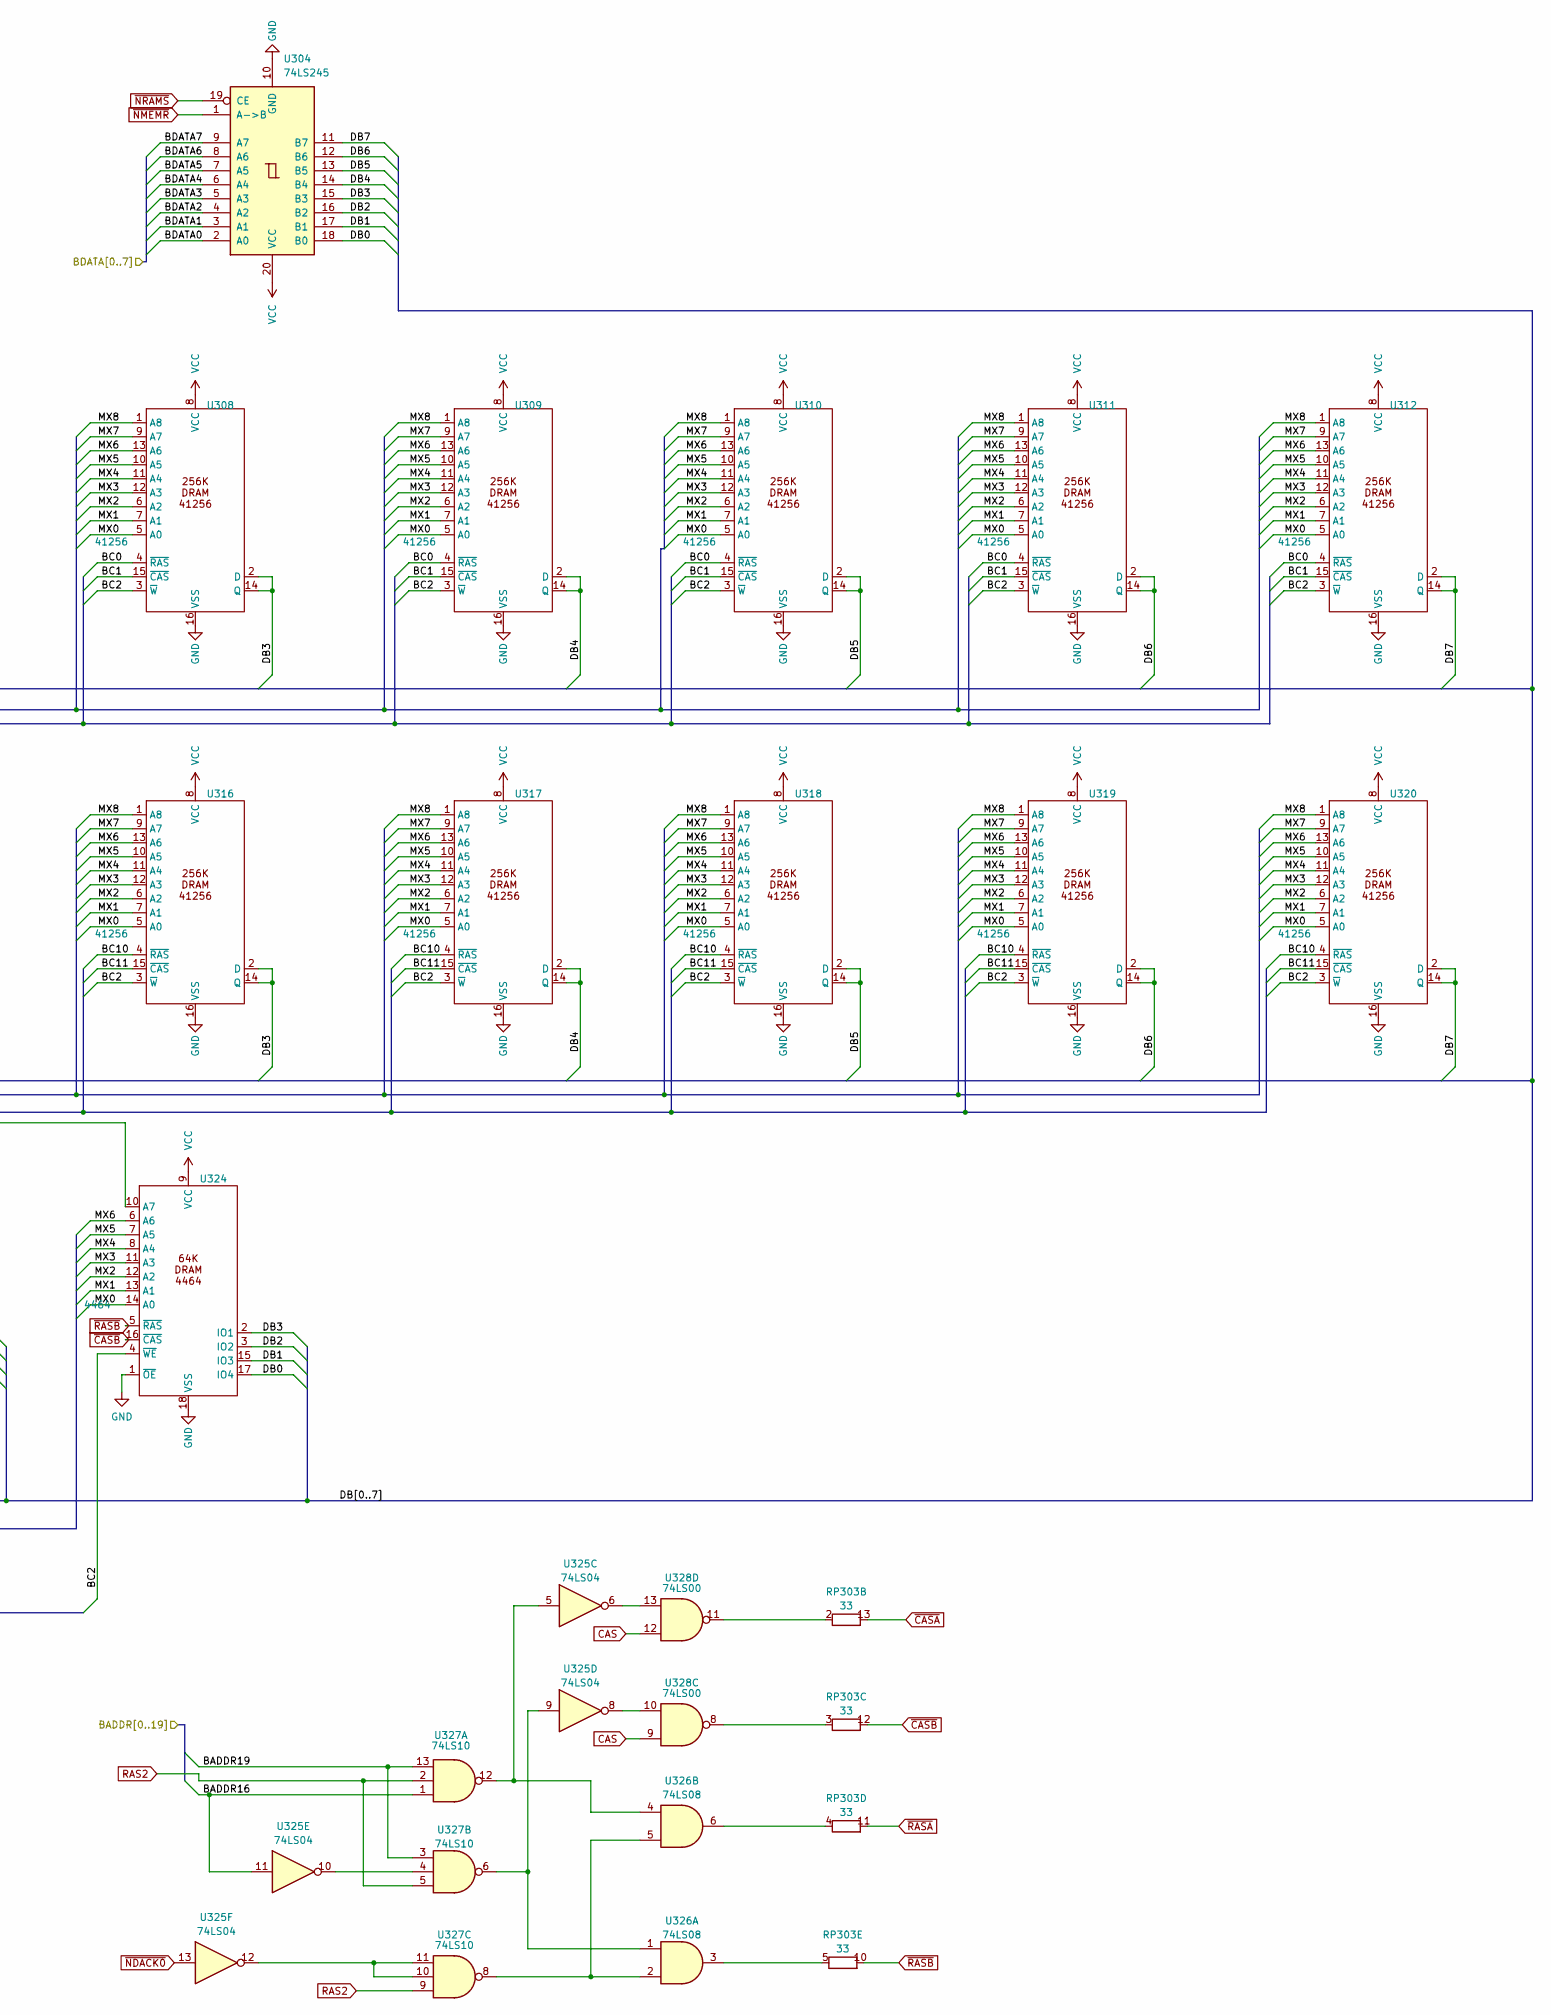
[picture p36: schematic RAM.kicad_sch, part in row 1, column 2]

Parts:
RP301, RP302, RP303: 33; DIP-14_W7.62mm
U301, U302, U303: 74LS158; DIP-16_W7.62mm
U304: 74LS245; DIP-20_W7.62mm
U305, U306, U307, U308, U309, U310, U311, U312, U313, U314, U315, U316, U317, U318, U319, U320: 41256; DIP-16_W7.62mm
U321, U322, U323, U324: 4464; DIP-18_W7.62mm
U325: 74LS04; DIP-14_W7.62mm
U326: 74LS08; DIP-14_W7.62mm
U327: 74LS10; DIP-14_W7.62mm
U328: 74LS00; DIP-14_W7.62mm

Connections:
BADDR0: U301.2 (I0a)
BADDR1: U301.5 (I0b)
BADDR2: U301.11 (I0d)
BADDR3: U301.14 (I0c)
BADDR4: U302.2 (I0a)
BADDR5: U302.5 (I0b)
BADDR6: U302.11 (I0d)
BADDR7: U302.14 (I0c), U303.5 (I0b)
BADDR8: U303.2 (I0a), U303.6 (I1b)
BADDR9: U301.3 (I1a)
BADDR10: U301.6 (I1b)
BADDR11: U301.10 (I1d)
BADDR12: U301.13 (I1c)
BADDR13: U302.3 (I1a)
BADDR14: U302.6 (I1b)
BADDR15: U302.10 (I1d)
BADDR16: U302.13 (I1c), U325.11, U327.1
BADDR17: U303.3 (I1a)
BADDR19: U327.3, U327.13
BC0: RP302.11 (R4.2), U305.4 (~RAS), U306.4 (~RAS), U307.4 (~RAS), U308.4 (~RAS), U309.4 (~RAS), U310.4 (~RAS), U311.4 (~RAS), U312.4 (~RAS)
BC1: RP302.10 (R5.2), U305.15 (~CAS), U306.15 (~CAS), U307.15 (~CAS), U308.15 (~CAS), U309.15 (~CAS), U310.15 (~CAS), U311.15 (~CAS), U312.15 (~CAS)
BC2: RP302.9 (R6.2), U305.3 (~W), U306.3 (~W), U307.3 (~W), U308.3 (~W), U309.3 (~W), U310.3 (~W), U311.3 (~W), U312.3 (~W), U313.3 (~W), U314.3 (~W), U315.3 (~W), U316.3 (~W), U317.3 (~W), U318.3 (~W), U319.3 (~W), U320.3 (~W), U321.4 (~WE), U322.4 (~WE), U323.4 (~WE), U324.4 (~WE)
BC10: RP302.8 (R7.2), U313.4 (~RAS), U314.4 (~RAS), U315.4 (~RAS), U316.4 (~RAS), U317.4 (~RAS), U318.4 (~RAS), U319.4 (~RAS), U320.4 (~RAS)
BC11: RP303.14 (R1.2), U313.15 (~CAS), U314.15 (~CAS), U315.15 (~CAS), U316.15 (~CAS), U317.15 (~CAS), U318.15 (~CAS), U319.15 (~CAS), U320.15 (~CAS)
BDATA0: U304.2 (A0)
BDATA1: U304.3 (A1)
BDATA2: U304.4 (A2)
BDATA3: U304.5 (A3)
BDATA4: U304.6 (A4)
BDATA5: U304.7 (A5)
BDATA6: U304.8 (A6)
BDATA7: U304.9 (A7)
CAS: U328.2, U328.5, U328.9, U328.12
DB0: U304.18 (B0), U305.2 (D), U305.14 (Q), U313.2 (D), U313.14 (Q), U322.17 (IO4), U324.17 (IO4)
DB1: U304.17 (B1), U306.2 (D), U306.14 (Q), U314.2 (D), U314.14 (Q), U322.15 (IO3), U324.15 (IO3)
DB2: U304.16 (B2), U307.2 (D), U307.14 (Q), U315.2 (D), U315.14 (Q), U322.3 (IO2), U324.3 (IO2)
DB3: U304.15 (B3), U308.2 (D), U308.14 (Q), U316.2 (D), U316.14 (Q), U322.2 (IO1), U324.2 (IO1)
DB4: U304.14 (B4), U309.2 (D), U309.14 (Q), U317.2 (D), U317.14 (Q), U321.17 (IO4), U323.17 (IO4)
DB5: U304.13 (B5), U310.2 (D), U310.14 (Q), U318.2 (D), U318.14 (Q), U321.15 (IO3), U323.15 (IO3)
DB6: U304.12 (B6), U311.2 (D), U311.14 (Q), U319.2 (D), U319.14 (Q), U321.3 (IO2), U323.3 (IO2)
DB7: U304.11 (B7), U312.2 (D), U312.14 (Q), U320.2 (D), U320.14 (Q), U321.2 (IO1), U323.2 (IO1)
GND: U301.8 (GND), U301.15 (E), U302.8 (GND), U302.15 (E), U303.8 (GND), U303.10 (I1d), U303.11 (I0d), U303.13 (I1c), U303.14 (I0c), U303.15 (E), U304.10 (GND), U305.16 (VSS), U306.16 (VSS), U307.16 (VSS), U308.16 (VSS), U309.16 (VSS), U310.16 (VSS), U311.16 (VSS), U312.16 (VSS), U313.16 (VSS), U314.16 (VSS), U315.16 (VSS), U316.16 (VSS), U317.16 (VSS), U318.16 (VSS), U319.16 (VSS), U320.16 (VSS), U321.1 (~OE), U321.18 (VSS), U322.1 (~OE), U322.18 (VSS), U323.1 (~OE), U323.18 (VSS), U324.1 (~OE), U324.18 (VSS)
MX0: RP301.14 (R1.2), U305.5 (A0), U306.5 (A0), U307.5 (A0), U308.5 (A0), U309.5 (A0), U310.5 (A0), U311.5 (A0), U312.5 (A0), U313.5 (A0), U314.5 (A0), U315.5 (A0), U316.5 (A0), U317.5 (A0), U318.5 (A0), U319.5 (A0), U320.5 (A0), U321.14 (A0), U322.14 (A0), U323.14 (A0), U324.14 (A0)
MX1: RP301.13 (R2.2), U305.7 (A1), U306.7 (A1), U307.7 (A1), U308.7 (A1), U309.7 (A1), U310.7 (A1), U311.7 (A1), U312.7 (A1), U313.7 (A1), U314.7 (A1), U315.7 (A1), U316.7 (A1), U317.7 (A1), U318.7 (A1), U319.7 (A1), U320.7 (A1), U321.13 (A1), U322.13 (A1), U323.13 (A1), U324.13 (A1)
MX2: RP301.12 (R3.2), U305.6 (A2), U306.6 (A2), U307.6 (A2), U308.6 (A2), U309.6 (A2), U310.6 (A2), U311.6 (A2), U312.6 (A2), U313.6 (A2), U314.6 (A2), U315.6 (A2), U316.6 (A2), U317.6 (A2), U318.6 (A2), U319.6 (A2), U320.6 (A2), U321.12 (A2), U322.12 (A2), U323.12 (A2), U324.12 (A2)
MX3: RP301.11 (R4.2), U305.12 (A3), U306.12 (A3), U307.12 (A3), U308.12 (A3), U309.12 (A3), U310.12 (A3), U311.12 (A3), U312.12 (A3), U313.12 (A3), U314.12 (A3), U315.12 (A3), U316.12 (A3), U317.12 (A3), U318.12 (A3), U319.12 (A3), U320.12 (A3), U321.11 (A3), U322.11 (A3), U323.11 (A3), U324.11 (A3)
MX4: RP301.10 (R5.2), U305.11 (A4), U306.11 (A4), U307.11 (A4), U308.11 (A4), U309.11 (A4), U310.11 (A4), U311.11 (A4), U312.11 (A4), U313.11 (A4), U314.11 (A4), U315.11 (A4), U316.11 (A4), U317.11 (A4), U318.11 (A4), U319.11 (A4), U320.11 (A4), U321.8 (A4), U322.8 (A4), U323.8 (A4), U324.8 (A4)
MX5: RP301.9 (R6.2), U305.10 (A5), U306.10 (A5), U307.10 (A5), U308.10 (A5), U309.10 (A5), U310.10 (A5), U311.10 (A5), U312.10 (A5), U313.10 (A5), U314.10 (A5), U315.10 (A5), U316.10 (A5), U317.10 (A5), U318.10 (A5), U319.10 (A5), U320.10 (A5), U321.7 (A5), U322.7 (A5), U323.7 (A5), U324.7 (A5)
MX6: RP301.8 (R7.2), U305.13 (A6), U306.13 (A6), U307.13 (A6), U308.13 (A6), U309.13 (A6), U310.13 (A6), U311.13 (A6), U312.13 (A6), U313.13 (A6), U314.13 (A6), U315.13 (A6), U316.13 (A6), U317.13 (A6), U318.13 (A6), U319.13 (A6), U320.13 (A6), U321.6 (A6), U322.6 (A6), U323.6 (A6), U324.6 (A6)
MX7: RP302.14 (R1.2), U305.9 (A7), U306.9 (A7), U307.9 (A7), U308.9 (A7), U309.9 (A7), U310.9 (A7), U311.9 (A7), U312.9 (A7), U313.9 (A7), U314.9 (A7), U315.9 (A7), U316.9 (A7), U317.9 (A7), U318.9 (A7), U319.9 (A7), U320.9 (A7)
MX8: RP302.13 (R2.2), U305.1 (A8), U306.1 (A8), U307.1 (A8), U308.1 (A8), U309.1 (A8), U310.1 (A8), U311.1 (A8), U312.1 (A8), U313.1 (A8), U314.1 (A8), U315.1 (A8), U316.1 (A8), U317.1 (A8), U318.1 (A8), U319.1 (A8), U320.1 (A8)
unnamed: RP301.1 (R1.1), U301.4 (Za)
unnamed: RP301.2 (R2.1), U301.7 (Zb)
unnamed: RP301.3 (R3.1), U301.9 (Zd)
unnamed: RP301.4 (R4.1), U301.12 (Zc)
unnamed: RP301.5 (R5.1), U302.4 (Za)
unnamed: RP301.6 (R6.1), U302.7 (Zb)
unnamed: RP301.7 (R7.1), U302.9 (Zd)
unnamed: RP302.1 (R1.1), U302.12 (Zc)
unnamed: RP302.2 (R2.1), U303.4 (Za)
unnamed: RP302.3 (R3.1), U303.7 (Zb)
unnamed: RP302.4 (R4.1), U325.2
unnamed: RP302.5 (R5.1), U328.3
unnamed: RP302.7 (R7.1), U325.4
unnamed: RP302.12 (R3.2), U321.10 (A7), U322.10 (A7), U323.10 (A7), U324.10 (A7)
unnamed: RP303.1 (R1.1), U328.6
unnamed: RP303.2 (R2.1), U328.11
unnamed: RP303.3 (R3.1), U328.8
unnamed: RP303.4 (R4.1), U326.6
unnamed: RP303.5 (R5.1), U326.3
unnamed: U325.5, U326.4, U327.12
unnamed: U325.6, U328.13
unnamed: U325.8, U328.10
unnamed: U325.9, U326.1, U327.6
unnamed: U325.10, U327.4
unnamed: U325.12, U327.10, U327.11
unnamed: U326.2, U326.5, U327.8
RAS0: U325.1, U328.1
RAS1: U325.3, U328.4
RAS2: U327.2, U327.5, U327.9
SLAD: U301.1 (S), U302.1 (S), U303.1 (S)
VCC: U301.16 (VCC), U302.16 (VCC), U303.16 (VCC), U304.20 (VCC), U305.8 (VCC), U306.8 (VCC), U307.8 (VCC), U308.8 (VCC), U309.8 (VCC), U310.8 (VCC), U311.8 (VCC), U312.8 (VCC), U313.8 (VCC), U314.8 (VCC), U315.8 (VCC), U316.8 (VCC), U317.8 (VCC), U318.8 (VCC), U319.8 (VCC), U320.8 (VCC), U321.9 (VCC), U322.9 (VCC), U323.9 (VCC), U324.9 (VCC)
~BNMEMW: RP302.6 (R6.1)
~CASA: RP303.13 (R2.2), U321.16 (~CAS), U322.16 (~CAS)
~CASB: RP303.12 (R3.2), U323.16 (~CAS), U324.16 (~CAS)
~NDACK0: U325.13
~NMEMR: U304.1 (A->B)
~NRAMS: U304.19 (CE)
~RASA: RP303.11 (R4.2), U321.5 (~RAS), U322.5 (~RAS)
~RASB: RP303.10 (R5.2), U323.5 (~RAS), U324.5 (~RAS)
