Board-Folk/Commodore-PC10-III-Reproduction/312628-REV-6C/sheets/POWER.kicad_sch

## KiCad design 312628-REV-6C/sheets/POWER.kicad_sch (2024-12-30)

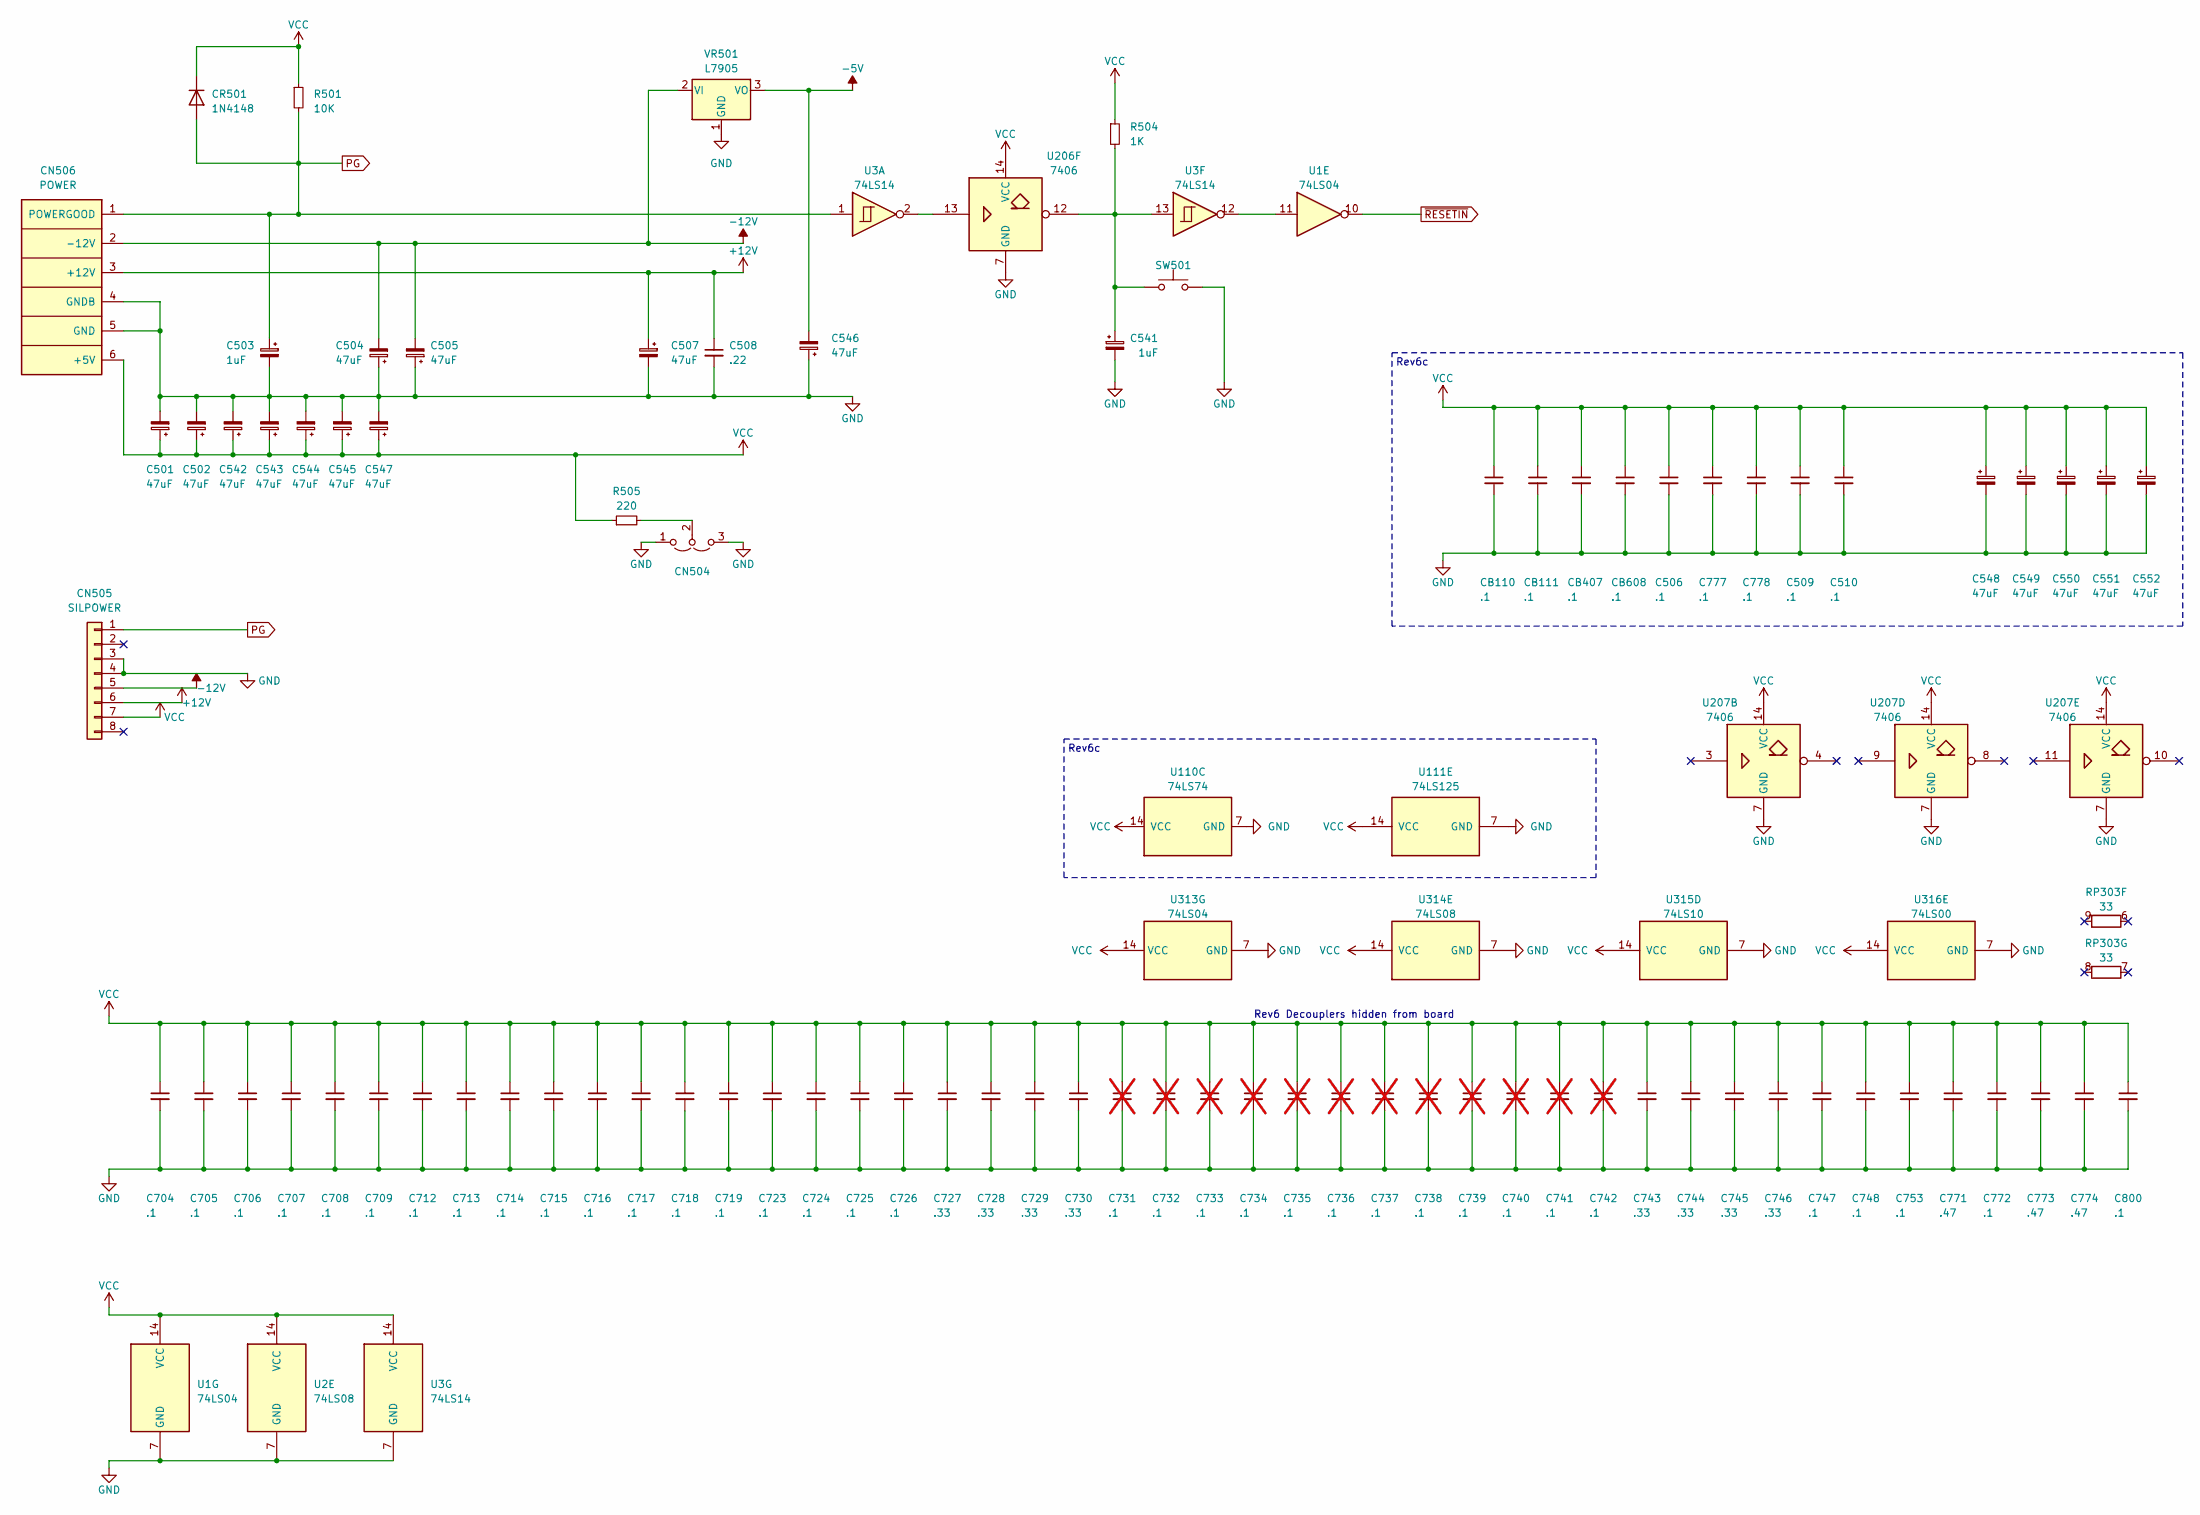
[picture p39: schematic POWER.kicad_sch]

Parts:
C501, C502, C504, C505, C507, C543, C544, C545, C546, C547, C548, C549, C550, C551: 47uF; Electrolytic_P5.00mm
C503, C541: 1uF; Electrolytic_P5.00mm
C506, C509, C510, C704, C705, C706, C707, C708, C709, C712, C713, C714, C715, C716, C717, C718, C719, C723, C724, C725, C726, C747, C748, C753, C772, C777, C778, C800: .1; C_P10.16mm
C508: .22; C_P10.16mm
C542, C552: 47uF; Electrolytic_P5.00mm - Alt Pads
C727, C728, C729, C730, C743, C744, C745, C746: .33; C_P10.16mm
C731, C732, C733, C734, C735, C736, C737, C738, C739, C740, C741, C742: .1; C_P10.16mm; not fitted
C771, C773, C774: .47; C_P10.16mm
CB110, CB111, CB407, CB608: .1; C_P10.16mm
CN504: Jumper_2_Open; PinHeader_1x03_P2.54mm-RoundPads
CN505: SILPOWER; CN505
CN506: POWER; CN506
CR501: 1N4148; Diode_Axial_P10.00mm
R501: 10K; R_Axial_P10.00mm
R504: 1K; R_Axial_P10.00mm
R505: 220; R_Axial_P10.16mm_Hor
RP303: 33; DIP-14_W7.62mm
SW501: SW_Push; SW501
U1, U313: 74LS04; DIP-14_W7.62mm
U2, U314: 74LS08; DIP-14_W7.62mm
U3: 74LS14; DIP-14_W7.62mm
U110: 74LS74; DIP-14_W7.62mm
U111: 74LS125; DIP-14_W7.62mm
U206, U207: 7406; DIP-14_W7.62mm
U315: 74LS10; DIP-14_W7.62mm
U316: 74LS00; DIP-14_W7.62mm
VR501: L7905; VR501

Connections:
+12V: C507.1, C508.1, CN505.6, CN506.3 (+12V)
-5V: C546.2, VR501.3 (VO)
-12V: C504.2, C505.2, CN505.5, CN506.2 (-12V), VR501.2 (VI)
GND: C501.2, C502.2, C503.2, C504.1, C505.1, C506.2, C507.2, C508.2, C509.2, C510.2, C541.2, C542.2, C543.2, C544.2, C545.2, C546.1, C547.2, C548.2, C549.2, C550.2, C551.2, C552.2, C704.2, C705.2, C706.2, C707.2, C708.2, C709.2, C712.2, C713.2, C714.2, C715.2, C716.2, C717.2, C718.2, C719.2, C723.2, C724.2, C725.2, C726.2, C727.2, C728.2, C729.2, C730.2, C731.2, C732.2, C733.2, C734.2, C735.2, C736.2, C737.2, C738.2, C739.2, C740.2, C741.2, C742.2, C743.2, C744.2, C745.2, C746.2, C747.2, C748.2, C753.2, C771.2, C772.2, C773.2, C774.2, C777.2, C778.2, C800.2, CB110.2, CB111.2, CB407.2, CB608.2, CN504.1 (A), CN504.3 (B), CN505.3, CN505.4, CN506.4 (GNDB), CN506.5 (GND), SW501.2, U1.7 (GND), U2.7 (GND), U3.7 (GND), U110.7 (GND), U111.7 (GND), U206.7 (GND), U207.7 (GND), U313.7 (GND), U314.7 (GND), U315.7 (GND), U316.7 (GND), VR501.1 (GND)
unnamed: C541.1, R504.2, SW501.1, U3.13, U206.12
unnamed: CN504.2 (C), R505.2
unnamed: U1.11, U3.12
unnamed: U3.2, U206.13
PG: C503.1, CN505.1, CN506.1 (POWERGOOD), CR501.2 (A), R501.2, U3.1
VCC: C501.1, C502.1, C506.1, C509.1, C510.1, C542.1, C543.1, C544.1, C545.1, C547.1, C548.1, C549.1, C550.1, C551.1, C552.1, C704.1, C705.1, C706.1, C707.1, C708.1, C709.1, C712.1, C713.1, C714.1, C715.1, C716.1, C717.1, C718.1, C719.1, C723.1, C724.1, C725.1, C726.1, C727.1, C728.1, C729.1, C730.1, C731.1, C732.1, C733.1, C734.1, C735.1, C736.1, C737.1, C738.1, C739.1, C740.1, C741.1, C742.1, C743.1, C744.1, C745.1, C746.1, C747.1, C748.1, C753.1, C771.1, C772.1, C773.1, C774.1, C777.1, C778.1, C800.1, CB110.1, CB111.1, CB407.1, CB608.1, CN505.7, CN506.6 (+5V), CR501.1 (K), R501.1, R504.1, R505.1, U1.14 (VCC), U2.14 (VCC), U3.14 (VCC), U110.14 (VCC), U111.14 (VCC), U206.14 (VCC), U207.14 (VCC), U313.14 (VCC), U314.14 (VCC), U315.14 (VCC), U316.14 (VCC)
~RESETIN: U1.10

Notes on the sheet:
Rev6 Decouplers hidden from board
Rev6c
