Board-Folk/Commodore-PC10-III-Reproduction/312628-REV-6C/sheets/RAM.kicad_sch

## KiCad design 312628-REV-6C/sheets/RAM.kicad_sch (2024-12-30)

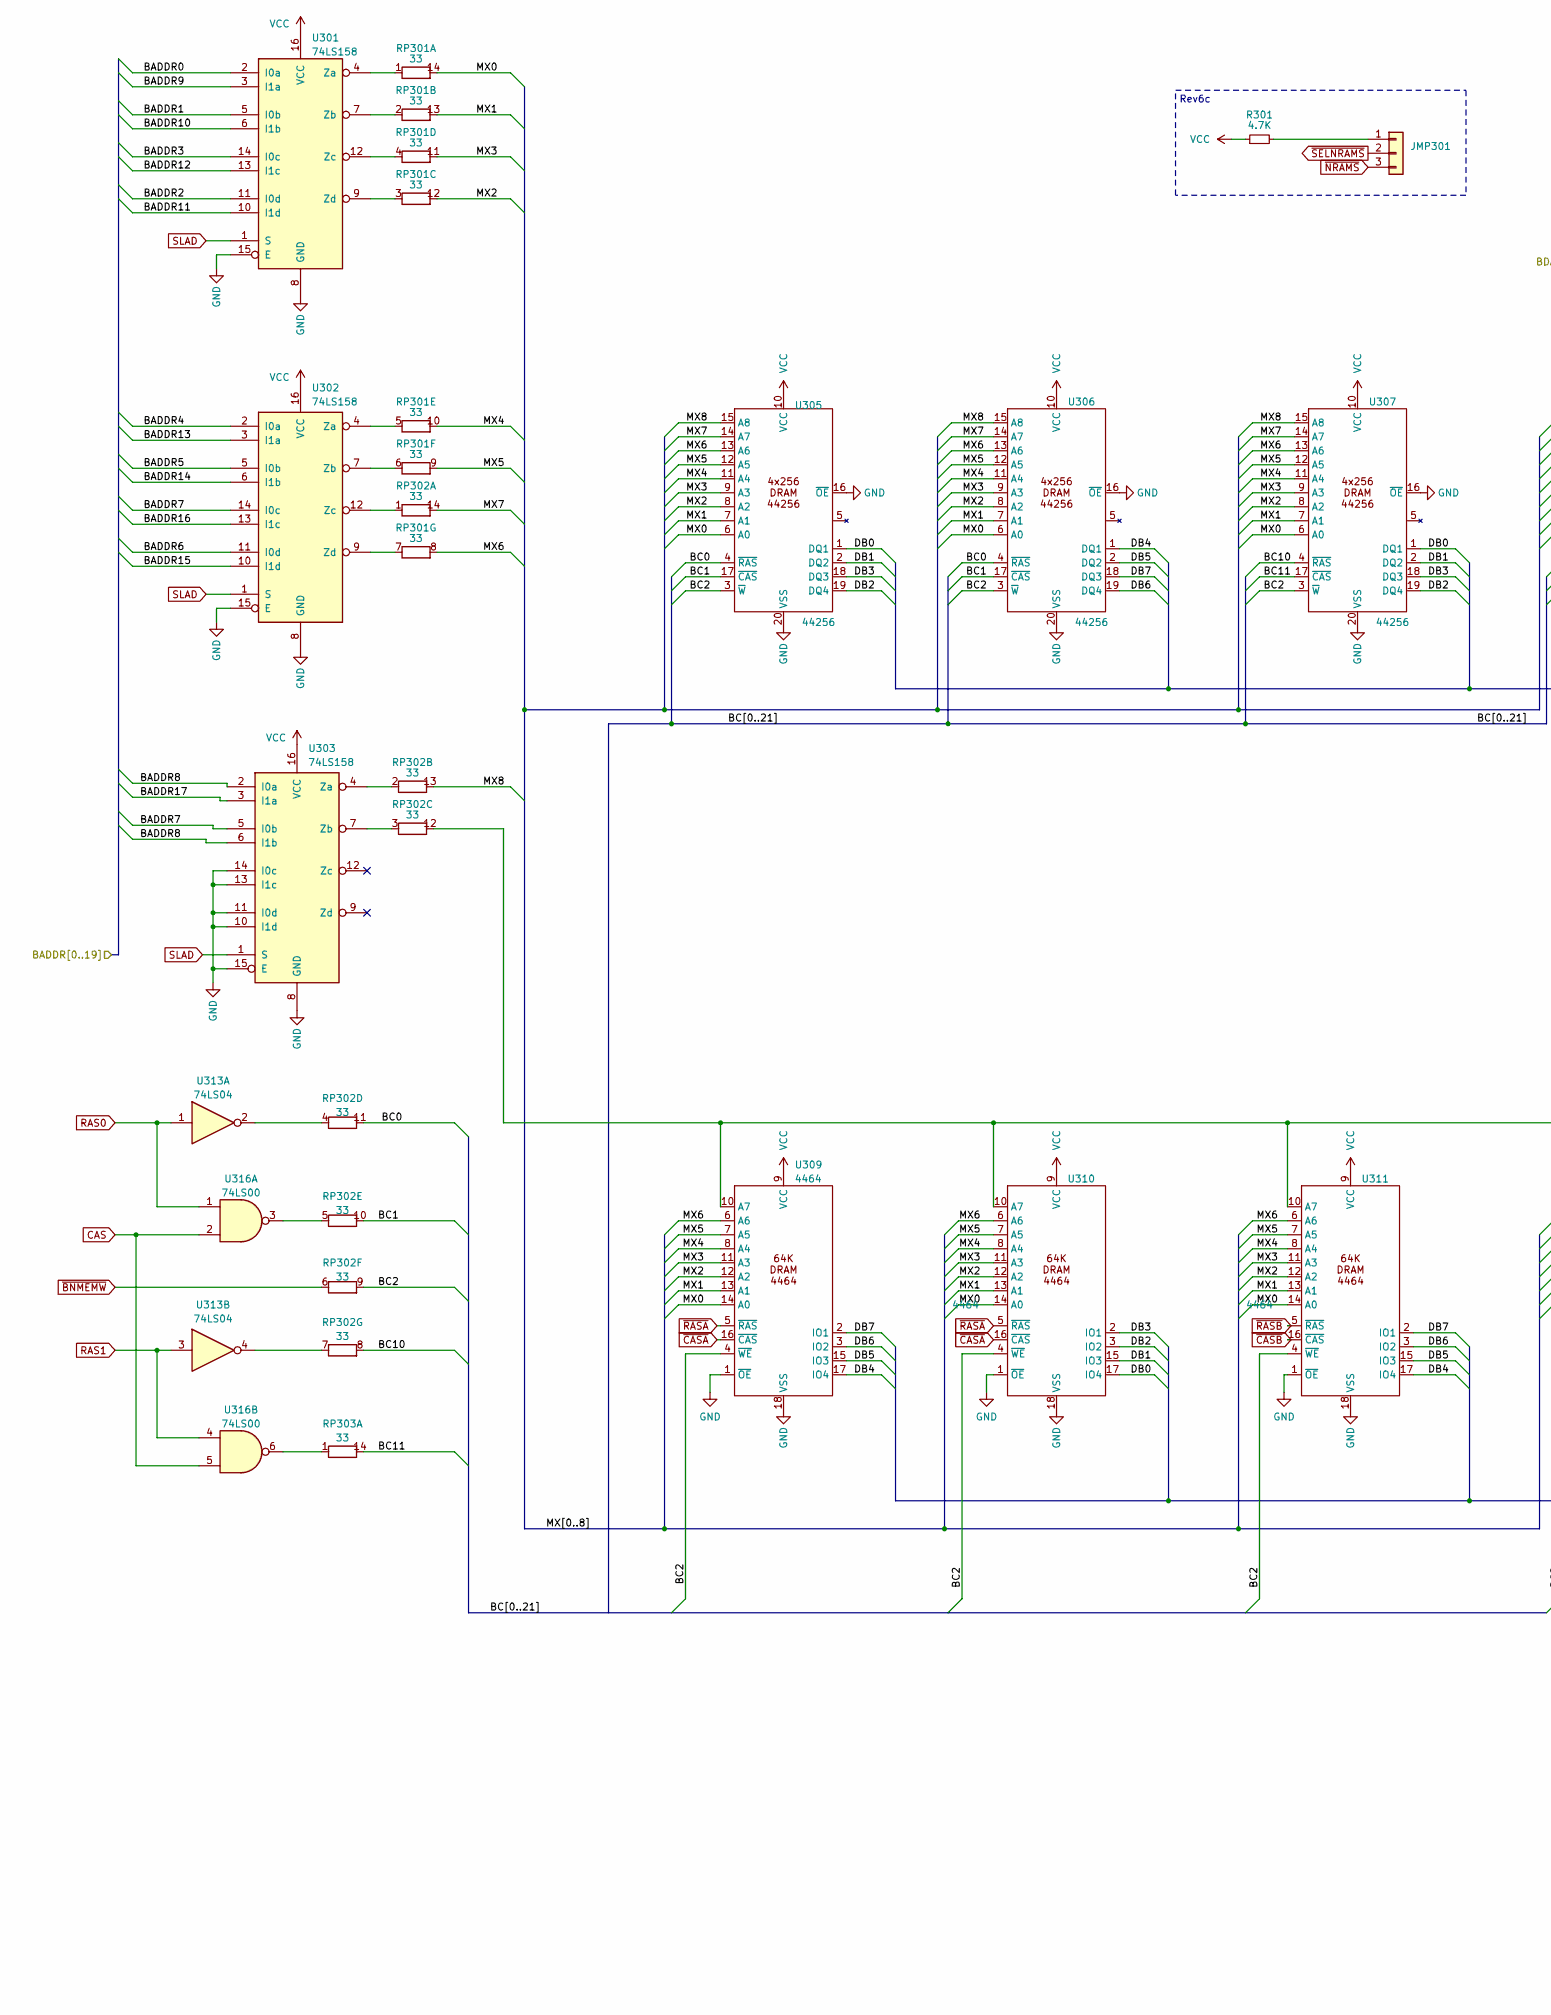
[picture p42: schematic RAM.kicad_sch, part in row 1, column 1]

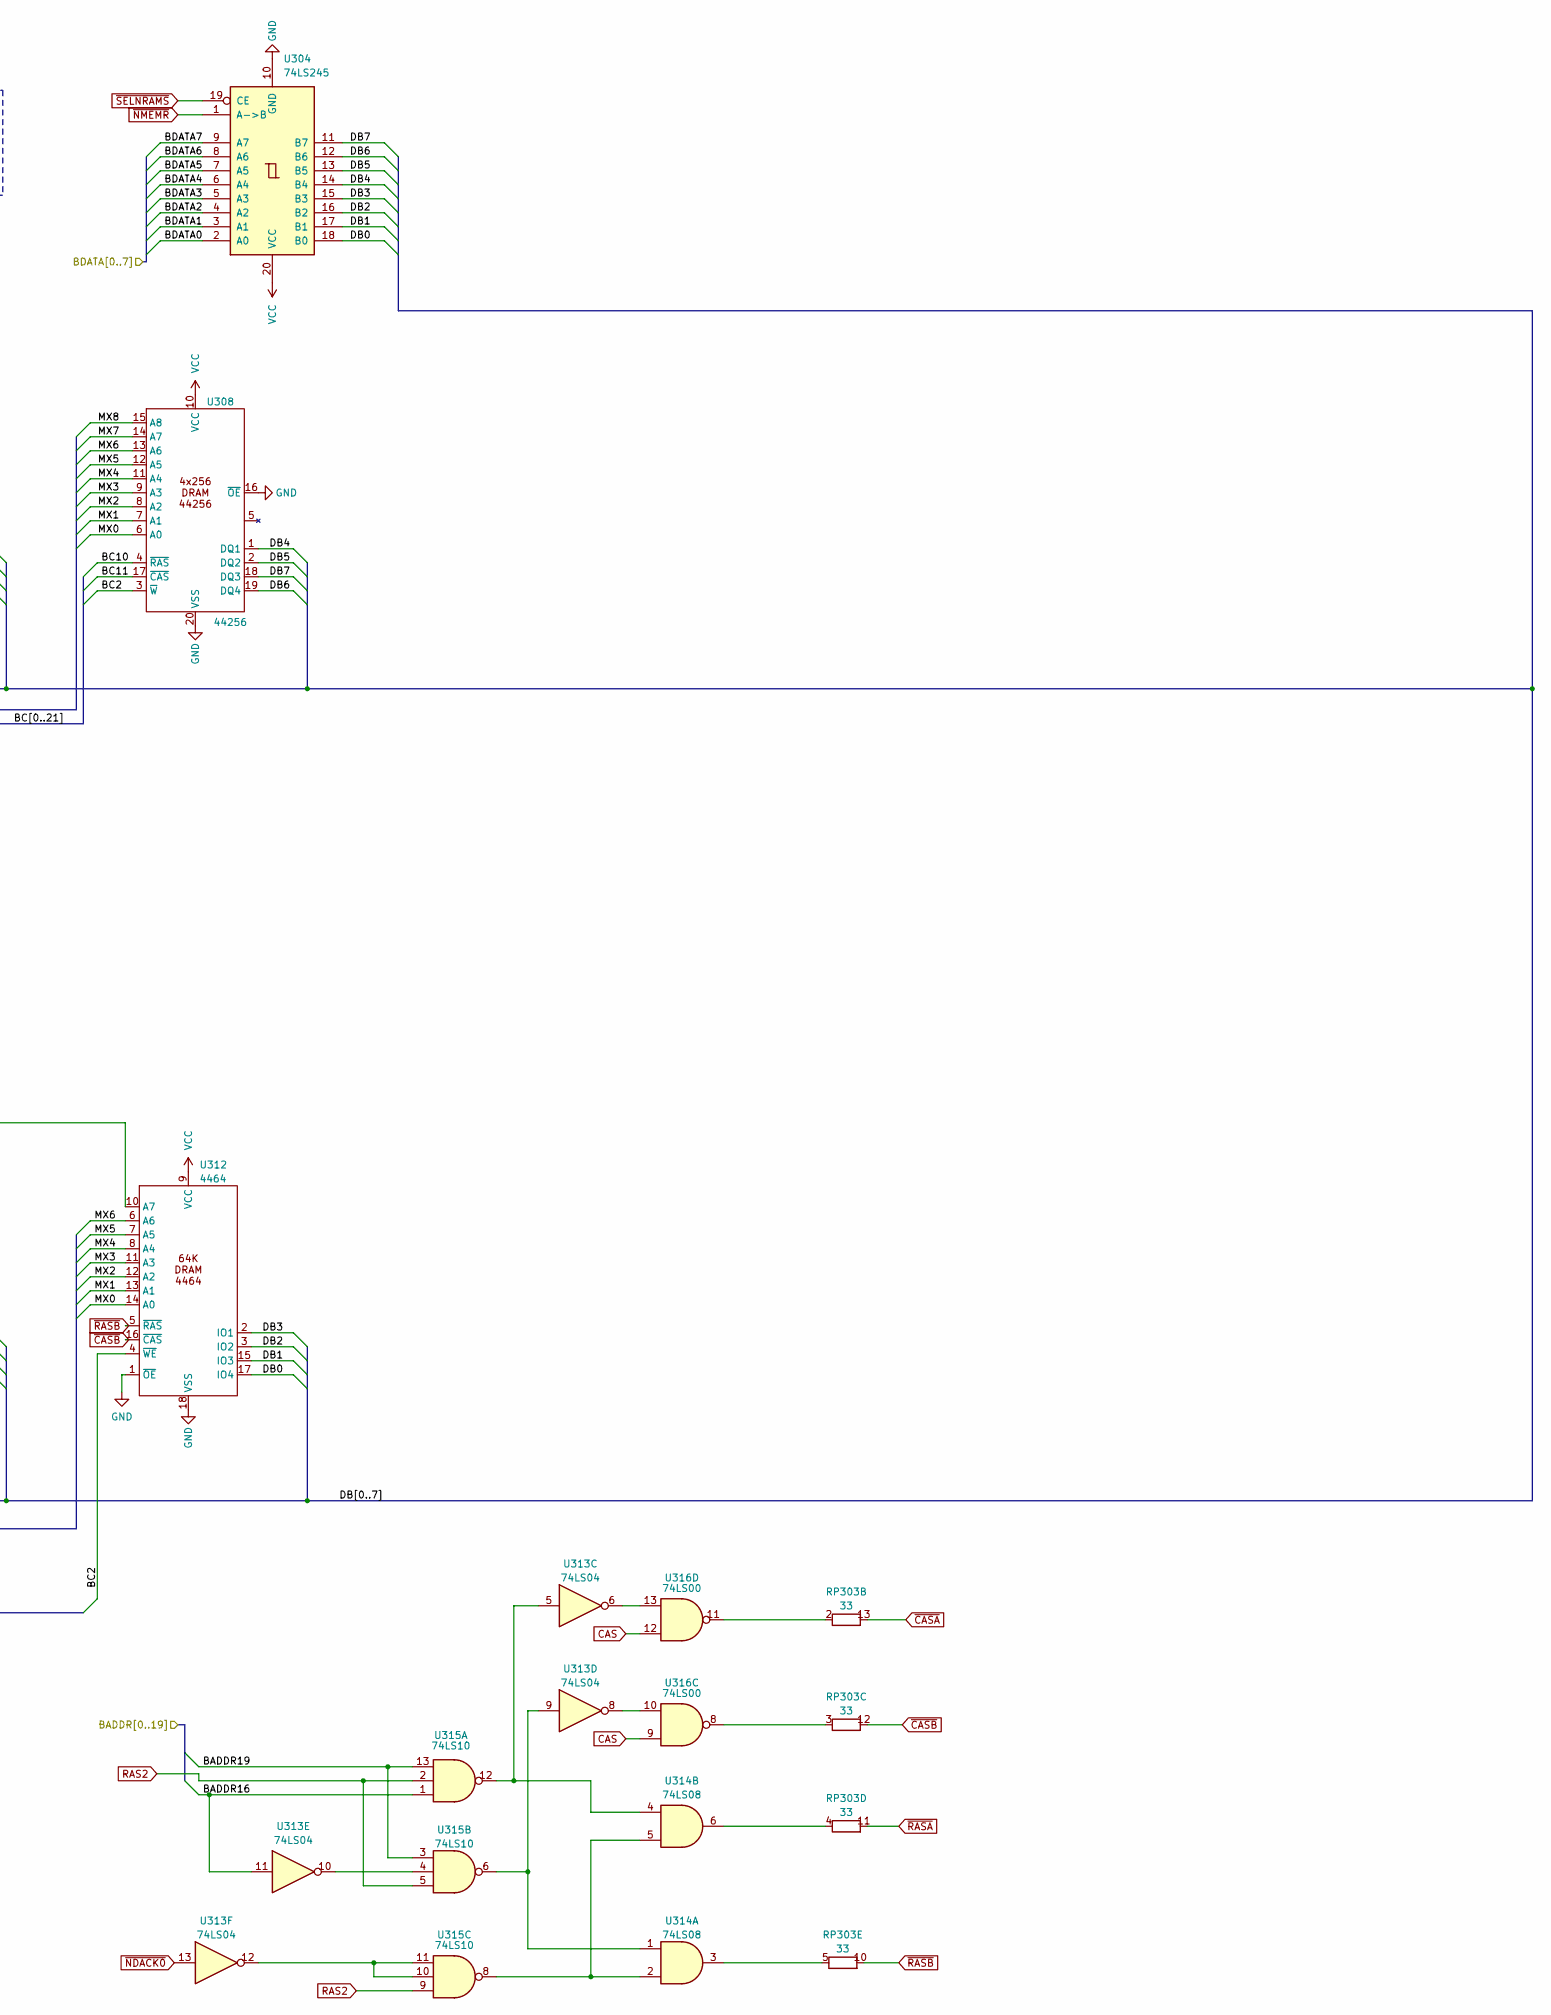
[picture p43: schematic RAM.kicad_sch, part in row 1, column 2]

Parts:
JMP301: PinHeader_1x03_P2.54mm-RoundPads
R301: 4.7K; R_Axial_P10.16mm_Hor
RP301, RP302, RP303: 33; DIP-14_W7.62mm
U301, U302, U303: 74LS158; DIP-16_W7.62mm
U304: 74LS245; DIP-20_W7.62mm
U305, U306, U307, U308: 44256; DIP-20_W7.62mm
U309, U310, U311, U312: 4464; DIP-18_W7.62mm
U313: 74LS04; DIP-14_W7.62mm
U314: 74LS08; DIP-14_W7.62mm
U315: 74LS10; DIP-14_W7.62mm
U316: 74LS00; DIP-14_W7.62mm

Connections:
BADDR0: U301.2 (I0a)
BADDR1: U301.5 (I0b)
BADDR2: U301.11 (I0d)
BADDR3: U301.14 (I0c)
BADDR4: U302.2 (I0a)
BADDR5: U302.5 (I0b)
BADDR6: U302.11 (I0d)
BADDR7: U302.14 (I0c), U303.5 (I0b)
BADDR8: U303.2 (I0a), U303.6 (I1b)
BADDR9: U301.3 (I1a)
BADDR10: U301.6 (I1b)
BADDR11: U301.10 (I1d)
BADDR12: U301.13 (I1c)
BADDR13: U302.3 (I1a)
BADDR14: U302.6 (I1b)
BADDR15: U302.10 (I1d)
BADDR16: U302.13 (I1c), U313.11, U315.1
BADDR17: U303.3 (I1a)
BADDR19: U315.3, U315.13
BC0: RP302.11 (R4.2), U305.4 (~RAS), U306.4 (~RAS)
BC1: RP302.10 (R5.2), U305.17 (~CAS), U306.17 (~CAS)
BC2: RP302.9 (R6.2), U305.3 (~W), U306.3 (~W), U307.3 (~W), U308.3 (~W), U309.4 (~WE), U310.4 (~WE), U311.4 (~WE), U312.4 (~WE)
BC10: RP302.8 (R7.2), U307.4 (~RAS), U308.4 (~RAS)
BC11: RP303.14 (R1.2), U307.17 (~CAS), U308.17 (~CAS)
BDATA0: U304.2 (A0)
BDATA1: U304.3 (A1)
BDATA2: U304.4 (A2)
BDATA3: U304.5 (A3)
BDATA4: U304.6 (A4)
BDATA5: U304.7 (A5)
BDATA6: U304.8 (A6)
BDATA7: U304.9 (A7)
CAS: U316.2, U316.5, U316.9, U316.12
DB0: U304.18 (B0), U305.1 (DQ1), U307.1 (DQ1), U310.17 (IO4), U312.17 (IO4)
DB1: U304.17 (B1), U305.2 (DQ2), U307.2 (DQ2), U310.15 (IO3), U312.15 (IO3)
DB2: U304.16 (B2), U305.19 (DQ4), U307.19 (DQ4), U310.3 (IO2), U312.3 (IO2)
DB3: U304.15 (B3), U305.18 (DQ3), U307.18 (DQ3), U310.2 (IO1), U312.2 (IO1)
DB4: U304.14 (B4), U306.1 (DQ1), U308.1 (DQ1), U309.17 (IO4), U311.17 (IO4)
DB5: U304.13 (B5), U306.2 (DQ2), U308.2 (DQ2), U309.15 (IO3), U311.15 (IO3)
DB6: U304.12 (B6), U306.19 (DQ4), U308.19 (DQ4), U309.3 (IO2), U311.3 (IO2)
DB7: U304.11 (B7), U306.18 (DQ3), U308.18 (DQ3), U309.2 (IO1), U311.2 (IO1)
GND: U301.8 (GND), U301.15 (E), U302.8 (GND), U302.15 (E), U303.8 (GND), U303.10 (I1d), U303.11 (I0d), U303.13 (I1c), U303.14 (I0c), U303.15 (E), U304.10 (GND), U305.16 (~OE), U305.20 (VSS), U306.16 (~OE), U306.20 (VSS), U307.16 (~OE), U307.20 (VSS), U308.16 (~OE), U308.20 (VSS), U309.1 (~OE), U309.18 (VSS), U310.1 (~OE), U310.18 (VSS), U311.1 (~OE), U311.18 (VSS), U312.1 (~OE), U312.18 (VSS)
MX0: RP301.14 (R1.2), U305.6 (A0), U306.6 (A0), U307.6 (A0), U308.6 (A0), U309.14 (A0), U310.14 (A0), U311.14 (A0), U312.14 (A0)
MX1: RP301.13 (R2.2), U305.7 (A1), U306.7 (A1), U307.7 (A1), U308.7 (A1), U309.13 (A1), U310.13 (A1), U311.13 (A1), U312.13 (A1)
MX2: RP301.12 (R3.2), U305.8 (A2), U306.8 (A2), U307.8 (A2), U308.8 (A2), U309.12 (A2), U310.12 (A2), U311.12 (A2), U312.12 (A2)
MX3: RP301.11 (R4.2), U305.9 (A3), U306.9 (A3), U307.9 (A3), U308.9 (A3), U309.11 (A3), U310.11 (A3), U311.11 (A3), U312.11 (A3)
MX4: RP301.10 (R5.2), U305.11 (A4), U306.11 (A4), U307.11 (A4), U308.11 (A4), U309.8 (A4), U310.8 (A4), U311.8 (A4), U312.8 (A4)
MX5: RP301.9 (R6.2), U305.12 (A5), U306.12 (A5), U307.12 (A5), U308.12 (A5), U309.7 (A5), U310.7 (A5), U311.7 (A5), U312.7 (A5)
MX6: RP301.8 (R7.2), U305.13 (A6), U306.13 (A6), U307.13 (A6), U308.13 (A6), U309.6 (A6), U310.6 (A6), U311.6 (A6), U312.6 (A6)
MX7: RP302.14 (R1.2), U305.14 (A7), U306.14 (A7), U307.14 (A7), U308.14 (A7)
MX8: RP302.13 (R2.2), U305.15 (A8), U306.15 (A8), U307.15 (A8), U308.15 (A8)
unnamed: JMP301.1, R301.2
unnamed: RP301.1 (R1.1), U301.4 (Za)
unnamed: RP301.2 (R2.1), U301.7 (Zb)
unnamed: RP301.3 (R3.1), U301.9 (Zd)
unnamed: RP301.4 (R4.1), U301.12 (Zc)
unnamed: RP301.5 (R5.1), U302.4 (Za)
unnamed: RP301.6 (R6.1), U302.7 (Zb)
unnamed: RP301.7 (R7.1), U302.9 (Zd)
unnamed: RP302.1 (R1.1), U302.12 (Zc)
unnamed: RP302.2 (R2.1), U303.4 (Za)
unnamed: RP302.3 (R3.1), U303.7 (Zb)
unnamed: RP302.4 (R4.1), U313.2
unnamed: RP302.5 (R5.1), U316.3
unnamed: RP302.7 (R7.1), U313.4
unnamed: RP302.12 (R3.2), U309.10 (A7), U310.10 (A7), U311.10 (A7), U312.10 (A7)
unnamed: RP303.1 (R1.1), U316.6
unnamed: RP303.2 (R2.1), U316.11
unnamed: RP303.3 (R3.1), U316.8
unnamed: RP303.4 (R4.1), U314.6
unnamed: RP303.5 (R5.1), U314.3
unnamed: U313.5, U314.4, U315.12
unnamed: U313.6, U316.13
unnamed: U313.8, U316.10
unnamed: U313.9, U314.1, U315.6
unnamed: U313.10, U315.4
unnamed: U313.12, U315.10, U315.11
unnamed: U314.2, U314.5, U315.8
RAS0: U313.1, U316.1
RAS1: U313.3, U316.4
RAS2: U315.2, U315.5, U315.9
SLAD: U301.1 (S), U302.1 (S), U303.1 (S)
VCC: R301.1, U301.16 (VCC), U302.16 (VCC), U303.16 (VCC), U304.20 (VCC), U305.10 (VCC), U306.10 (VCC), U307.10 (VCC), U308.10 (VCC), U309.9 (VCC), U310.9 (VCC), U311.9 (VCC), U312.9 (VCC)
~BNMEMW: RP302.6 (R6.1)
~CASA: RP303.13 (R2.2), U309.16 (~CAS), U310.16 (~CAS)
~CASB: RP303.12 (R3.2), U311.16 (~CAS), U312.16 (~CAS)
~NDACK0: U313.13
~NMEMR: U304.1 (A->B)
~NRAMS: JMP301.3
~RASA: RP303.11 (R4.2), U309.5 (~RAS), U310.5 (~RAS)
~RASB: RP303.10 (R5.2), U311.5 (~RAS), U312.5 (~RAS)
~SELNRAMS: JMP301.2, U304.19 (CE)

Notes on the sheet:
Rev6c
