Board-Folk/Commodore-PC10-III-Reproduction/312628-REV-6C/sheets/REV6_HOLDING.kicad_sch

## KiCad design 312628-REV-6C/sheets/REV6_HOLDING.kicad_sch (2025-01-08)

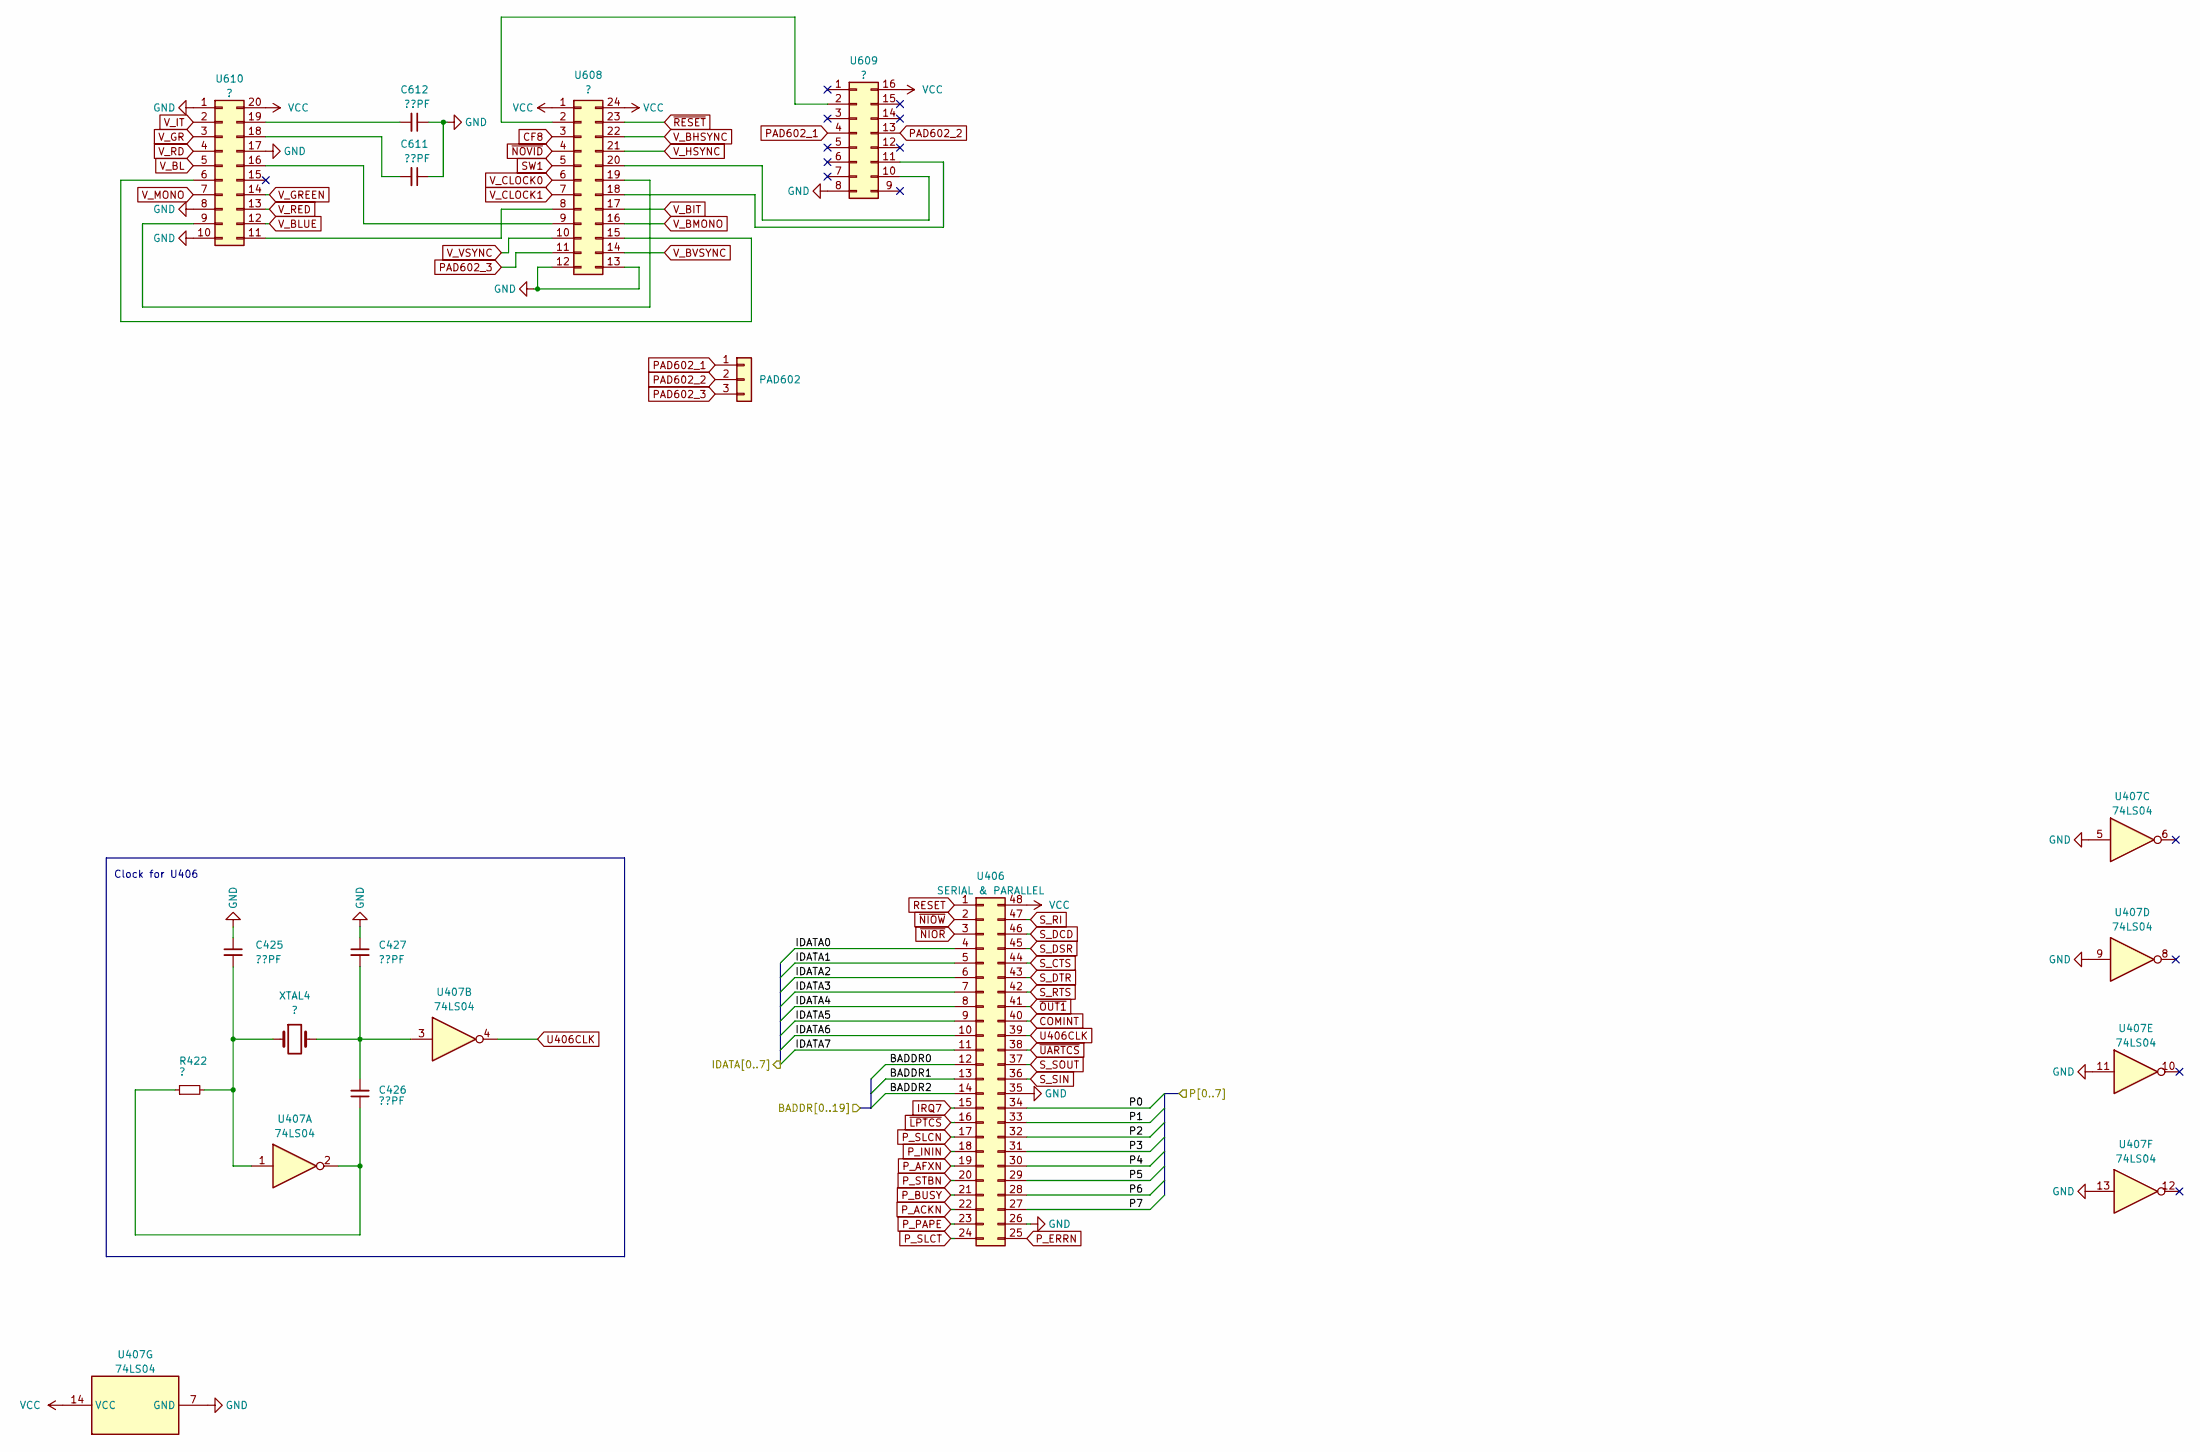
[picture p44: schematic REV6_HOLDING.kicad_sch]

Parts:
C425, C426, C427, C611, C612: ??PF; C_Axial_P10.00mm
PAD602: PAD (1-2 Connected)
R422: ?; R_Axial_P10.16mm_Hor
U406: SERIAL & PARALLEL; DIP-48_W15.24mm
U407: 74LS04; DIP-14_W7.62mm
U608: ?; DIP-24_W7.62mm
U609: ?; DIP-16_W7.62mm
U610: ?; DIP-20_W7.62mm
XTAL4: ?; XTAL3

Connections:
BADDR0: U406.12
BADDR1: U406.13
BADDR2: U406.14
CF8: U608.3
COMINT: U406.40
GND: C425.1, C427.1, C611.1, C612.1, U406.26, U406.35, U407.5, U407.7 (GND), U407.9, U407.11, U407.13, U608.12, U608.13, U609.8, U610.1, U610.8, U610.10, U610.17
IDATA0: U406.4
IDATA1: U406.5
IDATA2: U406.6
IDATA3: U406.7
IDATA4: U406.8
IDATA5: U406.9
IDATA6: U406.10
IDATA7: U406.11
IRQ7: U406.15
unnamed: C425.2, R422.2, U407.1, XTAL4.1
unnamed: C426.1, R422.1, U407.2
unnamed: C426.2, C427.2, U407.3, XTAL4.2
unnamed: C611.2, U610.18
unnamed: C612.2, U610.19
unnamed: U608.2, U609.2
unnamed: U608.8, U610.11
unnamed: U608.9, U610.16
unnamed: U608.15, U610.6
unnamed: U608.18, U609.11
unnamed: U608.19, U610.9
unnamed: U608.20, U609.10
P0: U406.34
P1: U406.33
P2: U406.32
P3: U406.31
P4: U406.30
P5: U406.29
P6: U406.28
P7: U406.27
PAD602_1: PAD602.1, U609.4
PAD602_2: PAD602.2, U609.13
PAD602_3: PAD602.3, U608.11
P_ACKN: U406.22
P_AFXN: U406.19
P_BUSY: U406.21
P_ERRN: U406.25
P_ININ: U406.18
P_PAPE: U406.23
P_SLCN: U406.17
P_SLCT: U406.24
P_STBN: U406.20
RESET: U406.1
SW1: U608.5
S_CTS: U406.44
S_DCD: U406.46
S_DSR: U406.45
S_DTR: U406.43
S_RI: U406.47
S_RTS: U406.42
S_SIN: U406.36
S_SOUT: U406.37
U406CLK: U406.39, U407.4
VCC: U406.48, U407.14 (VCC), U608.1, U608.24, U609.16, U610.20
V_BHSYNC: U608.22
V_BIT: U608.17
V_BL: U610.5
V_BLUE: U610.12
V_BMONO: U608.16
V_BVSYNC: U608.14
V_CLOCK0: U608.6
V_CLOCK1: U608.7
V_GR: U610.3
V_GREEN: U610.14
V_HSYNC: U608.21
V_IT: U610.2
V_MONO: U610.7
V_RD: U610.4
V_RED: U610.13
V_VSYNC: U608.10
~LPTCS: U406.16
~NIOR: U406.3
~NIOW: U406.2
~NOVID: U608.4
~OUT1: U406.41
~RESET: U608.23
~UARTCS: U406.38

Notes on the sheet:
Clock for U406
