Board-Folk/Commodore-PC10-III-Reproduction/312628-REV-6C/sheets/VIDEO.kicad_sch

## KiCad design 312628-REV-6C/sheets/VIDEO.kicad_sch (2025-01-08)

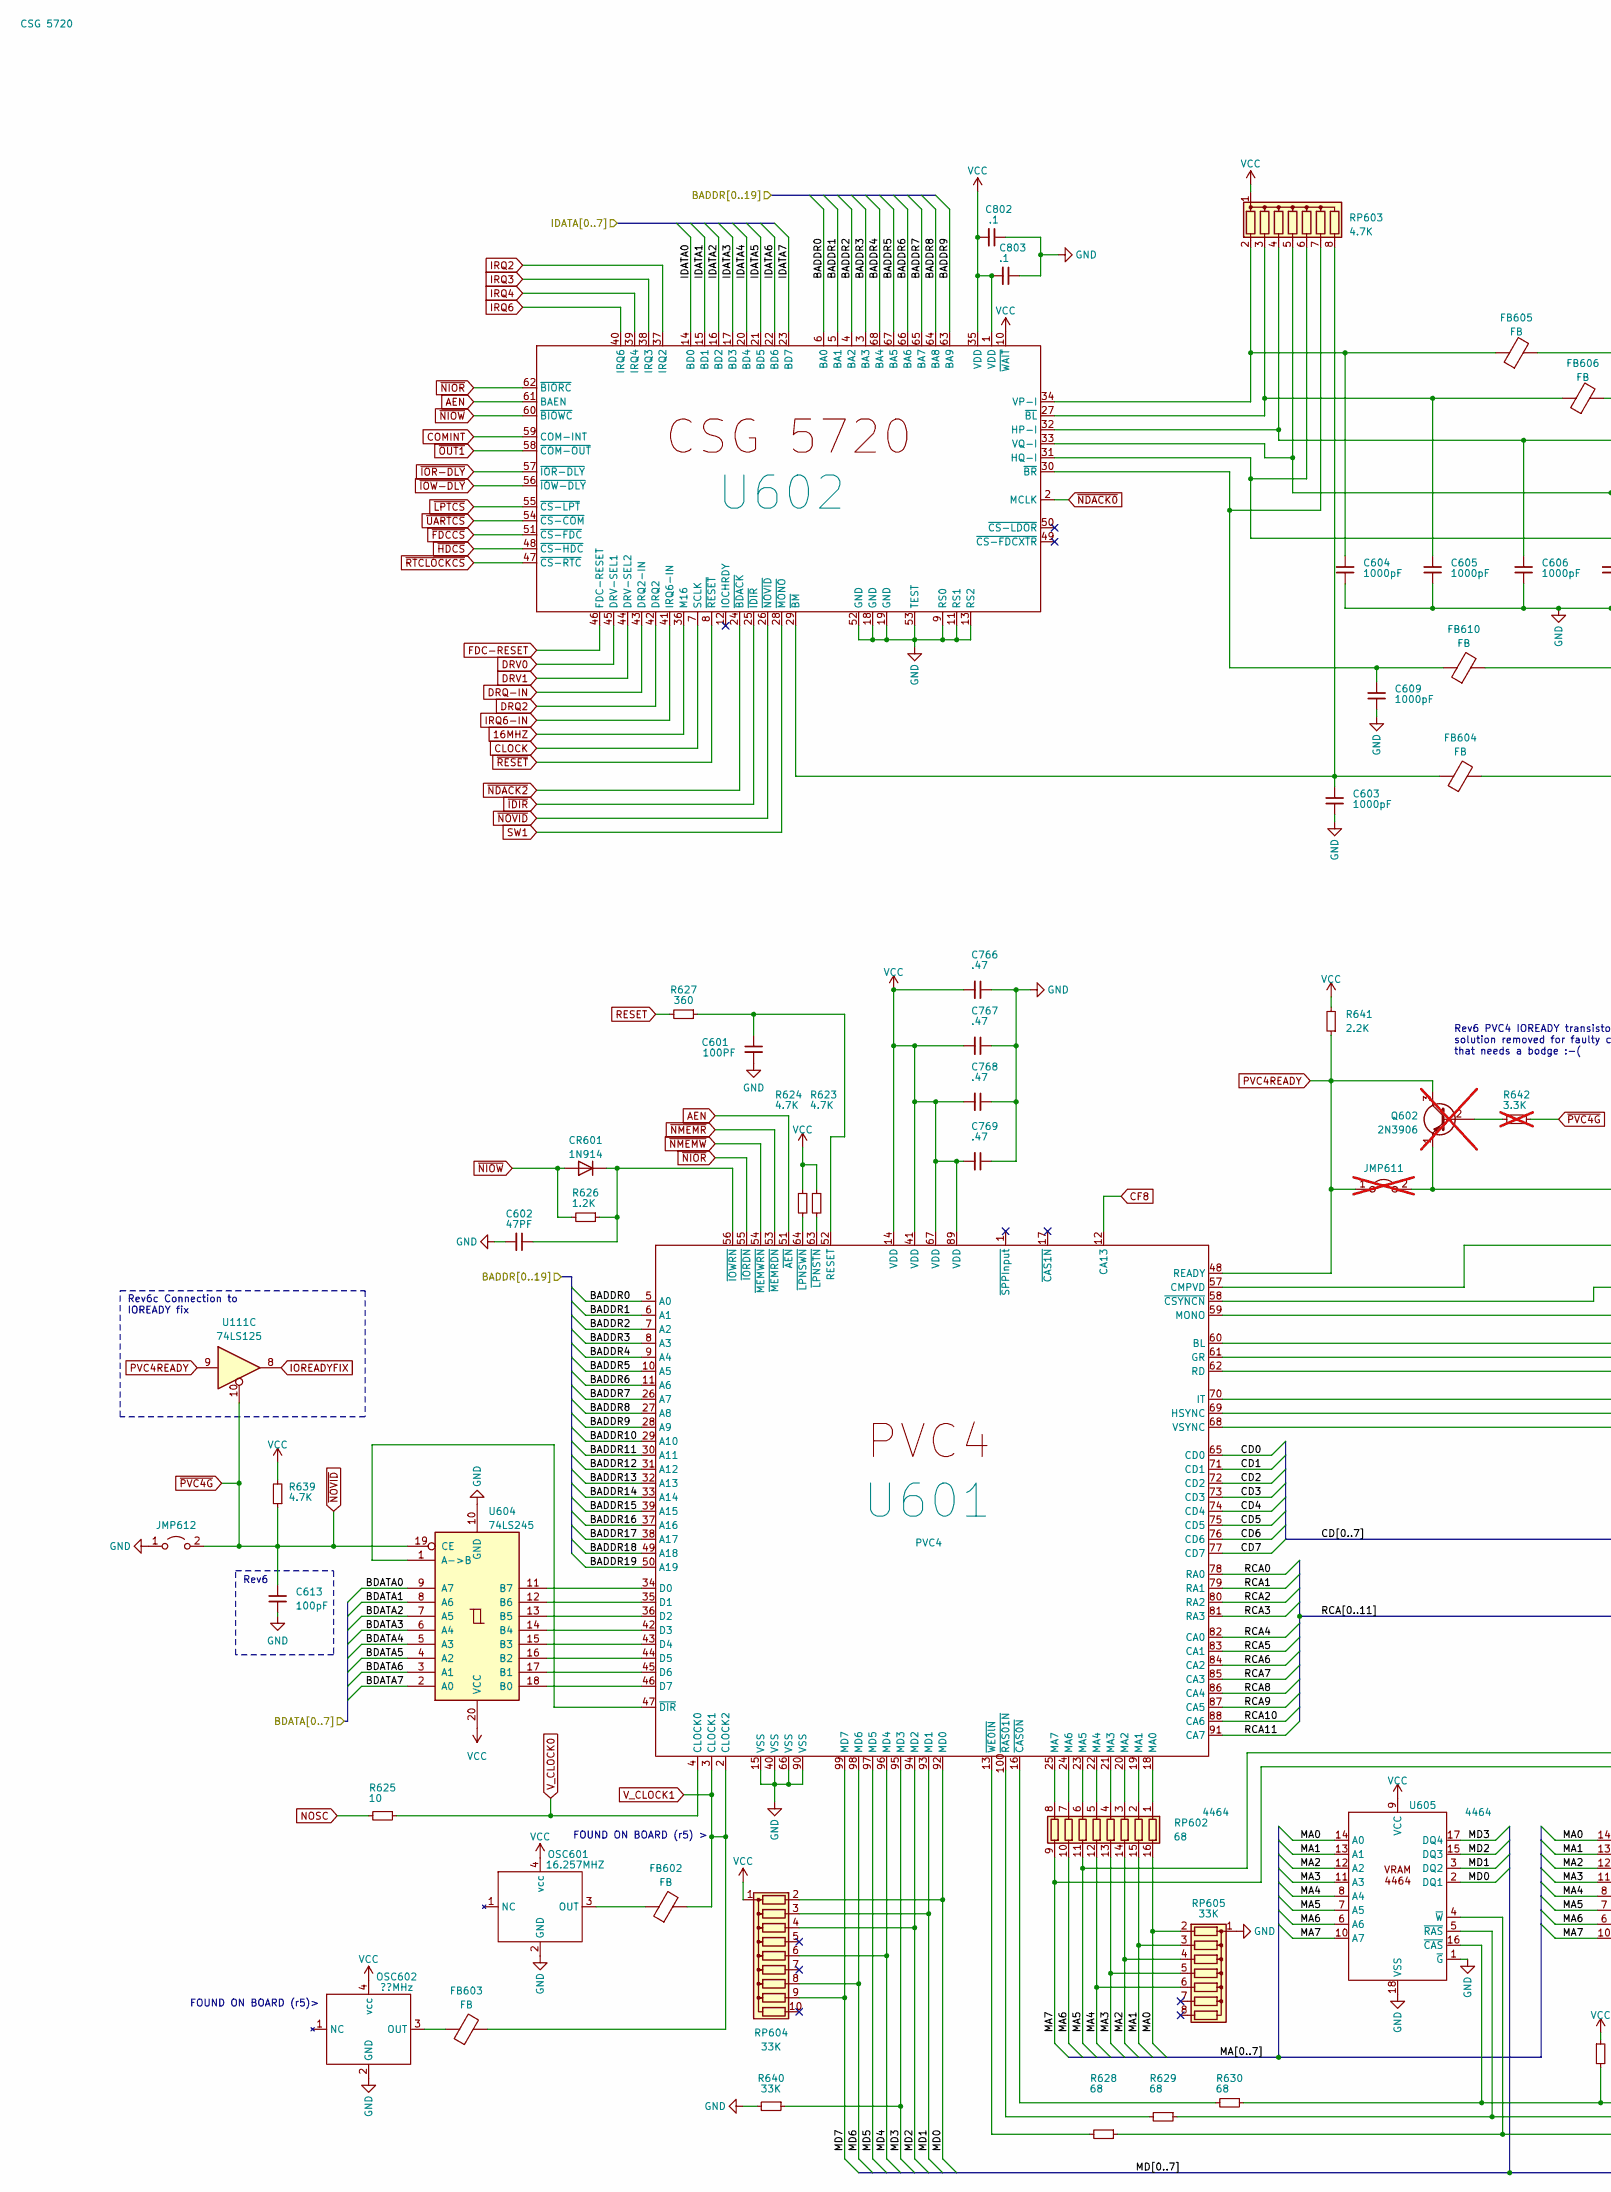
[picture p45: schematic VIDEO.kicad_sch, part in row 1, column 1]

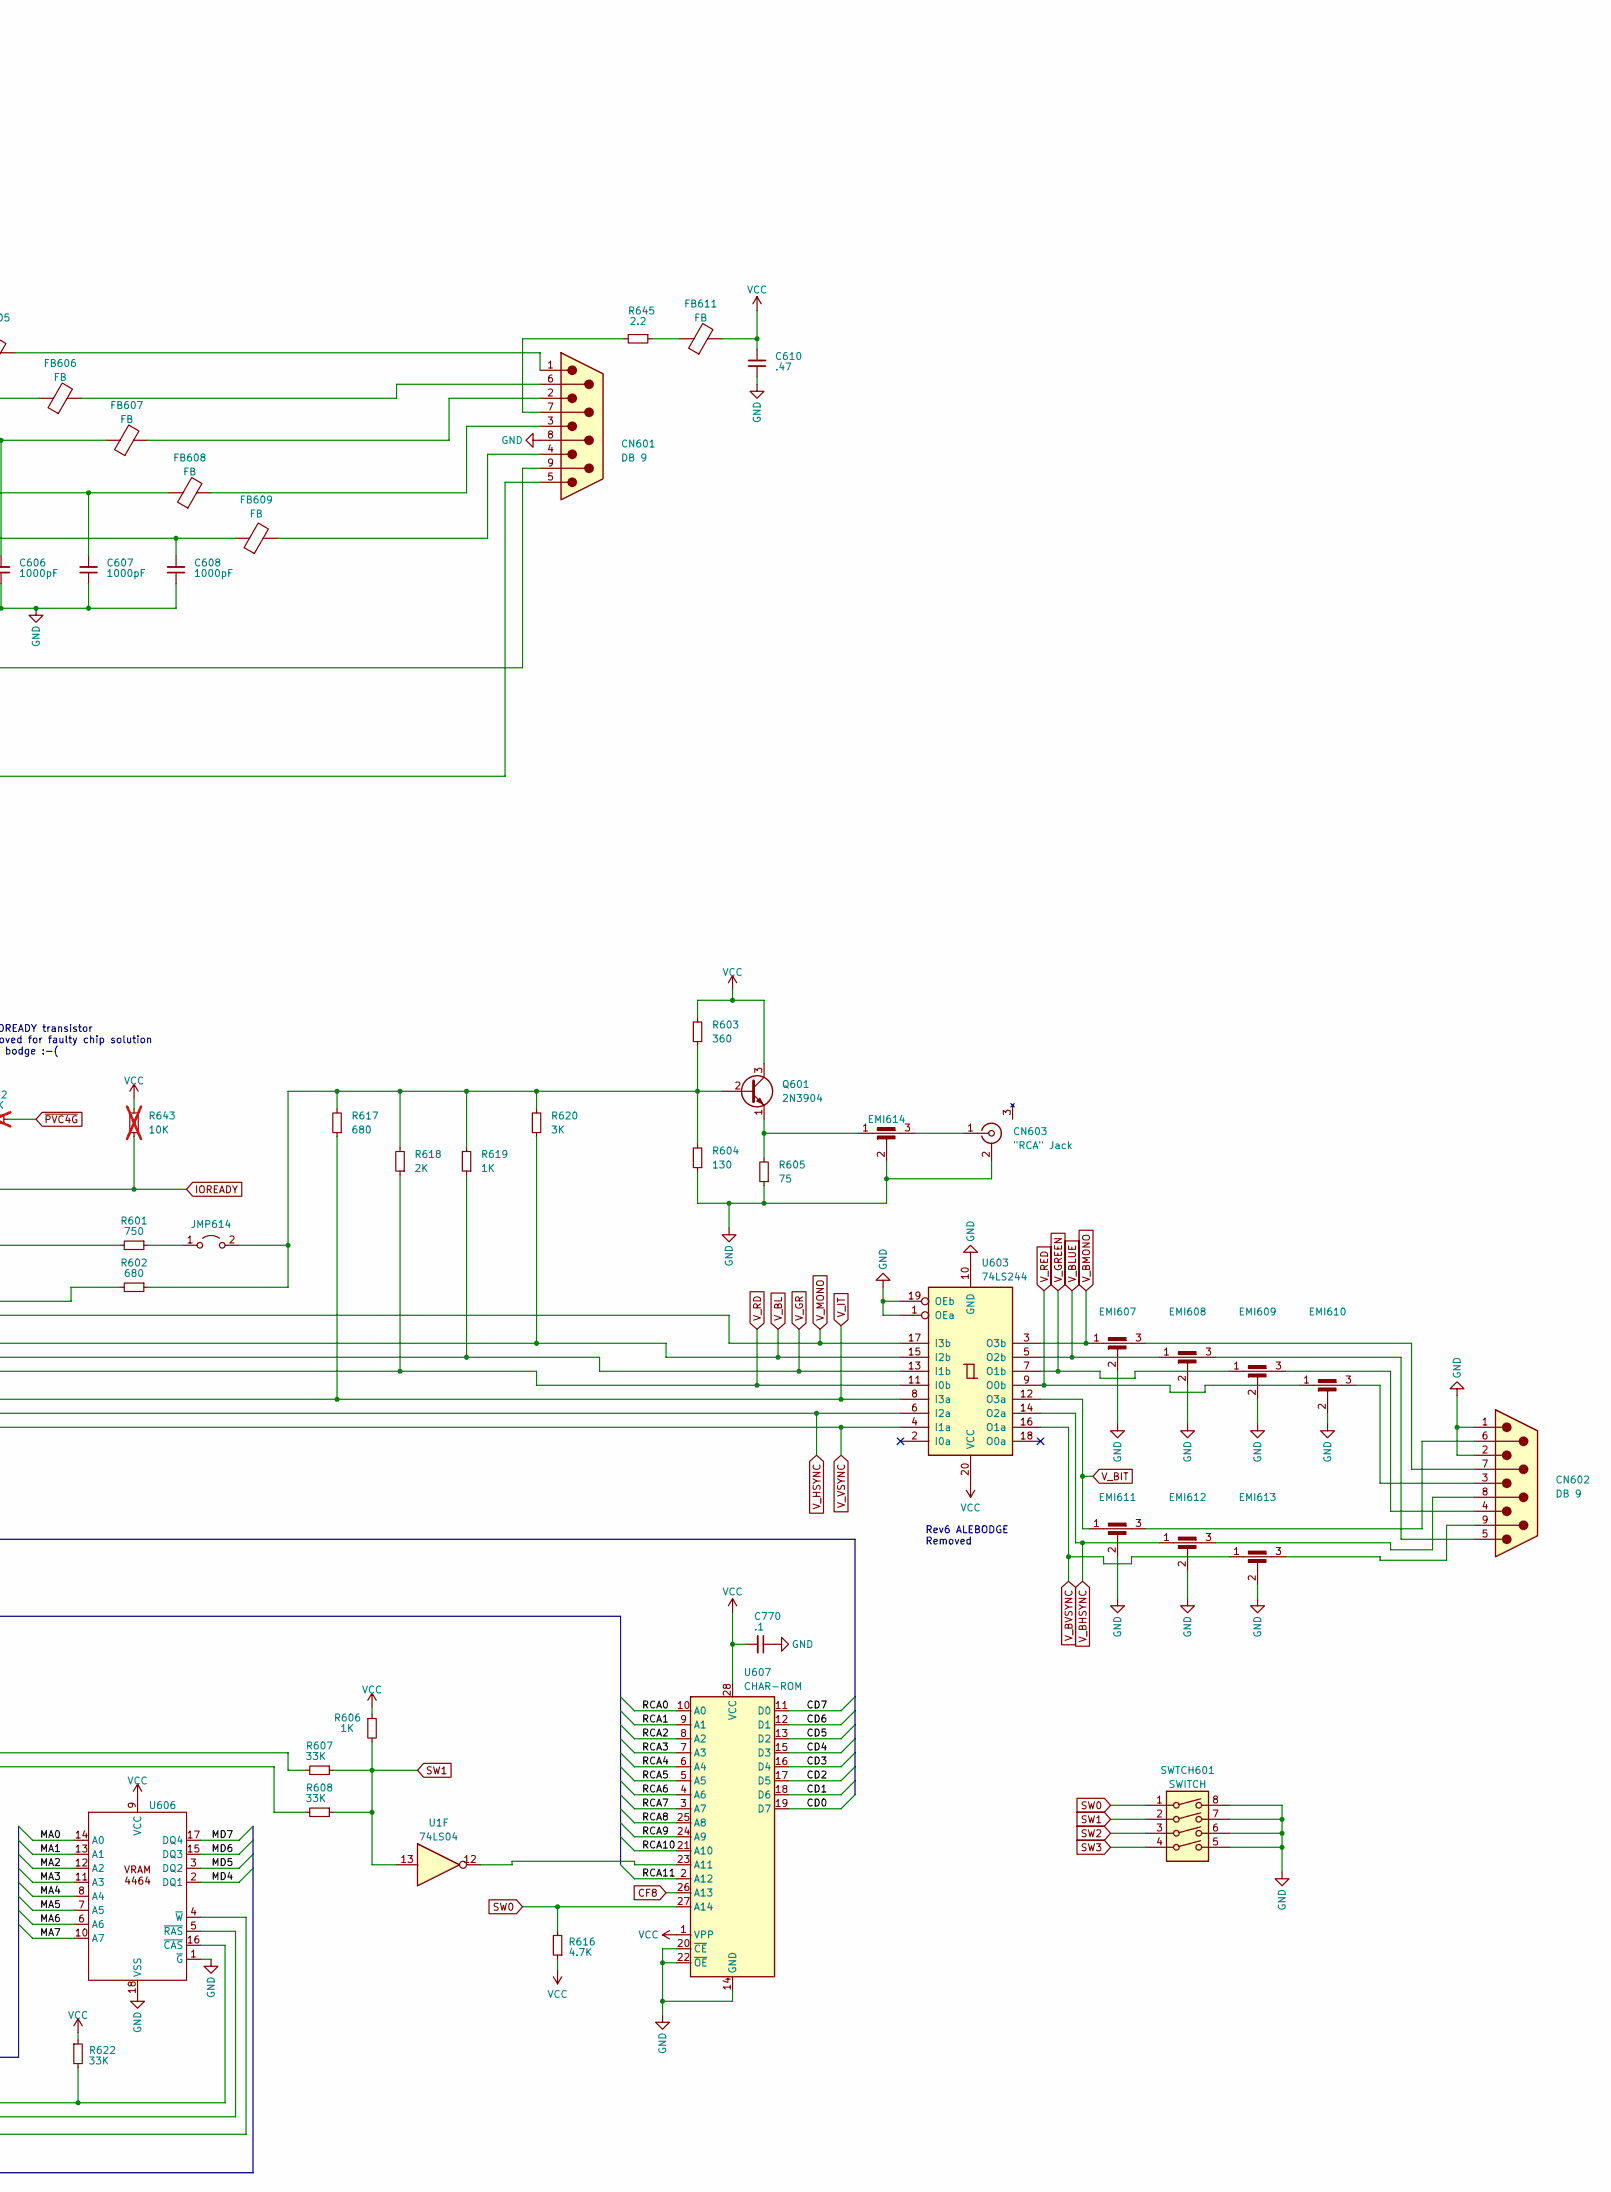
[picture p46: schematic VIDEO.kicad_sch, part in row 1, column 2]

Parts:
C601: 100PF; C_Axial_P10.00mm
C602: 47PF; C_P10.16mm
C603, C604, C605, C606, C607, C608: 1000pF; C_Axial_P10.00mm
C609: 1000pF; C_P10.16mm
C610, C766, C767, C768, C769: .47; C_P10.16mm
C613: 100pF; C_P10.16mm
C770, C802, C803: .1; C_P10.16mm
CN601: DB 9; CN601
CN602: DB 9; CN602
CN603: "RCA" Jack; CN603
CR601: 1N914; Diode_Axial_P10.00mm
EMI607, EMI610, EMI611, EMI612, EMI613: 100pF (101); EMI2
EMI608, EMI609, EMI614: 100pF (101); EMI2 - Extra GND
FB602, FB604, FB605, FB606, FB607, FB608, FB609, FB610, FB611: FB; R_Axial_P10.00mm
FB603: FB; R_Axial_P10.16mm_Hor
JMP611: Jumper_2_Open; PinHeader_1x02_P2.54mm; not fitted
JMP612, JMP614: Jumper_2_Open; PinHeader_1x02_P2.54mm
OSC601: 16.257MHZ; Oscillator_OSC601
OSC602: ??MHz; Oscillator_OSC601
Q601: 2N3904; TO-92_Transistor
Q602: 2N3906; Q602_Transistor; not fitted
R601: 750; R_Axial_P10.00mm
R602, R617: 680; R_Axial_P10.00mm
R603: 360; R_Axial_P10.00mm
R604: 130; R_Axial_P10.00mm
R605: 75; R_Axial_P10.00mm
R606, R619: 1K; R_Axial_P10.00mm
R607, R608, R622, R640: 33K; R_Axial_P10.00mm
R616, R623, R624, R639: 4.7K; R_Axial_P10.00mm
R618: 2K; R_Axial_P10.00mm
R620: 3K; R_Axial_P10.00mm
R625: 10; R_Axial_P10.00mm
R626: 1.2K; R_Axial_P10.00mm
R627: 360; R_Axial_P10.16mm_Hor
R628, R629, R630: 68; R_Axial_P10.00mm
R641: 2.2K; R_Axial_P10.00mm
R642: 3.3K; R_Axial_P10.16mm_Hor; not fitted
R643: 10K; R_Axial_P10.16mm_Hor; not fitted
R645: 2.2; R_Axial_P12.70mm
RP602: 68; DIP-16_W7.62mm
RP603: 4.7K; R_Array_SIP8
RP604: 33K; R_Array_SIP10
RP605: 33K; R_Array_SIP8
SWTCH601: SWITCH; SWTCH601
U1: 74LS04; DIP-14_W7.62mm
U111: 74LS125; DIP-14_W7.62mm
U601: PVC4; U601
U602: CSG 5720; PLCC-68_U602
U603: 74LS244; DIP-20_W7.62mm
U604: 74LS245; DIP-20_W7.62mm
U605, U606: 4464; DIP-18_W7.62mm
U607: CHAR-ROM; DIP-28_W15.24mm

Connections:
16MHZ: U602.36 (M16)
AEN: U601.51 (~AEN), U602.61 (BAEN)
BADDR0: U601.5 (A0), U602.6 (BA0)
BADDR1: U601.6 (A1), U602.5 (BA1)
BADDR2: U601.7 (A2), U602.4 (BA2)
BADDR3: U601.8 (A3), U602.3 (BA3)
BADDR4: U601.9 (A4), U602.68 (BA4)
BADDR5: U601.10 (A5), U602.67 (BA5)
BADDR6: U601.11 (A6), U602.66 (BA6)
BADDR7: U601.26 (A7), U602.65 (BA7)
BADDR8: U601.27 (A8), U602.64 (BA8)
BADDR9: U601.28 (A9), U602.63 (BA9)
BADDR10: U601.29 (A10)
BADDR11: U601.30 (A11)
BADDR12: U601.31 (A12)
BADDR13: U601.32 (A13)
BADDR14: U601.33 (A14)
BADDR15: U601.39 (A15)
BADDR16: U601.37 (A16)
BADDR17: U601.38 (A17)
BADDR18: U601.49 (A18)
BADDR19: U601.50 (A19)
BDATA0: U604.9 (A7)
BDATA1: U604.8 (A6)
BDATA2: U604.7 (A5)
BDATA3: U604.6 (A4)
BDATA4: U604.5 (A3)
BDATA5: U604.4 (A2)
BDATA6: U604.3 (A1)
BDATA7: U604.2 (A0)
CD0: U601.65 (CD0), U607.19 (D7)
CD1: U601.71 (CD1), U607.18 (D6)
CD2: U601.72 (CD2), U607.17 (D5)
CD3: U601.73 (CD3), U607.16 (D4)
CD4: U601.74 (CD4), U607.15 (D3)
CD5: U601.75 (CD5), U607.13 (D2)
CD6: U601.76 (CD6), U607.12 (D1)
CD7: U601.77 (CD7), U607.11 (D0)
CF8: U601.12 (CA13), U607.26 (A13)
CLOCK: U602.7 (SCLK)
COMINT: U602.59 (COM-INT)
DRQ2: U602.42 (DRQ2)
DRQ-IN: U602.43 (DRQ2-IN)
DRV0: U602.45 (DRV-SEL1)
DRV1: U602.44 (DRV-SEL2)
FDC-RESET: U602.46 (FDC-RESET)
GND: C601.2, C602.2, C603.1, C604.1, C605.1, C606.1, C607.1, C608.1, C609.1, C610.1, C613.1, C766.1, C767.1, C768.1, C769.1, C770.1, C802.1, C803.1, CN601.8, CN602.1, CN602.2, CN603.2 (Ext), EMI607.2, EMI608.2, EMI609.2, EMI610.2, EMI611.2, EMI612.2, EMI613.2, EMI614.2, JMP612.1 (A), OSC601.2 (GND), OSC602.2 (GND), R604.1, R605.1, R640.2, RP605.1 (common), SWTCH601.5, SWTCH601.6, SWTCH601.7, SWTCH601.8, U601.15 (VSS), U601.40 (VSS), U601.66 (VSS), U601.90 (VSS), U602.9 (RS0), U602.11 (RS1), U602.13 (RS2), U602.18 (GND), U602.19 (GND), U602.52 (GND), U602.53 (TEST), U603.1 (OEa), U603.10 (GND), U603.19 (OEb), U604.10 (GND), U605.1 (~G), U605.18 (VSS), U606.1 (~G), U606.18 (VSS), U607.14 (GND), U607.20 (~CE), U607.22 (~OE)
IDATA0: U602.14 (BD0)
IDATA1: U602.15 (BD1)
IDATA2: U602.16 (BD2)
IDATA3: U602.17 (BD3)
IDATA4: U602.20 (BD4)
IDATA5: U602.21 (BD5)
IDATA6: U602.22 (BD6)
IDATA7: U602.23 (BD7)
IOREADY: JMP611.2 (B), Q602.1 (E), R643.1
IOREADYFIX: U111.8
IRQ2: U602.37 (IRQ2)
IRQ3: U602.38 (IRQ3)
IRQ4: U602.39 (IRQ4)
IRQ6: U602.40 (IRQ6)
IRQ6-IN: U602.41 (IRQ6-IN)
MA0: RP602.16 (R1.2), RP605.2 (R1), U605.14 (A0), U606.14 (A0)
MA1: RP602.15 (R2.2), RP605.3 (R2), U605.13 (A1), U606.13 (A1)
MA2: RP602.14 (R3.2), RP605.4 (R3), U605.12 (A2), U606.12 (A2)
MA3: RP602.13 (R4.2), RP605.5 (R4), U605.11 (A3), U606.11 (A3)
MA4: RP602.12 (R5.2), RP605.6 (R5), U605.8 (A4), U606.8 (A4)
MA5: R607.2, RP602.11 (R6.2), U605.7 (A5), U606.7 (A5)
MA6: RP602.10 (R7.2), U605.6 (A6), U606.6 (A6)
MA7: R608.2, RP602.9 (R8.2), U605.10 (A7), U606.10 (A7)
MD0: RP604.2 (R1), U601.92 (MD0), U605.2 (DQ1)
MD1: RP604.3 (R2), U601.93 (MD1), U605.3 (DQ2)
MD2: RP604.4 (R3), U601.94 (MD2), U605.15 (DQ3)
MD3: R640.1, U601.95 (MD3), U605.17 (DQ4)
MD4: RP604.6 (R5), U601.96 (MD4), U606.2 (DQ1)
MD5: U601.97 (MD5), U606.3 (DQ2)
MD6: RP604.8 (R7), U601.98 (MD6), U606.15 (DQ3)
MD7: RP604.9 (R8), U601.99 (MD7), U606.17 (DQ4)
NOSC: R625.2
unnamed: C601.1, R627.1, U601.52 (RESET)
unnamed: C602.1, CR601.1 (K), R626.1, U601.56 (~IOWRN)
unnamed: C603.2, FB604.1, RP603.8 (R7), U602.29 (~BM)
unnamed: C604.2, FB605.1, RP603.2 (R1), U602.34 (VP-I)
unnamed: C605.2, FB606.1, RP603.3 (R2), U602.27 (~BL)
unnamed: C606.2, FB607.1, RP603.4 (R3), U602.32 (HP-I)
unnamed: C607.2, FB608.1, RP603.5 (R4), U602.33 (VQ-I)
unnamed: C608.2, FB609.1, RP603.6 (R5), U602.31 (HQ-I)
unnamed: C609.2, FB610.1, RP603.7 (R6), U602.30 (~BR)
unnamed: CN601.1, FB605.2
unnamed: CN601.2, FB607.2
unnamed: CN601.3, FB608.2
unnamed: CN601.4, FB609.2
unnamed: CN601.5, FB604.2
unnamed: CN601.6, FB606.2
unnamed: CN601.7, R645.2
unnamed: CN601.9, FB610.2
unnamed: CN602.3, EMI610.3
unnamed: CN602.4, EMI609.3
unnamed: CN602.5, EMI608.3
unnamed: CN602.6, EMI611.3
unnamed: CN602.7, EMI607.3
unnamed: CN602.8, EMI612.3
unnamed: CN602.9, EMI613.3
unnamed: CN603.1 (In), EMI614.3
unnamed: EMI614.1, Q601.1 (E), R605.2
unnamed: FB602.1, OSC601.3 (OUT)
unnamed: FB603.1, OSC602.3 (OUT)
unnamed: FB611.1, R645.1
unnamed: JMP614.1 (A), R601.1
unnamed: JMP614.2 (B), Q601.2 (B), R602.1, R603.1, R604.2, R617.2, R618.2, R619.2, R620.2
unnamed: Q602.2 (B), R642.2
unnamed: R601.2, U601.57 (CMPVD)
unnamed: R602.2, U601.58 (~CSYNCN)
unnamed: R622.2, R630.1, U605.16 (~CAS), U606.16 (~CAS)
unnamed: R623.2, U601.63 (~LPNSTN)
unnamed: R624.2, U601.64 (~LPNSWN)
unnamed: R628.1, U605.4 (~W), U606.4 (~W)
unnamed: R628.2, U601.13 (~WE0lN)
unnamed: R629.1, U605.5 (~RAS), U606.5 (~RAS)
unnamed: R629.2, U601.100 (~RAS01N)
unnamed: R630.2, U601.16 (~CAS0N)
unnamed: RP602.1 (R1.1), U601.18 (MA0)
unnamed: RP602.2 (R2.1), U601.19 (MA1)
unnamed: RP602.3 (R3.1), U601.20 (MA2)
unnamed: RP602.4 (R4.1), U601.21 (MA3)
unnamed: RP602.5 (R5.1), U601.22 (MA4)
unnamed: RP602.6 (R6.1), U601.23 (MA5)
unnamed: RP602.7 (R7.1), U601.24 (MA6)
unnamed: RP602.8 (R8.1), U601.25 (MA7)
unnamed: U1.12, U607.23 (A11)
unnamed: U601.34 (D0), U604.11 (B7)
unnamed: U601.35 (D1), U604.12 (B6)
unnamed: U601.36 (D2), U604.13 (B5)
unnamed: U601.42 (D3), U604.14 (B4)
unnamed: U601.43 (D4), U604.15 (B3)
unnamed: U601.44 (D5), U604.16 (B2)
unnamed: U601.45 (D6), U604.17 (B1)
unnamed: U601.46 (D7), U604.18 (B0)
unnamed: U601.47 (~DIR), U604.1 (A->B)
PVC4READY: JMP611.1 (A), Q602.3 (C), R641.1, U111.9, U601.48 (READY)
RCA0: U601.78 (RA0), U607.10 (A0)
RCA1: U601.79 (RA1), U607.9 (A1)
RCA2: U601.80 (RA2), U607.8 (A2)
RCA3: U601.81 (RA3), U607.7 (A3)
RCA4: U601.82 (CA0), U607.6 (A4)
RCA5: U601.83 (CA1), U607.5 (A5)
RCA6: U601.84 (CA2), U607.4 (A6)
RCA7: U601.85 (CA3), U607.3 (A7)
RCA8: U601.86 (CA4), U607.25 (A8)
RCA9: U601.87 (CA5), U607.24 (A9)
RCA10: U601.88 (CA6), U607.21 (A10)
RCA11: U601.91 (CA7), U607.2 (A12)
RESET: R627.2
SW0: R616.2, SWTCH601.1, U607.27 (A14)
SW1: R606.2, R607.1, R608.1, SWTCH601.2, U1.13, U602.28 (~MONO)
SW2: SWTCH601.3
SW3: SWTCH601.4
VCC: C610.2, C766.2, C767.2, C768.2, C769.2, C770.2, C802.2, C803.2, FB611.2, OSC601.4 (vcc), OSC602.4 (vcc), Q601.3 (C), R603.2, R606.1, R616.1, R622.1, R623.1, R624.1, R639.2, R641.2, R643.2, RP603.1 (common), RP604.1 (common), U601.14 (VDD), U601.41 (VDD), U601.67 (VDD), U601.89 (VDD), U602.1 (VDD), U602.10 (~WAIT), U602.35 (VDD), U603.20 (VCC), U604.20 (VCC), U605.9 (VCC), U606.9 (VCC), U607.1 (VPP), U607.28 (VCC)
V_BHSYNC: EMI612.1, U603.14 (O2a)
V_BIT: EMI611.1, U603.12 (O3a)
V_BL: R620.1, U601.60 (BL), U603.15 (I2b)
V_BLUE: EMI608.1, U603.5 (O2b)
V_BMONO: EMI607.1, U603.3 (O3b)
V_BVSYNC: EMI613.1, U603.16 (O1a)
V_CLOCK0: R625.1, U601.4 (CLOCK0)
V_CLOCK1: FB602.2, FB603.2, U601.2 (CLOCK2), U601.3 (CLOCK1)
V_GR: R619.1, U601.61 (GR), U603.13 (I1b)
V_GREEN: EMI609.1, U603.7 (O1b)
V_HSYNC: U601.69 (HSYNC), U603.6 (I2a)
V_IT: R617.1, U601.70 (IT), U603.8 (I3a)
V_MONO: U601.59 (MONO), U603.17 (I3b)
V_RD: R618.1, U601.62 (RD), U603.11 (I0b)
V_RED: EMI610.1, U603.9 (O0b)
V_VSYNC: U601.68 (VSYNC), U603.4 (I1a)
~FDCCS: U602.51 (~CS-FDC)
~HDCS: U602.48 (~CS-HDC)
~IDIR: U602.25 (~IDIR)
~IOR-DLY: U602.57 (~IOR-DLY)
~IOW-DLY: U602.56 (~IOW-DLY)
~LPTCS: U602.55 (~CS-LPT)
~NDACK0: U602.2 (MCLK)
~NDACK2: U602.24 (~BDACK)
~NIOR: U601.55 (~IORDN), U602.62 (~BIORC)
~NIOW: CR601.2 (A), R626.2, U602.60 (~BIOWC)
~NMEMR: U601.53 (~MEMRDN)
~NMEMW: U601.54 (~MEMWRN)
~NOVID: C613.2, JMP612.2 (B), R639.1, R642.1, U111.10, U602.26 (~NOVID), U604.19 (CE)
~OUT1: U602.58 (~COM-OUT)
~RESET: U602.8 (~RESET)
~RTCLOCKCS: U602.47 (~CS-RTC)
~UARTCS: U602.54 (~CS-COM)

Notes on the sheet:
Rev6 ALEBODGE Removed
Rev6
FOUND ON BOARD (r5)>
Rev6c Connection to IOREADY fix
Rev6 PVC4 IOREADY transistor solution removed for faulty chip solution that needs a bodge :-(
FOUND ON BOARD (r5) >
