Board-Folk/Commodore-PC10-III-Reproduction/(commit log)

2024-03-10 Initial Commit
    Initial Commit of the Commodore PC10-III Board Remakes
    [CPU.kicad_sch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]
2024-03-10 update schematics to kicad 7.0.8
    [CPU.kicad_sch, Commodore PC10 III.kicad_sch, EXPANSION.kicad_sch, FDD_HDD_BIOS.kicad_sch, POWER.kicad_sch, PRINTER_SERIAL.kicad_sch, RAM.kicad_sch, VIDEO.kicad_sch]
2024-03-10 PCB updated to kicad v8
2024-03-10 Gerber, Schematics PDF, Layout PDF and Interactive BOM updates
    [Commodore PC10 III-B_Mask.gbr, Commodore PC10 III-B_Paste.gbr, Commodore PC10 III-B_Silkscreen.gbr, Commodore PC10 III-Edge_Cuts.gbr, Commodore PC10 III-F_Mask.gbr, Commodore PC10 III-F_Paste.gbr, Commodore PC10 III-F_Silkscreen.gbr, Commodore PC10 III-NPTH-drl_map.gbr]
2024-03-10 Update Schematics to KiCad V8
    [CPU.kicad_sch, Commodore PC10 III.kicad_sch, EXPANSION.kicad_sch, FDD_HDD_BIOS.kicad_sch, POWER.kicad_sch, PRINTER_SERIAL.kicad_sch, RAM.kicad_sch, REV6_HOLDING.kicad_sch]
2024-03-10 PCB rev6 update kicad v8
2024-03-10 added PAD204 footprint, update PCB
    [FDD_HDD_BIOS.kicad_sch]
2024-03-10 moved footprints to libs
2024-03-10 Rev6 Gerber, Schematic PDF, Layout PDF, Interactive BOM Updates
    [Commodore PC10 III-B_Cu.gbr, Commodore PC10 III-B_Mask.gbr, Commodore PC10 III-B_Paste.gbr, Commodore PC10 III-B_Silkscreen.gbr, Commodore PC10 III-Edge_Cuts.gbr, Commodore PC10 III-F_Cu.gbr, Commodore PC10 III-F_Mask.gbr, Commodore PC10 III-F_Paste.gbr]
2024-03-10 Board images
2024-12-30 Update to latest KiCad 8.0.7
    Update to latest KiCad 8.0.7
    Fix wrong value of R504 should be 1K
    [CPU.kicad_sch, Commodore PC10 III.kicad_sch, EXPANSION.kicad_sch, FDD_HDD_BIOS.kicad_sch, POWER.kicad_sch, PRINTER_SERIAL.kicad_sch, RAM.kicad_sch, REV6_HOLDING.kicad_sch]
2025-01-08 Update iBOM with exclusions and EMI filters
    [CPU.kicad_sch, PRINTER_SERIAL.kicad_sch, REV6_HOLDING.kicad_sch, VIDEO.kicad_sch]
